fariszuh/SKUBI-Pneumatic/Dokumetasi/IMG-20230215-WA0006.jpg

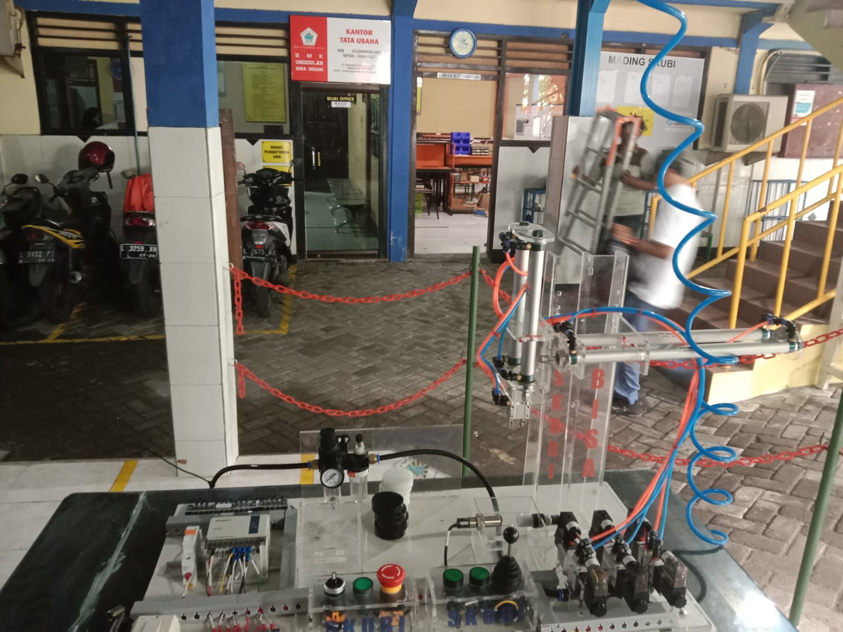
Dokumetasi/IMG-20230215-WA0006.jpg
