fariszuh/SKUBI-Pneumatic/Dokumetasi/IMG-20230215-WA0007.jpg

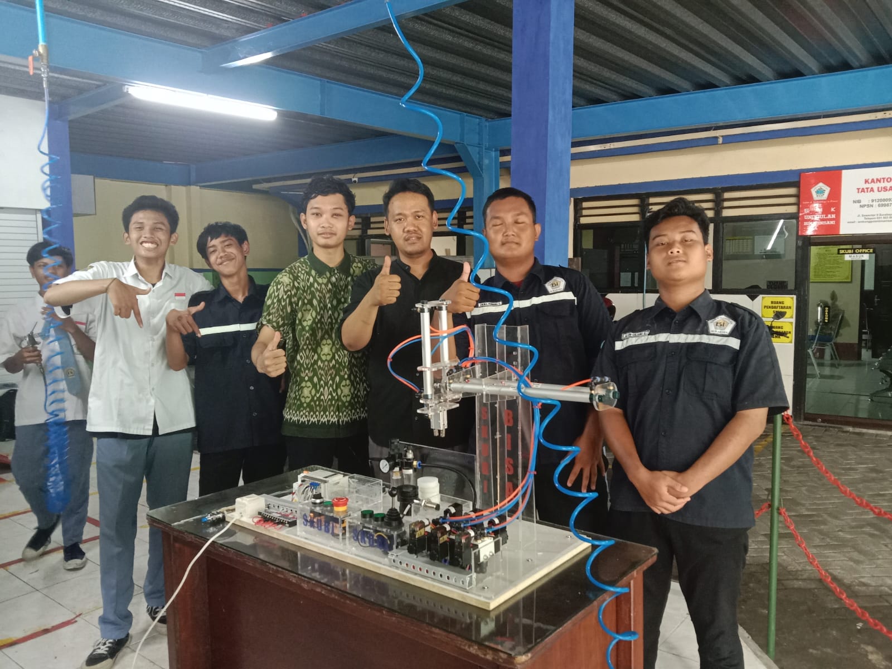
Dokumetasi/IMG-20230215-WA0007.jpg
