fariszuh/SKUBI-Pneumatic/README.md

# SKUBI-Pneumatic
SKUBI Surabaya Pneumatic Pick and Place Module. This project was implemented in SMK Unggulan Bina Insani Surabaya on 2023.
