fariszuh/SKUBI-Pneumatic/File Kirim ke Pak Setya SKUBI/Drawing & Program Book.pdf

# Rev. 0 Published on 17 February 2023

# DRAWING AND PROGRAM

# ELECTRO-PNEUMATIC MODULE

# SMK UNGGULAN BINA INSANI

# SURABAYA

2023

# Rev. 0 Published on 17 February 2023

# Table of Contents:

1. Drawing Sheet 1: Power Distribution from Inlet Steker to PLC 2. Drawing Sheet 2: Digital Input for MELSEC PLC 3. Drawing Sheet 3: Digital Output and 12V Distribution 4. Drawing Sheet 4: Pneumatic Component and Its Flow 5. Drawing Sheet 5: Input Terminal for COM/0V Distribution 6. Ladder Program in GX Works 2

# For further information:

# Muhammad Faris Zuhairi

0821 4345 9880

# zuhairimuhammadfaris@gmail.com

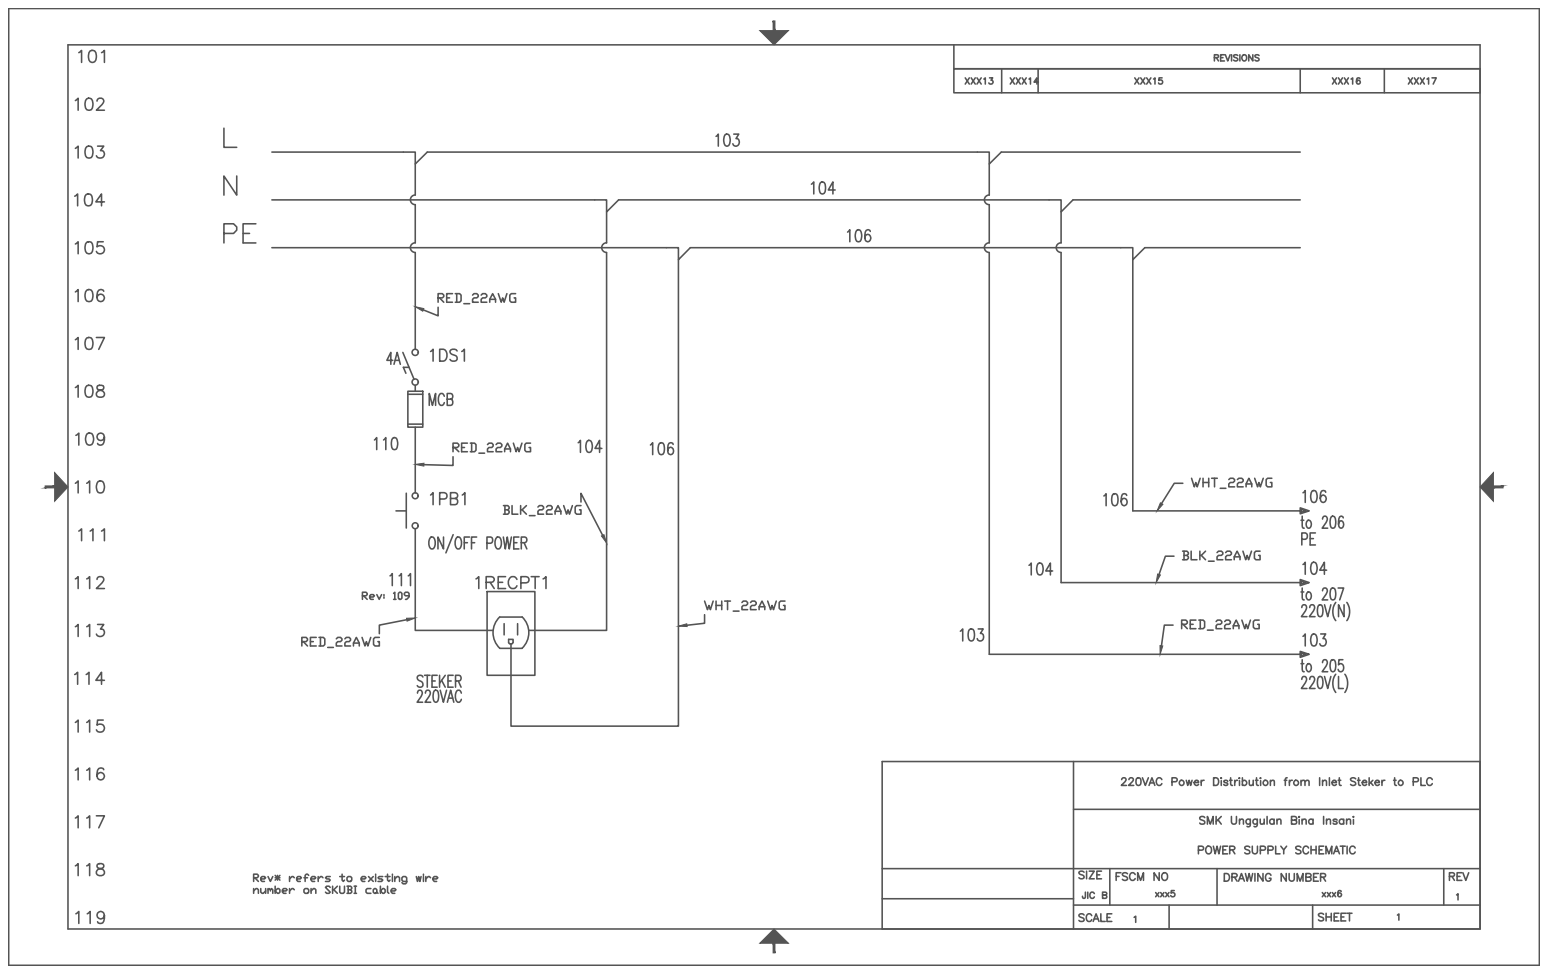
[picture p3: page 3]

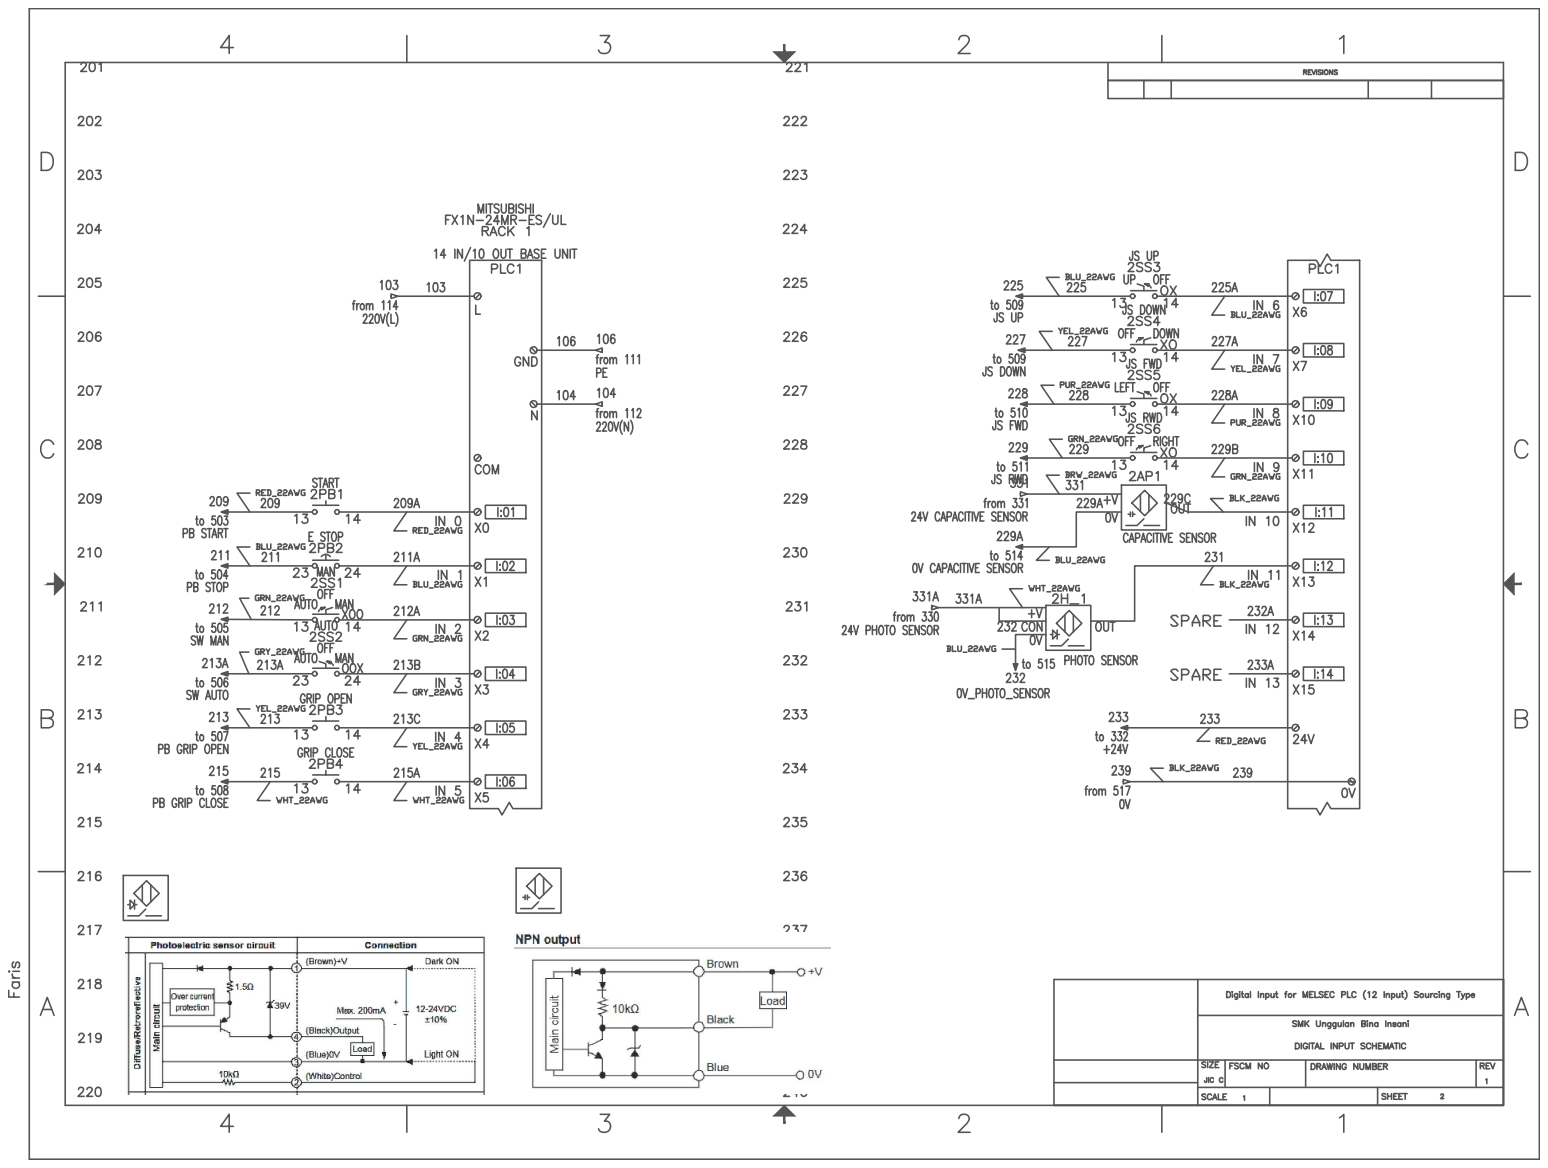
[picture p4: page 4]

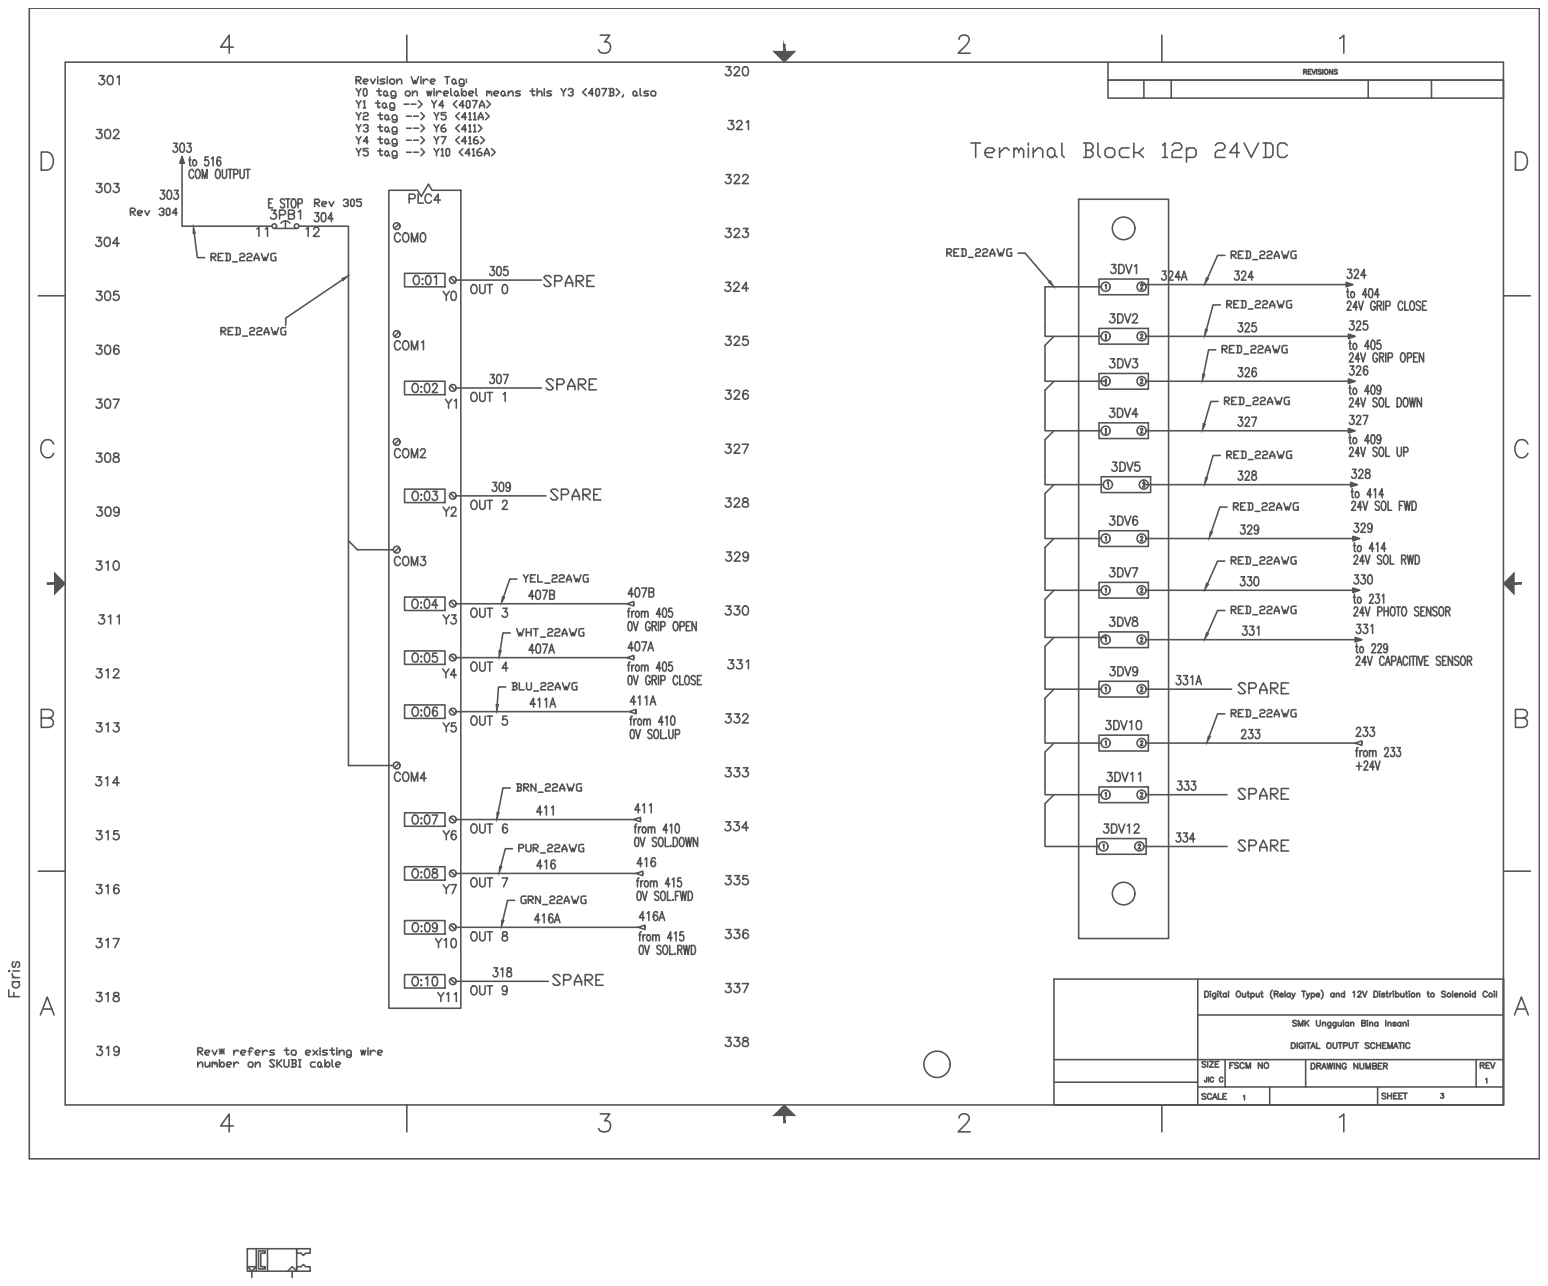
[picture p5: page 5]

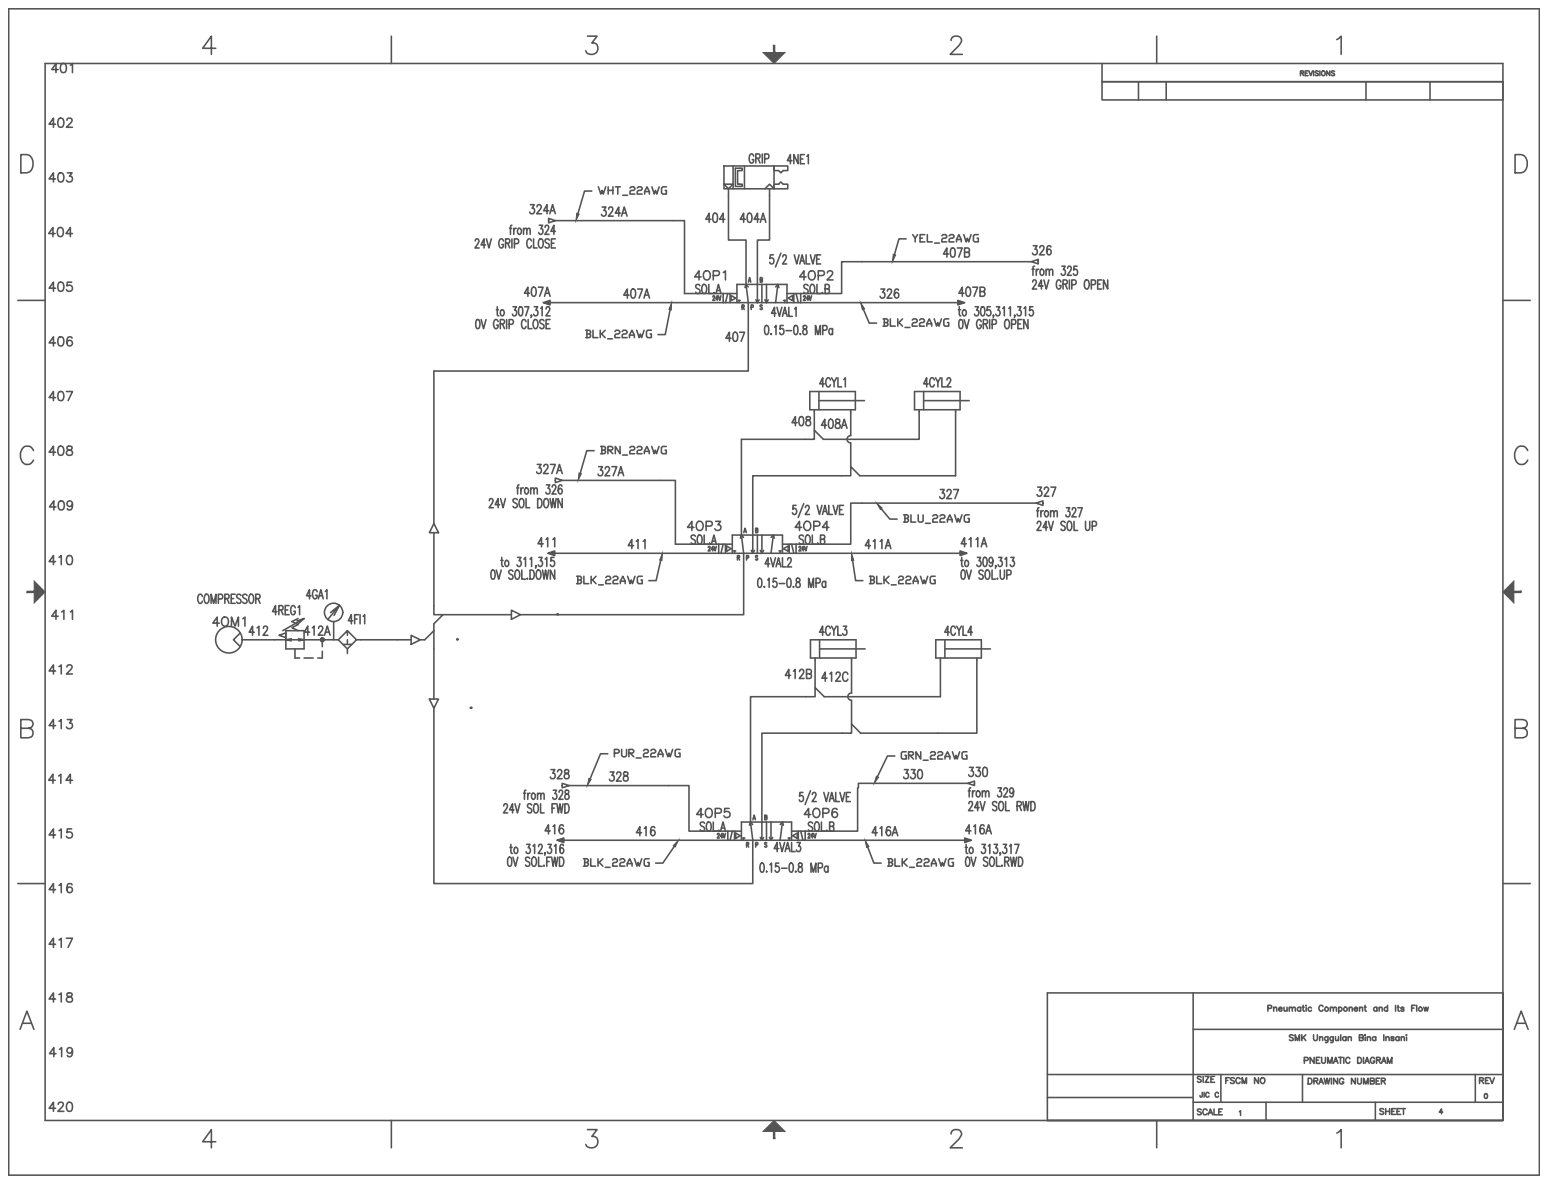
[picture p6: page 6]

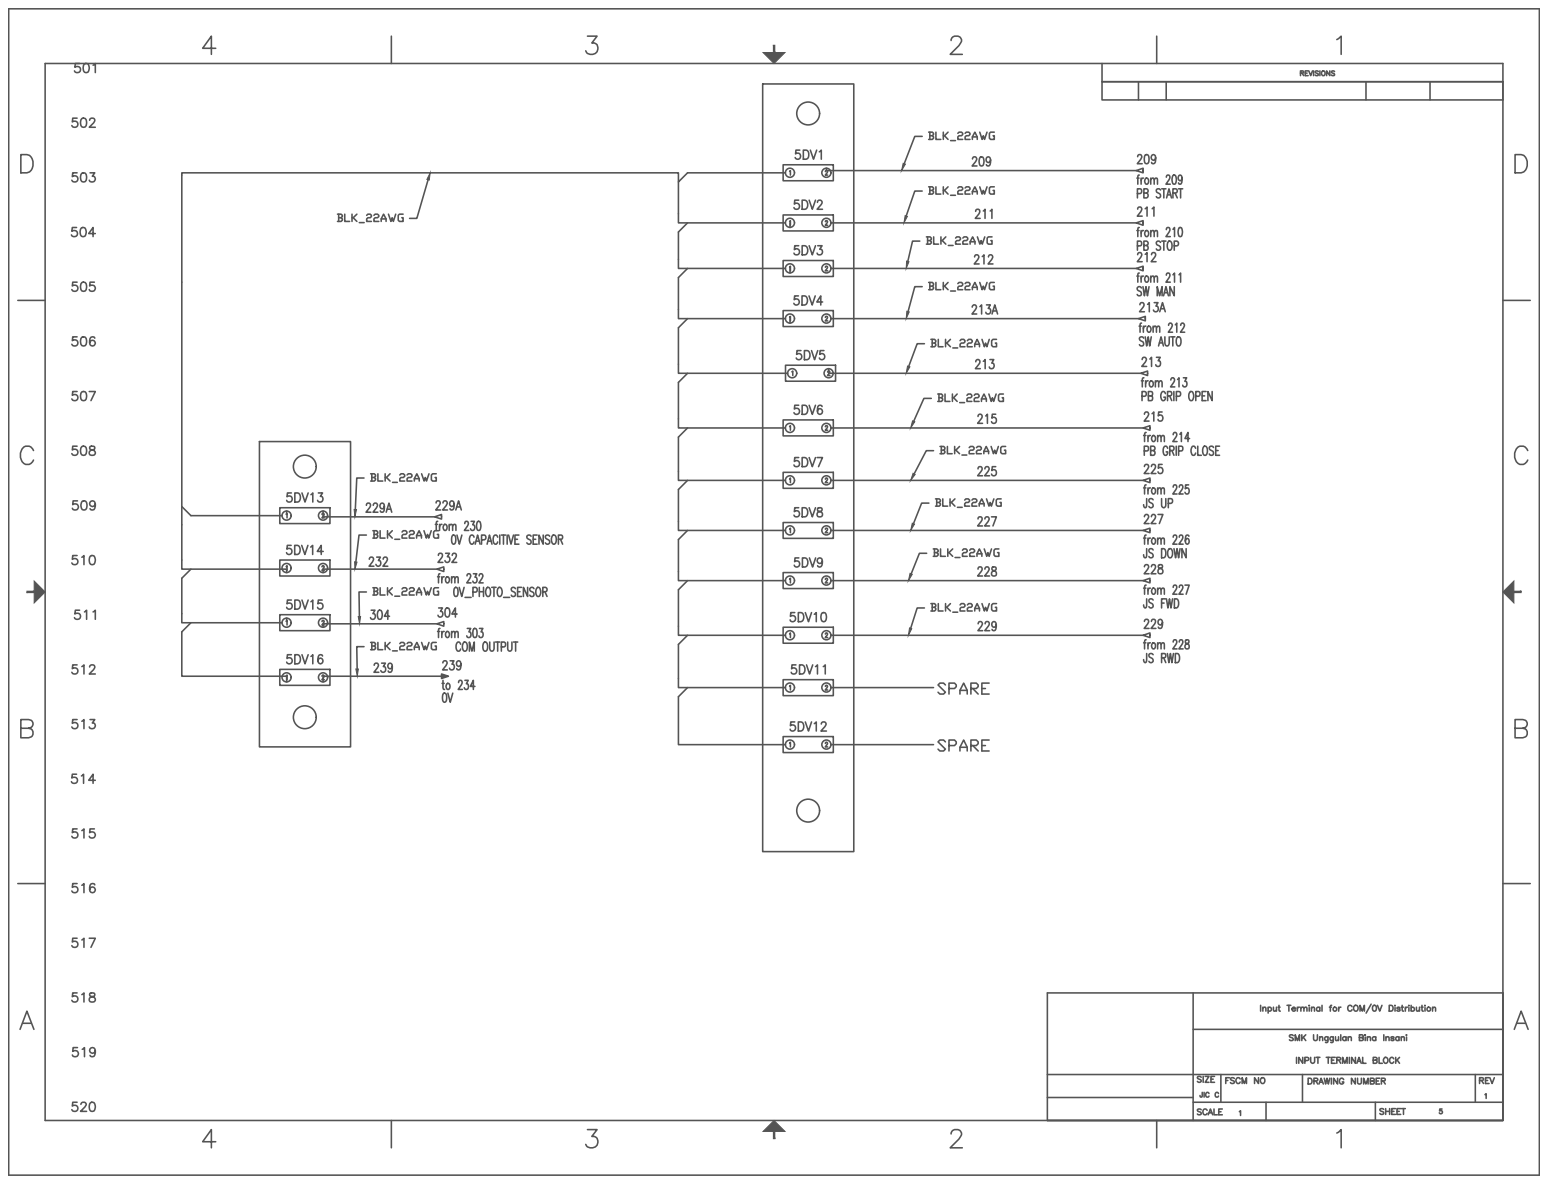
[picture p7: page 7]

# MELSEC FX1N-24MR Program for Electro-Pneumatic Module SKUBI

# Designed with Ladder

# Prepared By Faris

# Published on 17 February 2023

PLC Parameter | 2/17/2023

# Data Name : Memory Capacity Memory Capacity

# [Memory Capacity]

8000

# [Program Capacity] 8000 Steps

# [Comments Capacity] 0 Block 0 Points

# [File Register Capacity 0 Block 0 Points

1

PLC Parameter | 2/17/2023

# Data Name : PLC System PLC System

# [Battery Less Mode]

# [MODEM Initialized] None

# [RUN Terminal Input] None

2

Program setting | 2/17/2023

# Data Name : Program setting

Execution type | Program file name [Title]
Execution Program | MAIN

3

Ladder | 2/17/2023

# Data Name : MAIN

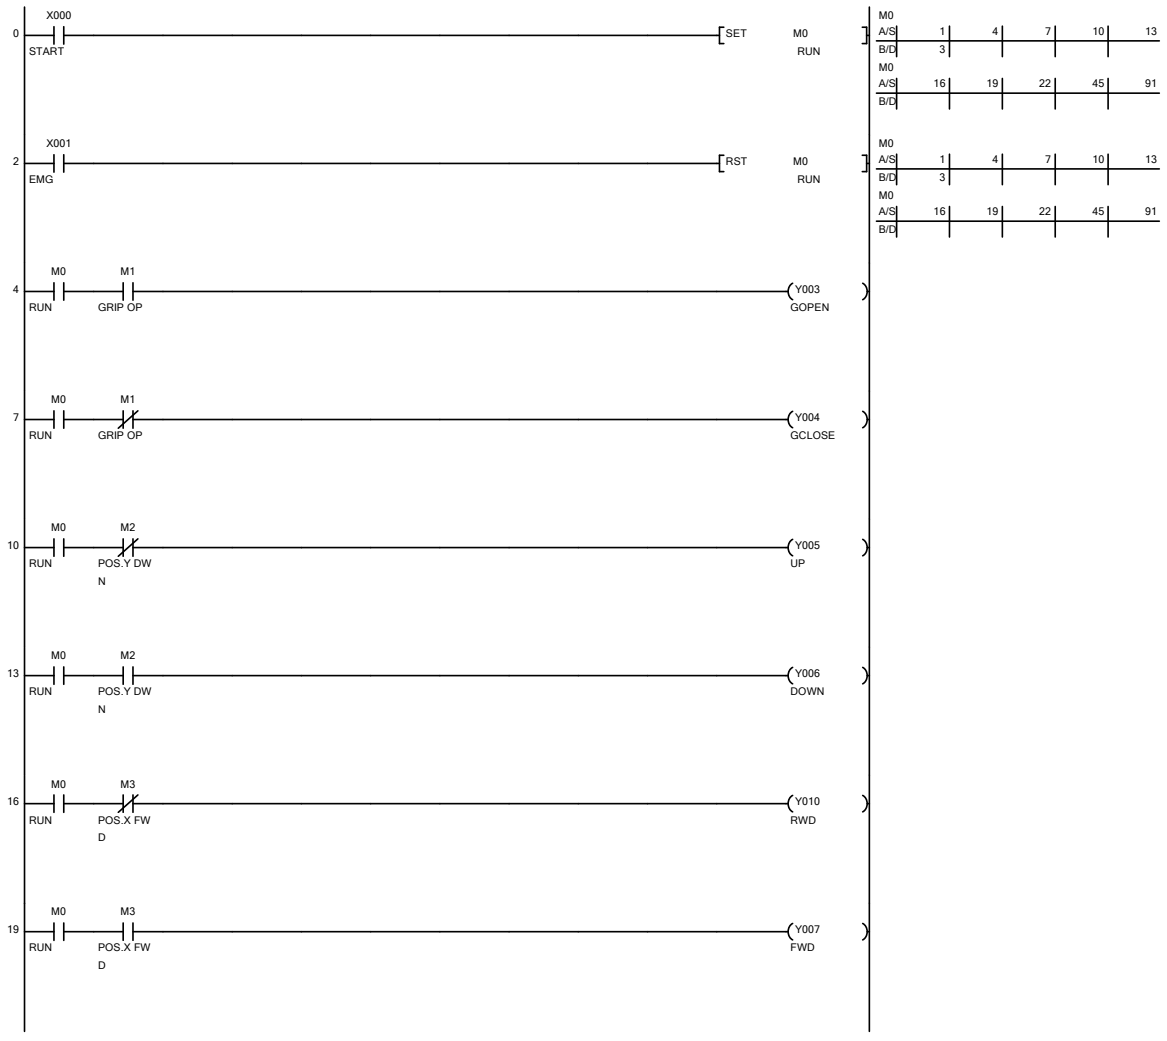
[picture p8: figure]
START; SET; RUN; EMG; RST; GRIP OP; Y003 GOPEN; Y004 GCLOSE; POS.Y DW N; Y006 DOWN; POS.X FW D; Y010 RWD; Y007 FWD

4

22

M0

RUN

X002

MAN

X004

GOPEN

SET | M1
GRIP OP

M1
A/S | 5 | 26 | 60 | 62
B/D | 8 | 29 | 86

X005

GCLOSE

RST | M1
GRIP OP

M1
A/S | 5 | 26 | 60 | 62
B/D | 8 | 29 | 86

X007

JS_DOWN

SET | M2
POS.Y DW
N

M2
A/S | 14 | 32 | 73 | 75
B/D | 11 | 35 | 105

X006

JS_UP

RST | M2
POS.Y DW
N

M2
A/S | 14 | 32 | 73 | 75
B/D | 11 | 35 | 105

X010

JS_FWD

SET | M3
POS.X FW
D

M3
A/S | 20 | 38 | 57 | 70 | 83
B/D | 17 | 41 | 54 | 68 | 81
M3
A/S | 89 | 102 | 114 | 116
B/D | 100 | 123

X011

JS_RWD

RST | M3
POS.X FW
D

M3
A/S | 20 | 38 | 57 | 70 | 83
B/D | 17 | 41 | 54 | 68 | 81
M3
A/S | 89 | 102 | 114 | 116
B/D | 100 | 123

42

X012

SEN_CAP

X013

SEN_PH

SET | M4
ADA_BEND
A

M4
A/S | 44 | 48 | 82 | 113
B/D | 90 | 122
Ladder | 2/17/2023

# Data Name : MAIN

5

Ladder | 2/17/2023

# Data Name : MAIN

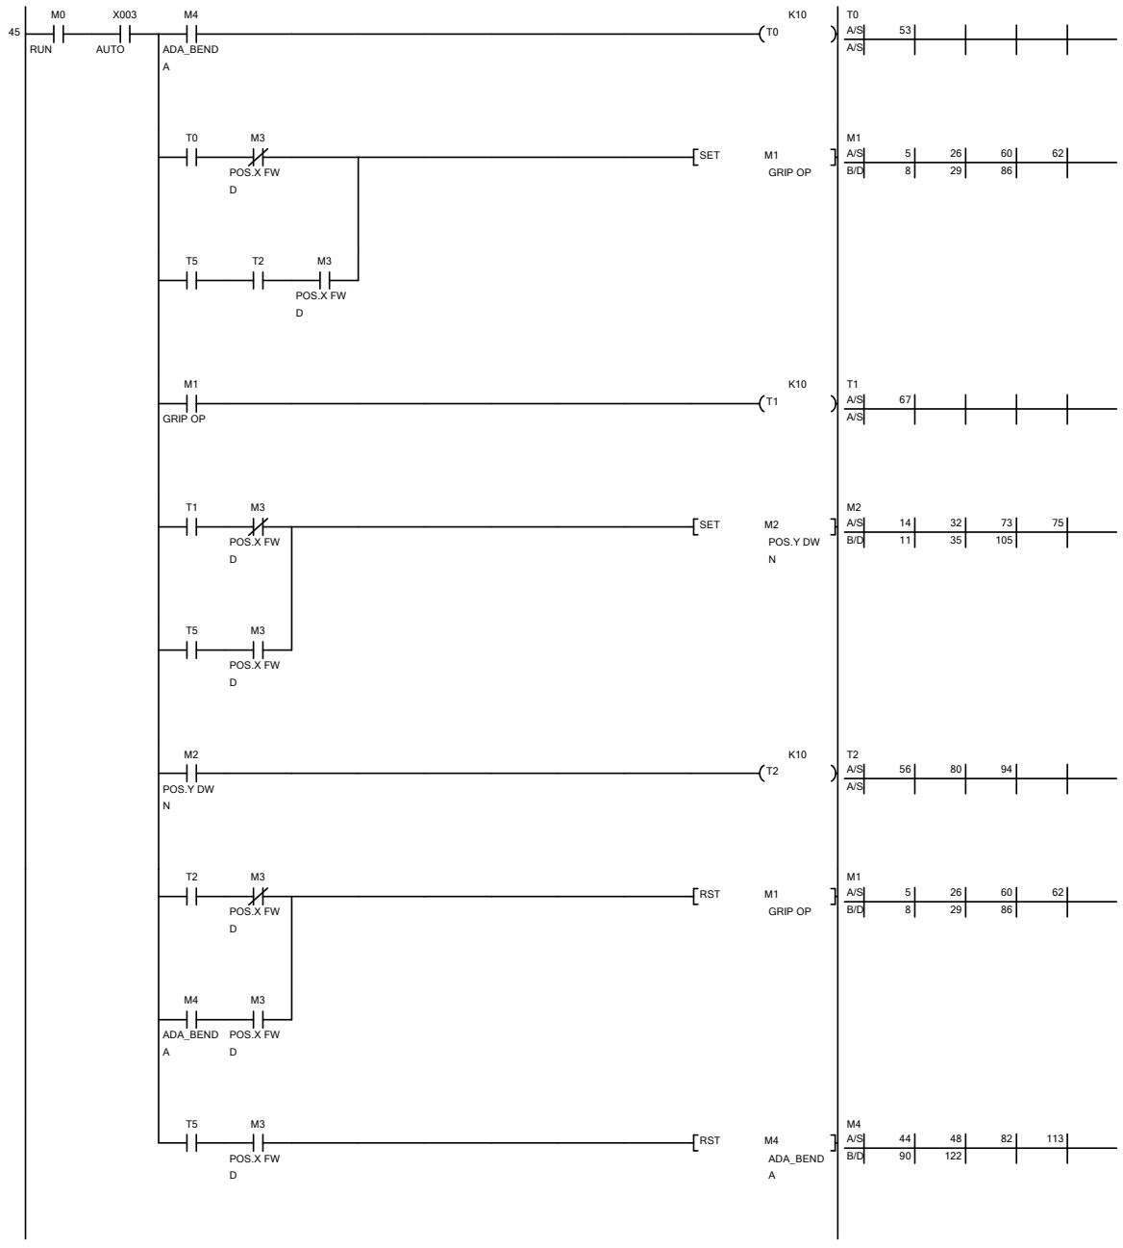
[picture p9: figure]
RUN; AUTO; ADA_BEND A; POS.X FW D; SET; GRIP OP; POS.Y DW N; RST

6

Ladder | 2/17/2023

# Data Name : MAIN

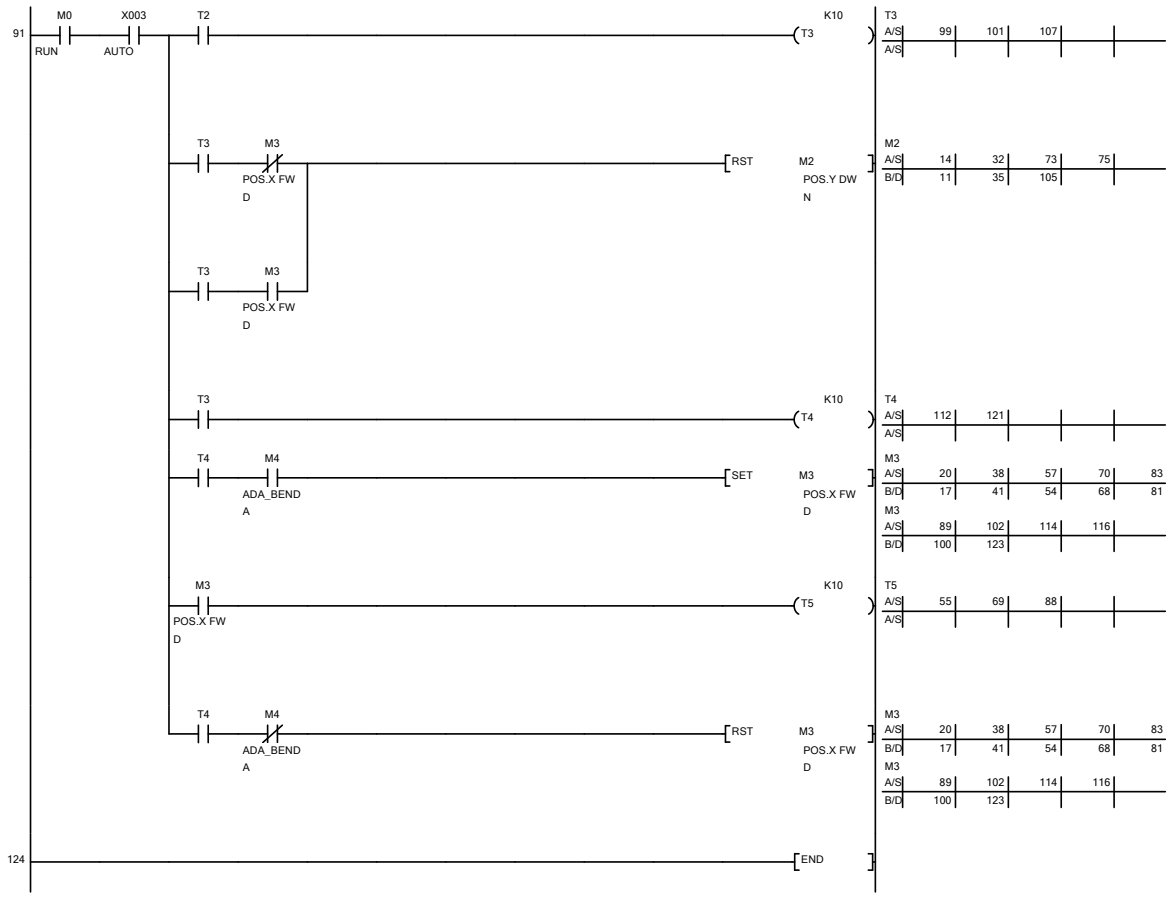
[picture p10: figure]
RUN; AUTO; POS.X FW D; RST; POS.Y DW N; ADA_BEND A; SET; 124 END

7

Device Comment | 2/17/2023

# Data Name : COMMENT

Device Name | Comment
M0 | RUN
M1 | GRIP OP
M2 | POS.Y DWN
M3 | POS.X FWD
M4 | ADA_BENDA
X000 | START
X001 | EMG
X002 | MAN
X003 | AUTO
X004 | GOPEN
X005 | GCLOSE
X006 | JS_UP
X007 | JS_DOWN
X010 | JS_FWD
X011 | JS_RWD
X012 | SEN_CAP
X013 | SEN_PH
Y003 | GOPEN
Y004 | GCLOSE
Y005 | UP
Y006 | DOWN
Y007 | FWD
Y010 | RWD

8

TC Setting | 2/17/2023

# Data Name : MAIN

Position | Device | Setting Value
( 49) T0 | | K10
( 63) T1 | | K10
( 76) T2 | | K10
( 95) T3 | | K10
( 108) T4 | | K10
( 117) T5 | | K10

9

Device List | 2/17/2023

# Data Name : Device List

# Find In:(Entire project) Find What:Used Device (Contact & Coil) Print Range:Whole Range

# *:in use (times): the number of coil uses

Device | Contact | Coil | Parameter | Comment
M0 | * | *( 2) | | RUN
M1 | * | *( 4) | | GRIP OP
M2 | * | *( 4) | | POS.Y DWN
M3 | * | *( 4) | | POS.X FWD
M4 | * | *( 2) | | ADA_BENDA
T0 | * | *( 1)
T1 | * | *( 1)
T2 | * | *( 1)
T3 | * | *( 1)
T4 | * | *( 1)
T5 | * | *( 1)

10

Project Contents List | 2/17/2023

# Data Name : Project Contents List Workspace Name : Project Name : SKUBI_program_work_simplified Title :

Data Name | Last Change | Title
Parameter | 2/1/2023 8:41:58 PM
PLC Parameter | 2/1/2023 8:41:58 PM
Global Device Comment | 2/15/2023 12:51:23 AM

### Program Setting Execution Program

MAIN | 2/1/2023 8:42:03 PM
MAIN | 2/15/2023 12:54:52 AM

### POU

Program | 2/1/2023 8:42:03 PM
MAIN | 2/15/2023 12:54:52 AM

### Local Device Comment

Device Memory | 2/1/2023 8:42:05 PM
MAIN | 2/1/2023 8:42:05 PM

11
