fariszuh/SKUBI-Pneumatic/PLC MELSEC/Ladder Pneumatik Faris.pdf

# Title

# Comment

# Prepared By

# Date

PLC Parameter | 2/2/2023

# Data Name : Memory Capacity Memory Capacity

# [Memory Capacity]

8000

# [Program Capacity] 8000 Steps

# [Comments Capacity] 0 Block 0 Points

# [File Register Capacity 0 Block 0 Points

1

PLC Parameter | 2/2/2023

# Data Name : PLC System PLC System

# [Battery Less Mode]

# [MODEM Initialized] None

# [RUN Terminal Input] None

2

Program setting | 2/2/2023

# Data Name : Program setting

Execution type | Program file name [Title]
Execution Program | MAIN

3

Ladder | 2/2/2023

# Data Name : MAIN

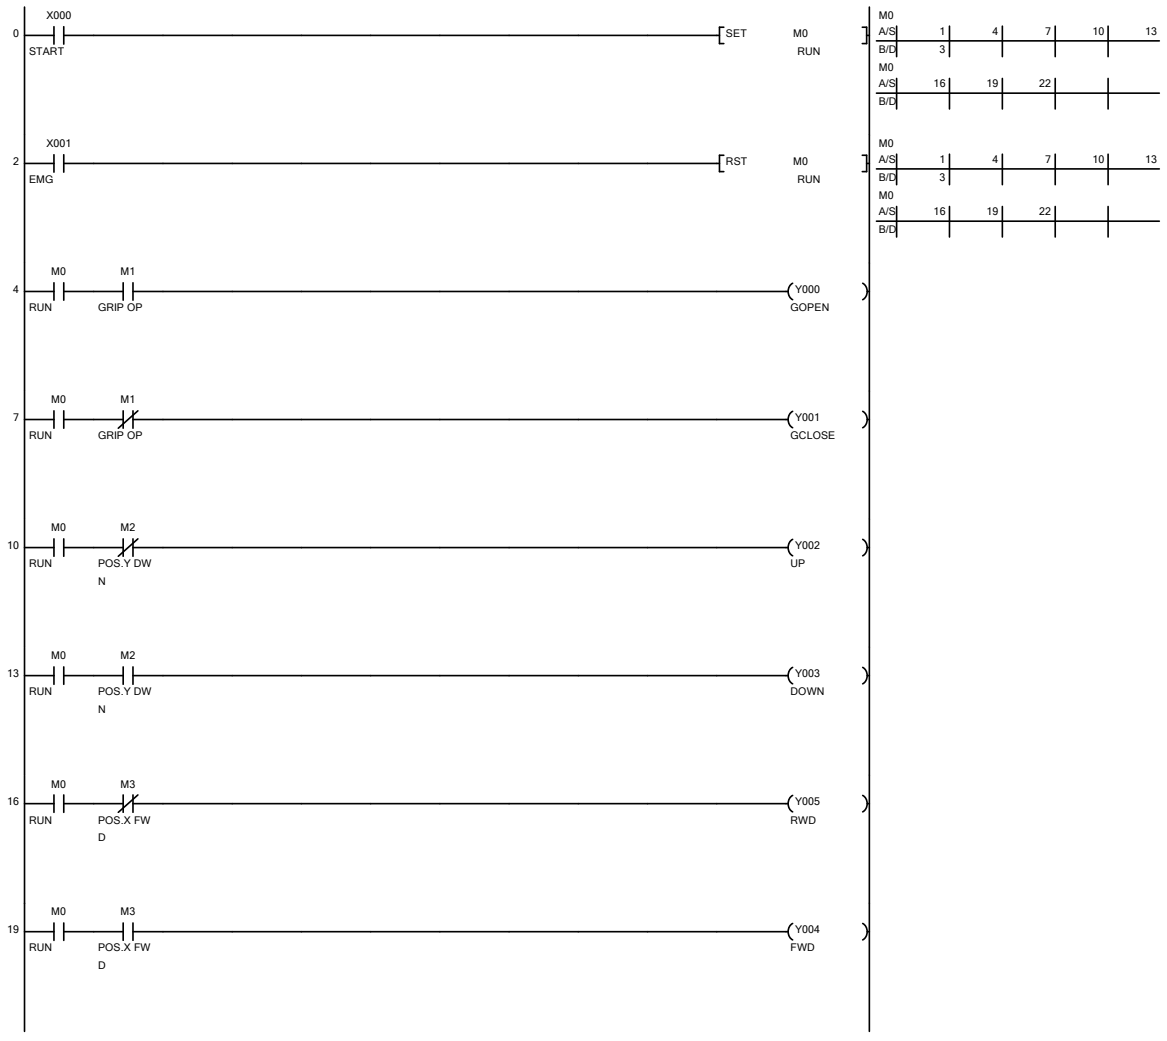
[picture p11: figure]
START; SET; RUN; EMG; RST; GRIP OP; Y000 GOPEN; Y001 GCLOSE; POS.Y DW N; Y003 DOWN; POS.X FW D; Y005 RWD; Y004 FWD

4

Ladder | 2/2/2023

# Data Name : MAIN

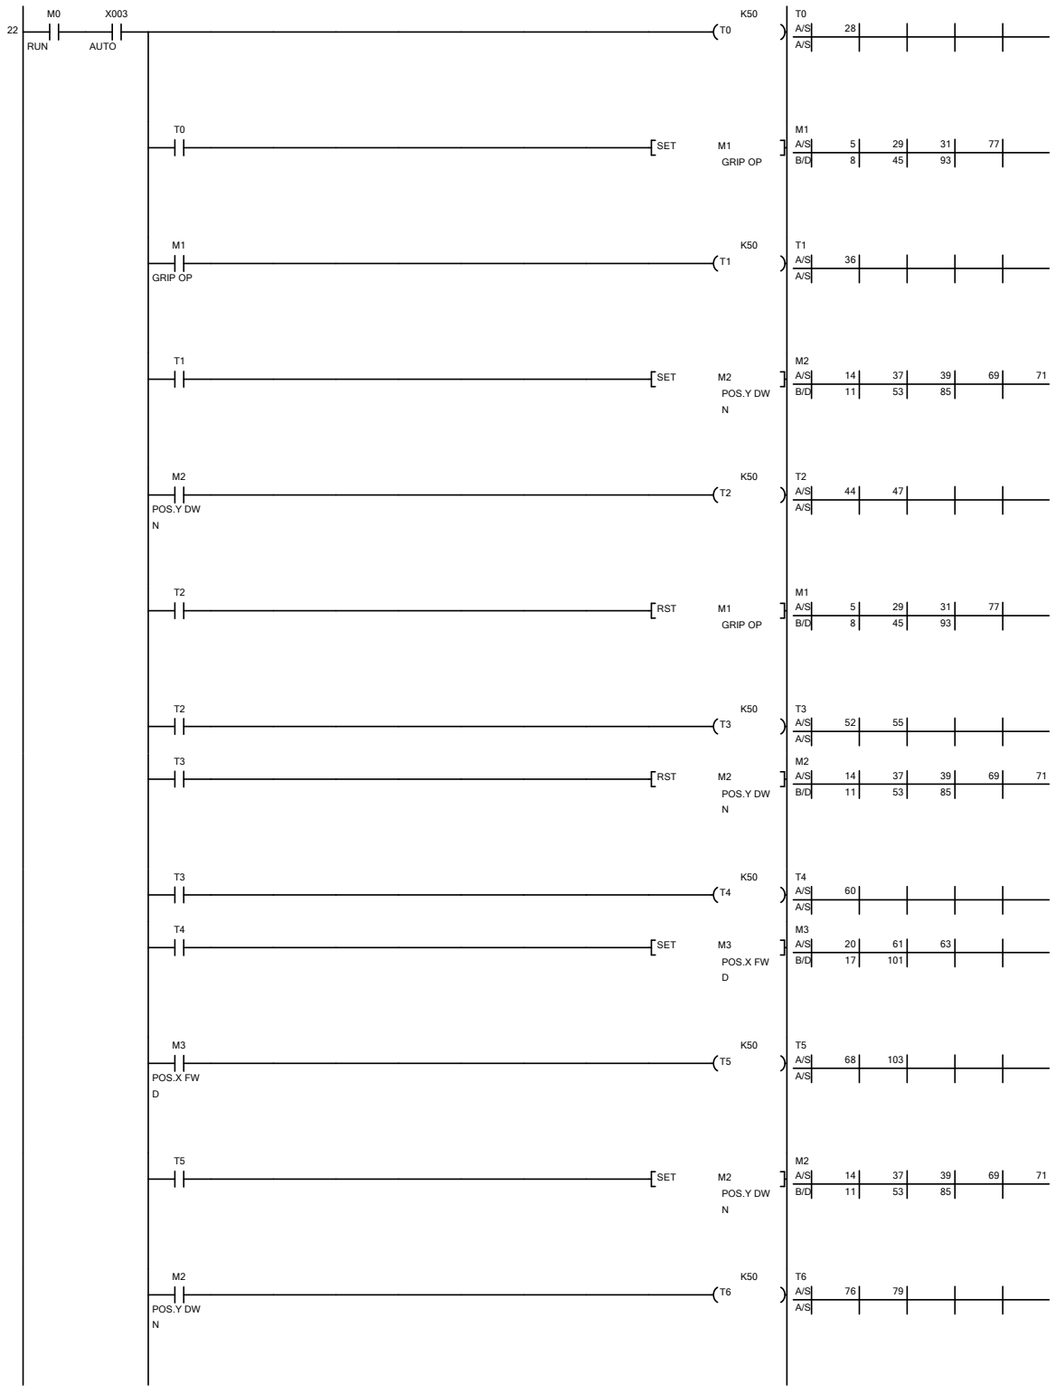
[picture p12: figure]
RUN; AUTO; SET; GRIP OP; POS.Y DW N; RST; POS.X FW D

5

Ladder | 2/2/2023

# Data Name : MAIN

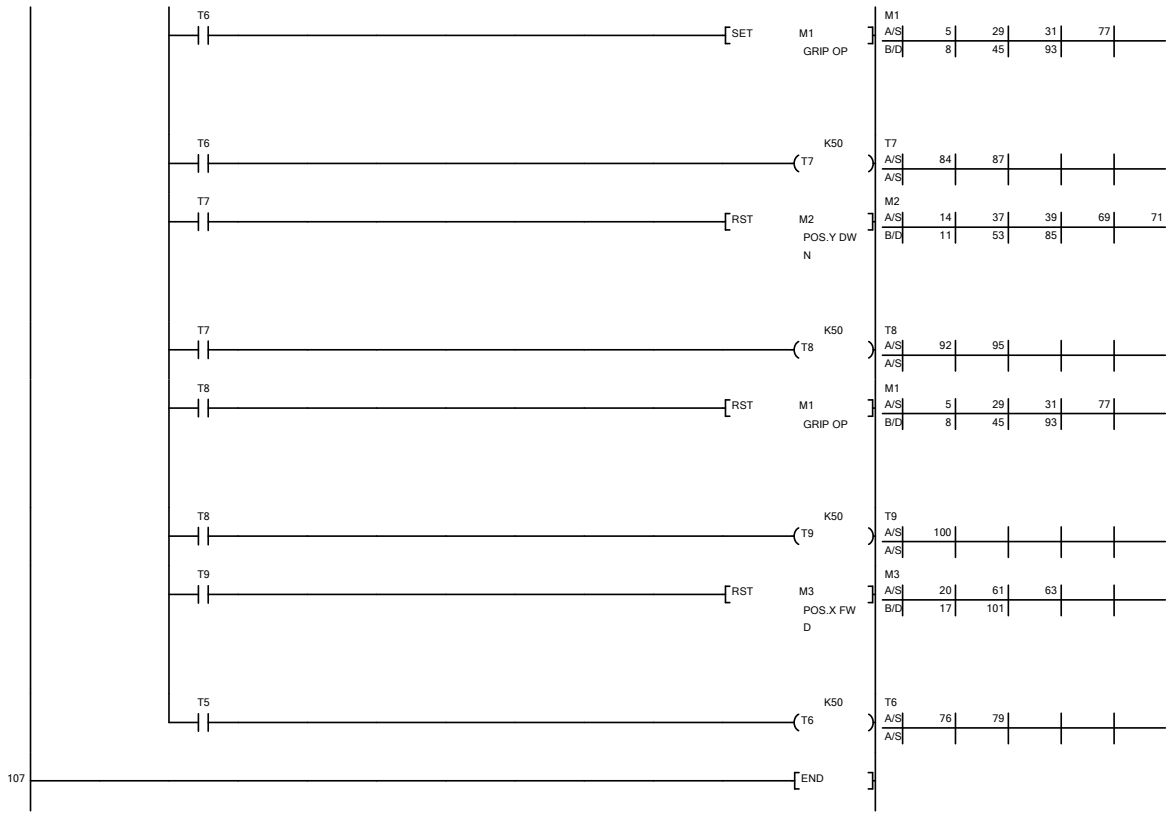
[picture p13: figure]
SET; GRIP OP; RST; POS.Y DW N; POS.X FW D; 107 END

6

Device Comment | 2/2/2023

# Data Name : COMMENT

Device Name | Comment
M0 | RUN
M1 | GRIP OP
M2 | POS.Y DWN
M3 | POS.X FWD
X000 | START
X001 | EMG
X002 | MAN
X003 | AUTO
X004 | GOPEN
X005 | GCLOSE
X006 | JS_UP
X007 | JS_DOWN
X010 | JS_FWD
X011 | JS_RWD
Y000 | GOPEN
Y001 | GCLOSE
Y002 | UP
Y003 | DOWN
Y004 | FWD
Y005 | RWD

7

TC Setting | 2/2/2023

# Data Name : MAIN

Position | Device | Setting Value
( 24) T0 | | K50
( 32) T1 | | K50
( 40) T2 | | K50
( 48) T3 | | K50
( 56) T4 | | K50
( 64) T5 | | K50
( 72) T6 | | K50
( 80) T7 | | K50
( 88) T8 | | K50
( 96) T9 | | K50
( 104) T6 | | K50

8

Device List | 2/2/2023

# Data Name : Device List

# Find In:(Entire project) Find What:Used Device (Contact & Coil) Print Range:Whole Range

# *:in use (times): the number of coil uses

Device | Contact | Coil | Parameter | Comment
M0 | * | *( 2) | | RUN
M1 | * | *( 4) | | GRIP OP
M2 | * | *( 4) | | POS.Y DWN
M3 | * | *( 2) | | POS.X FWD
T0 | * | *( 1)
T1 | * | *( 1)
T2 | * | *( 1)
T3 | * | *( 1)
T4 | * | *( 1)
T5 | * | *( 1)
T6 | * | *( 2)
T7 | * | *( 1)
T8 | * | *( 1)
T9 | * | *( 1)

9

Project Contents List | 2/2/2023

# Data Name : Project Contents List Workspace Name : Project Name : SKUBI_program_worked Title :

Data Name | Last Change | Title
Parameter | 2/1/2023 8:41:58 PM
PLC Parameter | 2/1/2023 8:41:58 PM
Global Device Comment | 2/2/2023 12:32:41 AM

### Program Setting Execution Program

MAIN | 2/1/2023 8:42:03 PM
MAIN | 2/2/2023 1:14:20 AM

### POU

Program | 2/1/2023 8:42:03 PM
MAIN | 2/2/2023 1:14:20 AM

### Local Device Comment

Device Memory | 2/1/2023 8:42:05 PM
MAIN | 2/1/2023 8:42:05 PM

10
