fariszuh/SKUBI-Pneumatic/Ladder Design.pdf

# noname00.src

# Program

2023.1.24

## c:\gmwin 4\\source\skubi_v1\noname00.src

## º¯¼ö

1

Variable name | Variable kind | Data type | (Memory allocation) (Initial value)
BT_AUTO | VAR | BOOL AT %IX0.0.3
BT_EMG | VAR | BOOL AT %IX0.0.1
BT_GRIP_CLOSE VAR | | BOOL AT %IX0.0.5
BT_GRIP_OPEN | VAR | BOOL AT %IX0.0.4
BT_MAN | VAR | BOOL AT %IX0.0.2
BT_START | VAR | BOOL AT %IX0.0.0
CO_DOWN | VAR | BOOL AT %QX0.2.3
CO_FWD | VAR | BOOL AT %QX0.2.4
CO_GRIP_CLOSE VAR | | BOOL AT %QX0.2.1
CO_GRIP_OPEN | VAR | BOOL AT %QX0.2.0
CO_RWD | VAR | BOOL AT %QX0.2.5
CO_UP | VAR | BOOL AT %QX0.2.2
INST0 | VAR | FB Instance
INST1 | VAR | FB Instance
INST10 | VAR | FB Instance
INST11 | VAR | FB Instance
INST12 | VAR | FB Instance
INST13 | VAR | FB Instance
INST14 | VAR | FB Instance
INST15 | VAR | FB Instance
INST2 | VAR | FB Instance
INST3 | VAR | FB Instance
INST4 | VAR | FB Instance
INST5 | VAR | FB Instance
INST6 | VAR | FB Instance
INST7 | VAR | FB Instance
INST8 | VAR | FB Instance
INST9 | VAR | FB Instance
JS_DOWN | VAR | BOOL AT %IX0.0.7
JS_FWD | VAR | BOOL AT %IX0.0.8
JS_RWD | VAR | BOOL AT %IX0.0.9
JS_UP | VAR | BOOL AT %IX0.0.6
MEM_ADABENDA VAR | | BOOL
MEM_DOWN_AMBILVAR | | BOOL
MEM_DOWN_MANVAR | | BOOL
MEM_DOWN_TARUHVAR | | BOOL
MEM_FWD_AMBILVAR | | BOOL
MEM_FWD_MAN VAR | BOOL

## c:\gmwin 4\\source\skubi_v1\noname00.src

## º¯¼ö

2

Variable name | Variable kind | Data type | (Memory allocation) (Initial value)
MEM_GCLOSE_AMBIL VAR | | BOOL
MEM_GCLOSE_MANVAR | | BOOL
MEM_GCLOSE_TARUH VAR | | BOOL
MEM_GOPEN_AMBILVAR | | BOOL
MEM_GOPEN_MANVAR | | BOOL
MEM_GOPEN_TARUH VAR | | BOOL
MEM_MODEMAN | VAR | BOOL
MEM_MODERESETVAR | | BOOL
MEM_RWD_MAN | VAR | BOOL
MEM_RWD_TARUHVAR | | BOOL
MEM_STAT_RUN | VAR | BOOL
MEM_TARUHBENDAVAR | | BOOL
MEM_UP_AMBIL | VAR | BOOL
MEM_UP_MAN | VAR | BOOL
MEM_UP_TARUH VAR | | BOOL
SELESAI | VAR | BOOL
SEN_CAP | VAR | BOOL AT %IX0.0.11
SEN_PH | VAR | BOOL AT %IX0.0.10

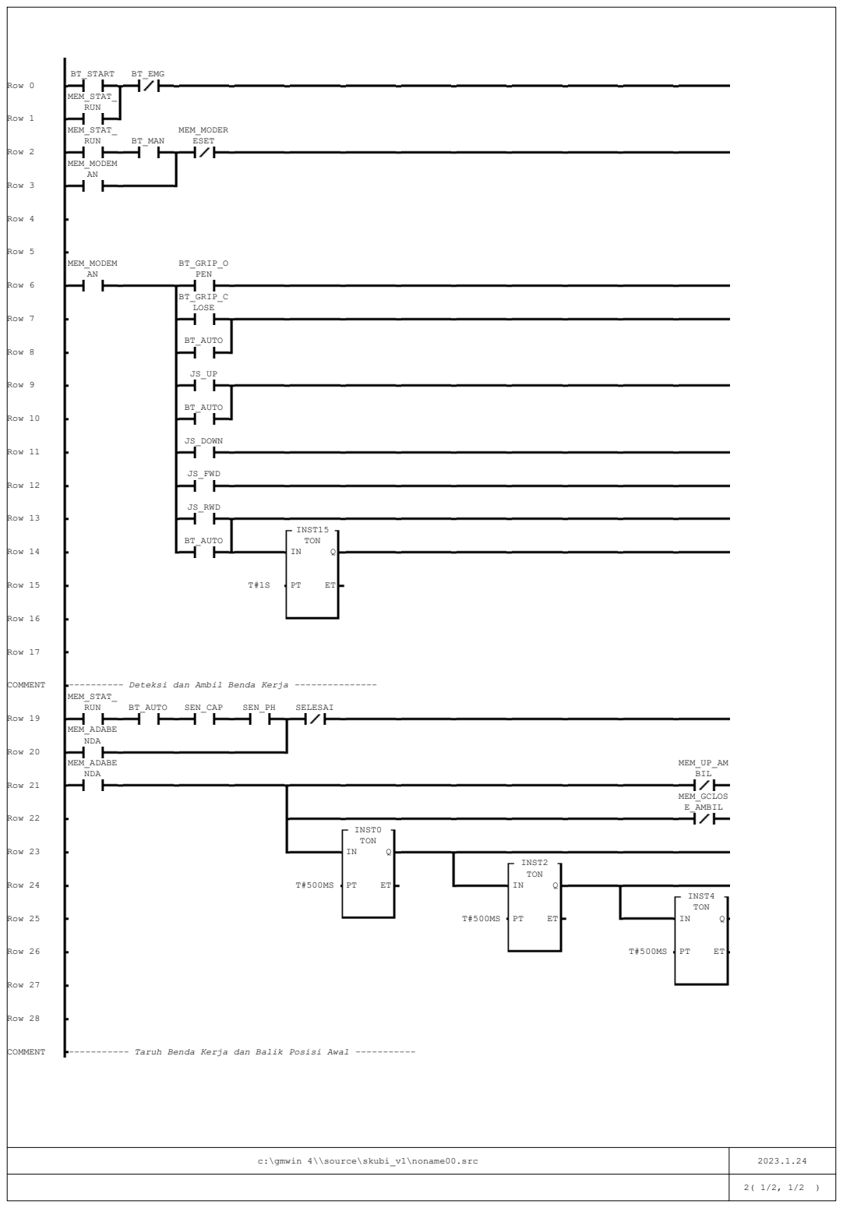
[picture p20: page 4]

c:\gmwin 4\\source\skubi_v1\noname00.src | 2023.1.24
| 2( 1/2, 1/2 )

Row 0

BT_START BT_EMG

Row 1

MEM_STAT_
RUN

Row 2

MEM_STAT_
RUN BT_MAN

MEM_MODER
ESET

Row 3

MEM_MODEM
AN

Row 4

Row 5

Row 6

MEM_MODEM
AN

BT_GRIP_O
PEN

Row 7

BT_GRIP_C
LOSE

Row 8

BT_AUTO

Row 9

JS_UP

Row 10

BT_AUTO

Row 11

JS_DOWN

Row 12

JS_FWD

Row 13

JS_RWD

Row 14

BT_AUTO | TON
IN | Q

INST15

Row 15 | T#1S | PT | ET

Row 16

Row 17

COMMENT ---------- Deteksi dan Ambil Benda Kerja ---------------

Row 19

MEM_STAT_
RUN | BT_AUTO | SEN_CAP | SEN_PH | SELESAI

Row 20

MEM_ADABE
NDA

Row 21

MEM_ADABE
NDA

MEM_UP_AM
BIL

Row 22

MEM_GCLOS
E_AMBIL

Row 23

TON
IN Q

INST0

Row 24 | T#500MS PT | ET

TON
IN Q

INST2

Row 25 | T#500MS PT | ET

TON
IN Q

INST4

Row 26 | T#500MS PT | ET

Row 27

Row 28

COMMENT ----------- Taruh Benda Kerja dan Balik Posisi Awal -----------

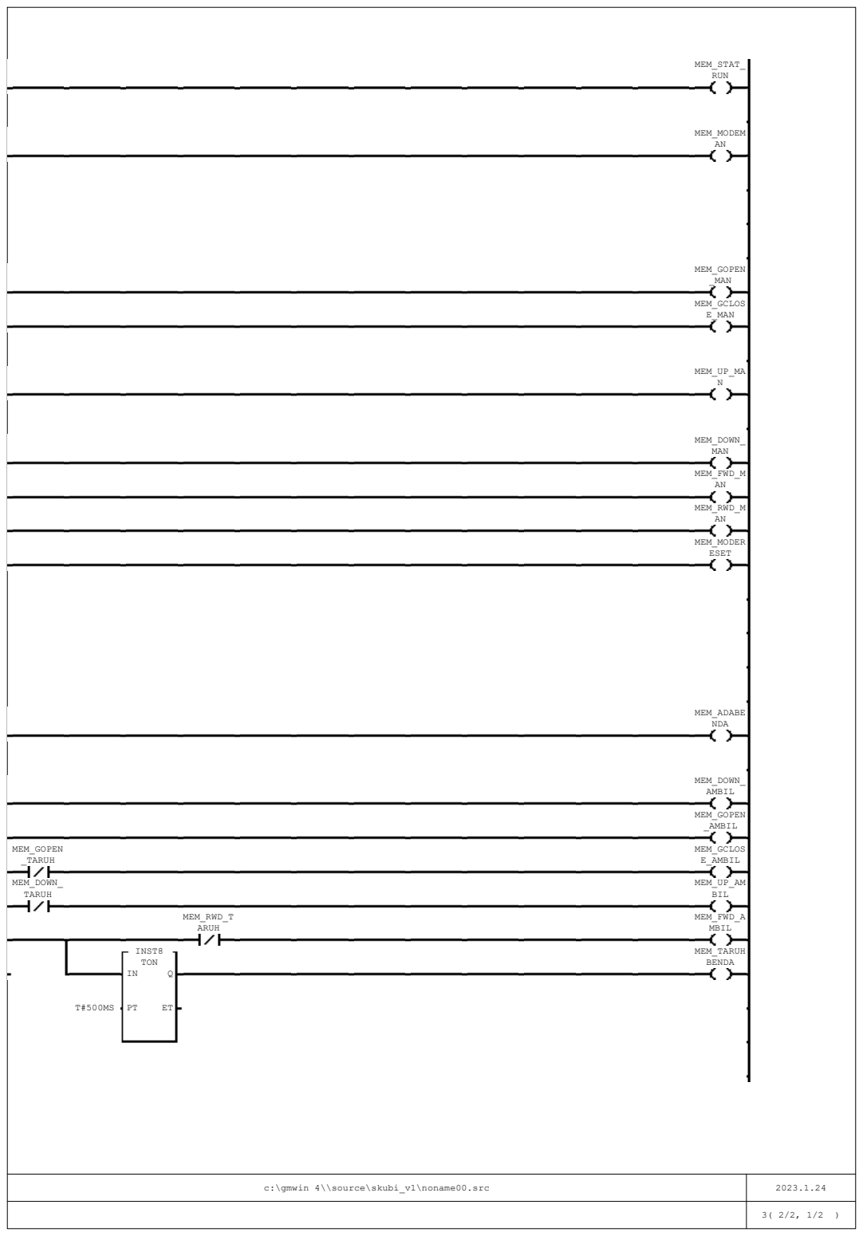
[picture p21: page 5]

3( 2/2, 1/2 )

MEM_STAT_
RUN

MEM_MODEM
AN

MEM_GOPEN
_MAN

MEM_GCLOS
E_MAN

MEM_UP_MA
N

MEM_DOWN_
MAN

MEM_FWD_M
AN

MEM_RWD_M
AN

MEM_MODER
ESET

MEM_ADABE
NDA

MEM_DOWN_
AMBIL

MEM_GOPEN
_AMBIL

MEM_GOPEN
_TARUH

MEM_GCLOS
E_AMBIL

MEM_DOWN_
TARUH

MEM_UP_AM
BIL

MEM_RWD_T
ARUH

MEM_FWD_A
MBIL

TON
IN | Q
INST8 | MEM_TARUH
| BENDA
T#500MS PT | ET

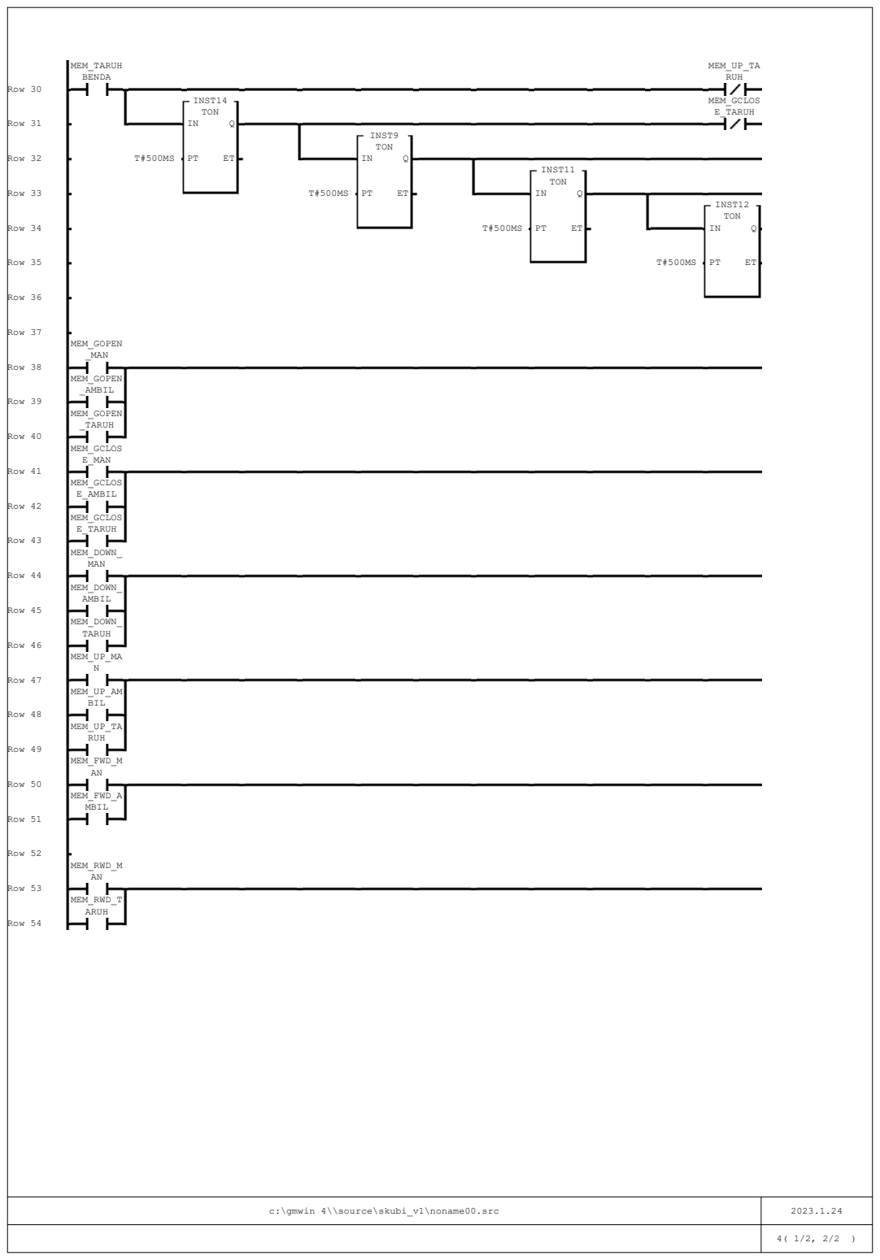
[picture p22: page 6]

4( 1/2, 2/2 )

Row 30

MEM_TARUH
BENDA

MEM_UP_TA
RUH

Row 31

TON
IN | Q
INST14 | MEM_GCLOS
| E_TARUH
Row 32 | T#500MS PT | ET

TON
IN Q

INST9

Row 33 | T#500MS PT | ET

TON
IN Q

INST11

Row 34 | T#500MS PT | ET

TON
IN Q

INST12

Row 35 | T#500MS PT | ET

Row 36

Row 37

Row 38

MEM_GOPEN
_MAN

Row 39

MEM_GOPEN
_AMBIL

Row 40

MEM_GOPEN
_TARUH

Row 41

MEM_GCLOS
E_MAN

Row 42

MEM_GCLOS
E_AMBIL

Row 43

MEM_GCLOS
E_TARUH

Row 44

MEM_DOWN_
MAN

Row 45

MEM_DOWN_
AMBIL

Row 46

MEM_DOWN_
TARUH

Row 47

MEM_UP_MA
N

Row 48

MEM_UP_AM
BIL

Row 49

MEM_UP_TA
RUH

Row 50

MEM_FWD_M
AN

Row 51

MEM_FWD_A
MBIL

Row 52

Row 53

MEM_RWD_M
AN

Row 54

MEM_RWD_T
ARUH

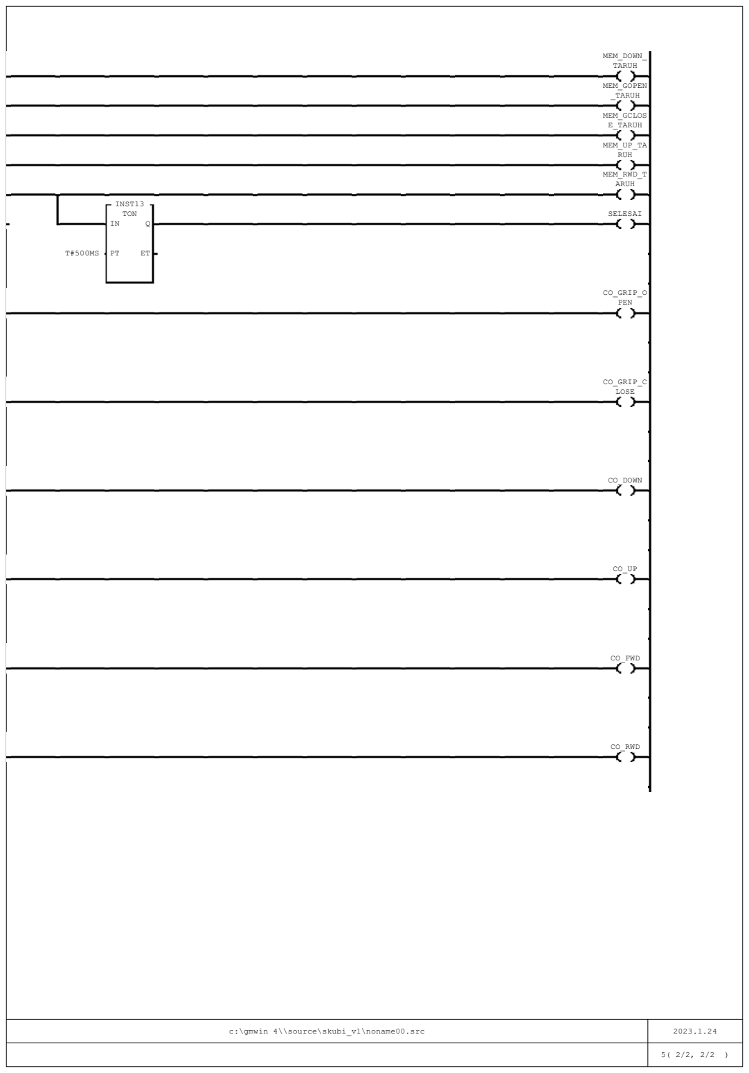
[picture p23: page 7]

5( 2/2, 2/2 )

MEM_DOWN_
TARUH

MEM_GOPEN
_TARUH

MEM_GCLOS
E_TARUH

MEM_UP_TA
RUH

MEM_RWD_T
ARUH

TON
IN Q

INST13
SELESAI

T#500MS PT ET

CO_GRIP_O
PEN

CO_GRIP_C
LOSE

CO_DOWN

CO_UP

CO_FWD

CO_RWD
