fariszuh/SKUBI-Pneumatic/Ladder PLC LG.pdf

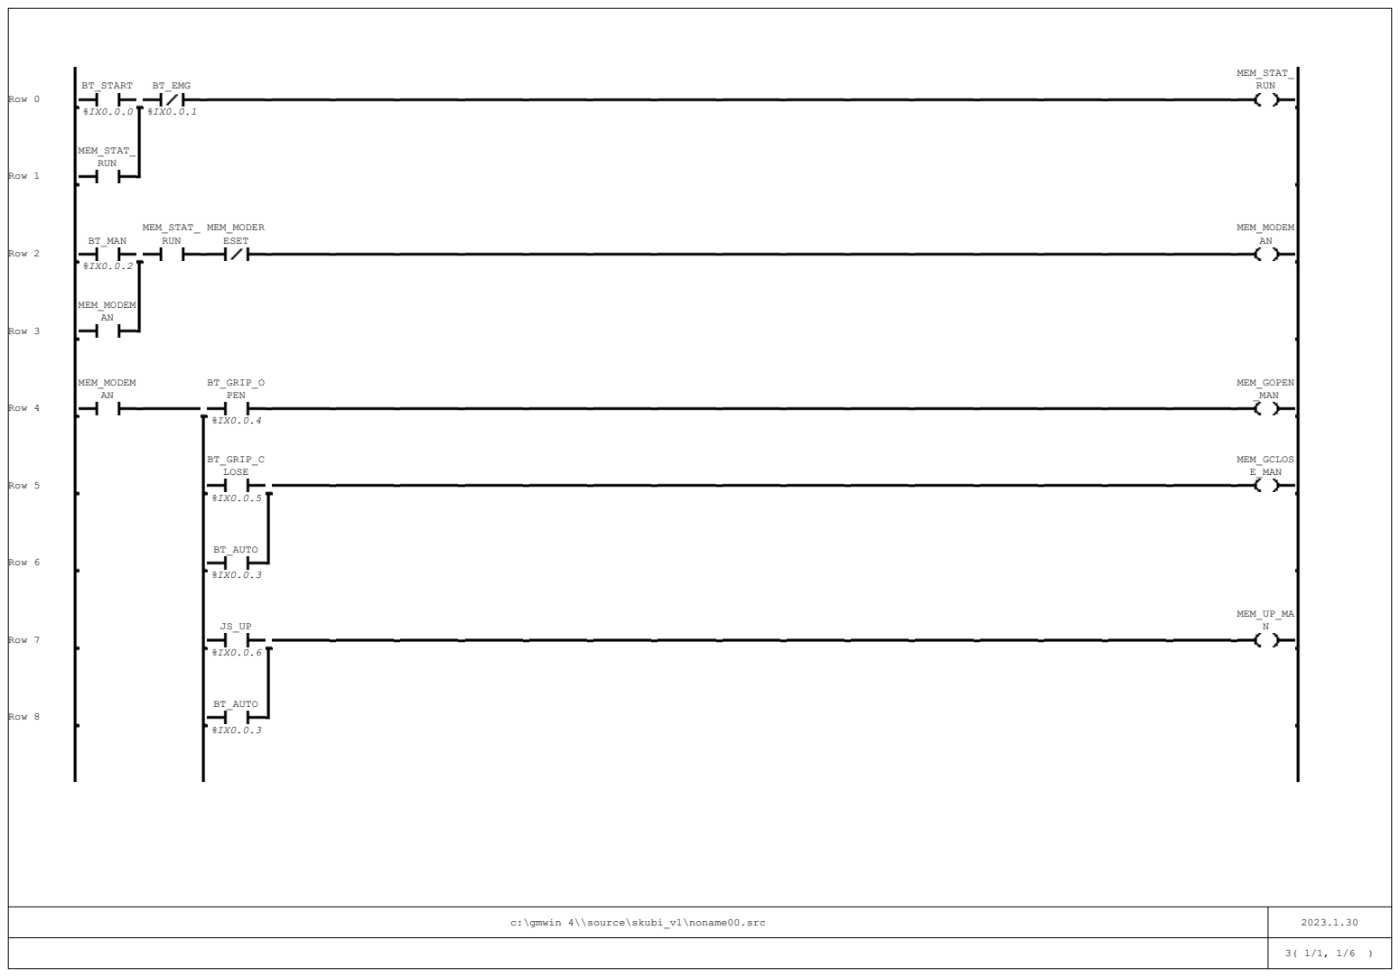
[picture p24: page 1]

c:\gmwin 4\\source\skubi_v1\noname00.src | 2023.1.30
| 3( 1/1, 1/6 )

Row 0

BT_START

%IX0.0.0

BT_EMG

%IX0.0.1

MEM_STAT_
RUN

Row 1

MEM_STAT_
RUN

Row 2

BT_MAN

%IX0.0.2

MEM_STAT_
RUN

MEM_MODER
ESET

MEM_MODEM
AN

Row 3

MEM_MODEM
AN

Row 4

MEM_MODEM
AN

BT_GRIP_O
PEN

%IX0.0.4

MEM_GOPEN
_MAN

Row 5

BT_GRIP_C
LOSE

%IX0.0.5

MEM_GCLOS
E_MAN

Row 6

BT_AUTO

%IX0.0.3

Row 7

JS_UP

%IX0.0.6

MEM_UP_MA
N

Row 8

BT_AUTO

%IX0.0.3

4( 1/1, 2/6 )

Row 9

JS_DOWN

%IX0.0.7

MEM_DOWN_
MAN

Row 10

JS_FWD

%IX0.0.8

MEM_FWD_M
AN

Row 11

JS_RWD

%IX0.0.9

MEM_RWD_M
AN

Row 12

BT_AUTO

%IX0.0.3

TON
IN | Q
INST15 | MEM_MODER
| ESET
Row 13 | T#1S | PT | ET

Row 14

Row 15

COMMENT ---------- Deteksi dan Ambil Benda Kerja ---------------

Row 17

5( 1/1, 3/6 )

Row 18

MEM_ADABE
NDA

Row 19

MEM_ADABE
NDA

MEM_UP_AM
BIL

MEM_DOWN_
AMBIL

Row 20

MEM_GCLOS
E_AMBIL

MEM_GOPEN
_AMBIL

Row 21

TON
IN | Q
INST0 | MEM_GOPEN
| _TARUH

MEM_GCLOS
E_AMBIL
Row 22 | T#500MS PT | ET

TON
IN | Q
INST2 | MEM_DOWN_
TARUH

MEM_UP_AM
BIL
Row 23 | T#500MS PT | ET

TON
IN | Q
INST4 | MEM_RWD_T
ARUH

MEM_FWD_A
MBIL
Row 24 | T#500MS PT | ET

TON
IN | Q
INST8 | MEM_TARUH
BENDA
Row 25 | T#500MS PT | ET

Row 26

6( 1/1, 4/6 )

COMMENT ----------- Taruh Benda Kerja dan Balik Posisi Awal -----------

Row 28

MEM_TARUH
BENDA

MEM_UP_TA
RUH

MEM_DOWN_
TARUH

Row 29

TON
IN | Q
INST14 | MEM_GCLOS
| E_TARUH

MEM_GOPEN
_TARUH
Row 30 | T#500MS PT | ET

TON
IN | Q
INST9 | MEM_GCLOS
E_TARUH
Row 31 | T#500MS PT | ET

TON
IN | Q
INST11 | MEM_UP_TA
RUH
Row 32 | T#500MS PT | ET

TON
IN | Q
INST12 | MEM_RWD_T
ARUH
Row 33 | T#500MS PT | ET

TON
IN Q

INST13
SELESAI
Row 34 | T#500MS PT | ET

Row 35

7( 1/1, 5/6 )

Row 36

MEM_GOPEN
_MAN

CO_GRIP_O
PEN

%QX0.2.0

Row 37

MEM_GOPEN
_AMBIL

Row 38

MEM_GOPEN
_TARUH

Row 39

MEM_GCLOS
E_MAN

CO_GRIP_C
LOSE

%QX0.2.1

Row 40

MEM_GCLOS
E_AMBIL

Row 41

MEM_GCLOS
E_TARUH

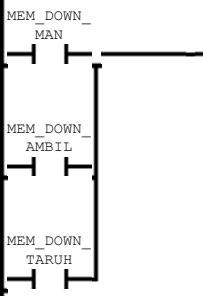
[picture p25: figure]
MEM_DOWN_; MEM_DOWN_ AMBIL; MEM_DOWN_ TARUH

Row 42
%QX0.2.3

Row 43

Row 44

8( 1/1, 6/6 )

Row 45

MEM_UP_MA
N CO_UP

%QX0.2.2

Row 46

MEM_UP_AM
BIL

Row 47

MEM_UP_TA
RUH

Row 48

MEM_FWD_M
AN | CO_FWD
| %QX0.2.4

Row 49

MEM_FWD_A
MBIL

Row 50

Row 51

MEM_RWD_M

%QX0.2.5

Row 52

MEM_RWD_T
ARUH
