fariszuh/SKUBI-Pneumatic/Dokumetasi/IMG-20230215-WA0008.jpg

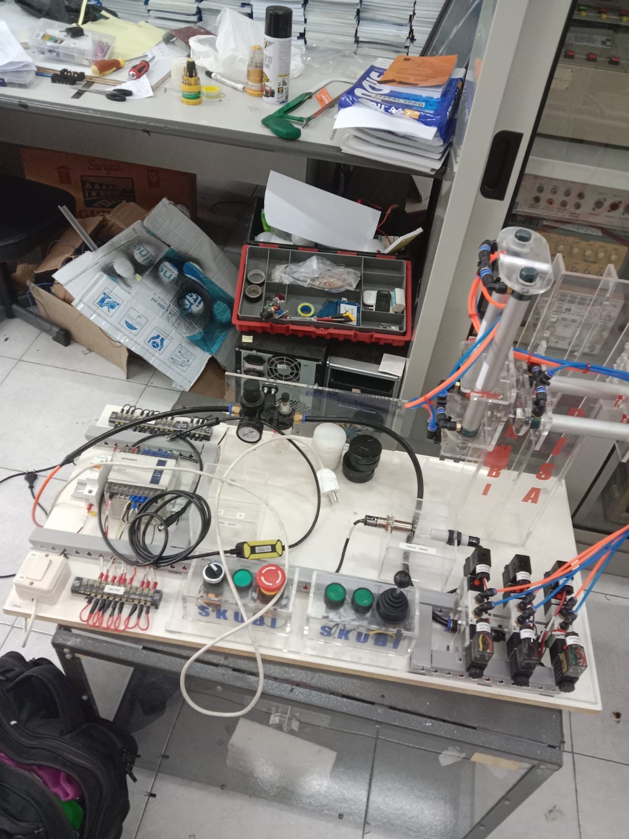
Dokumetasi/IMG-20230215-WA0008.jpg
