fariszuh/SKUBI-Pneumatic/Dokumetasi/IMG-20230215-WA0009.jpg

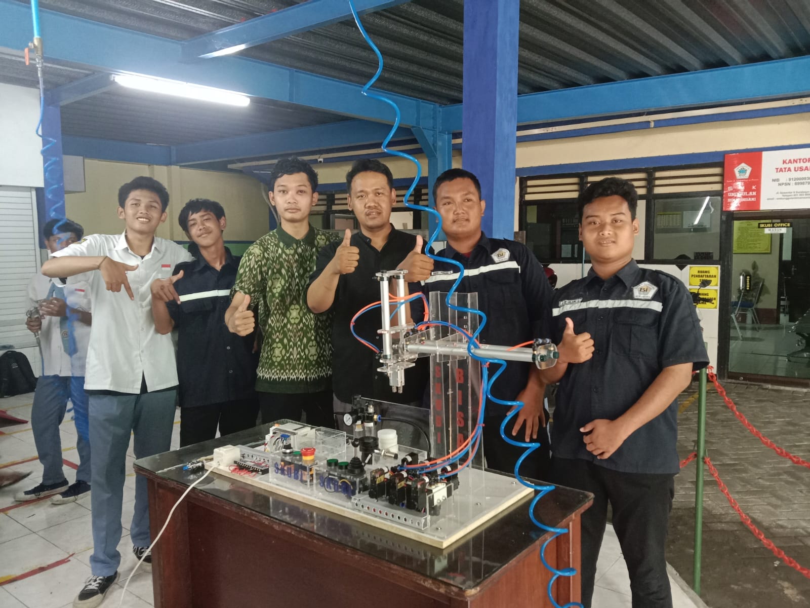
Dokumetasi/IMG-20230215-WA0009.jpg
