fariszuh/SKUBI-Pneumatic/Dokumetasi/WhatsApp Image 2023-02-16 at 06.38.43.jpg

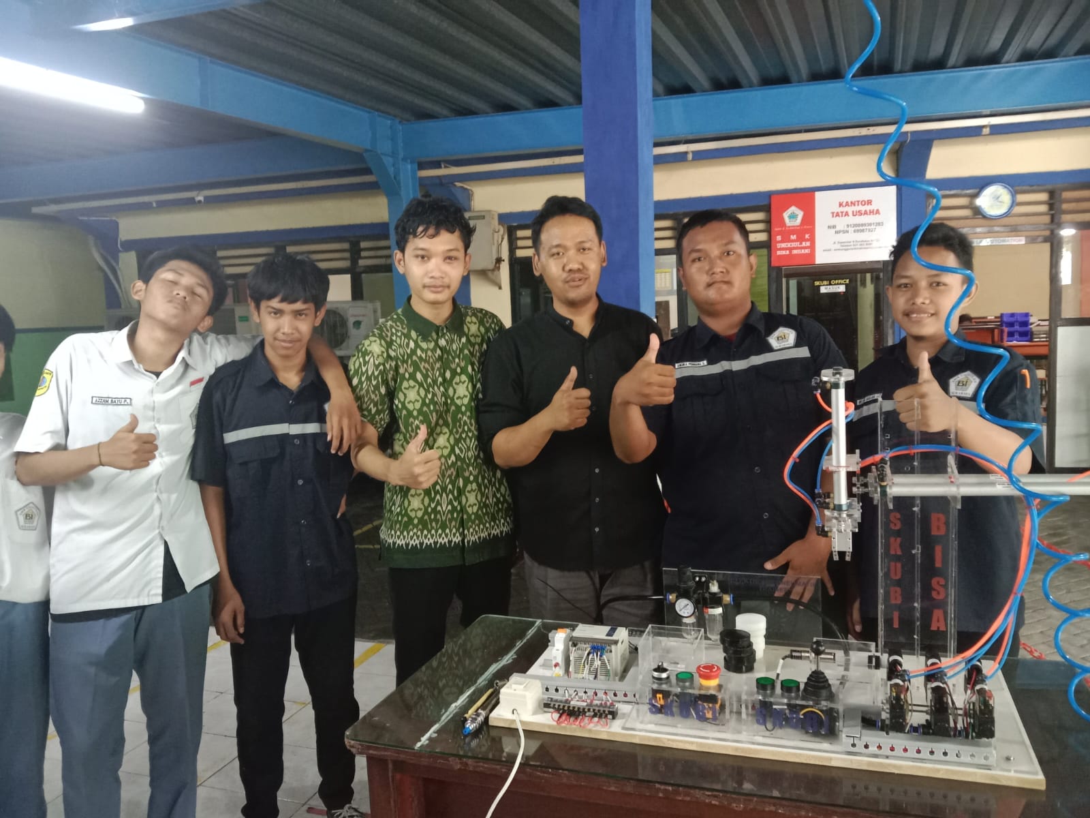
Dokumetasi/WhatsApp Image 2023-02-16 at 06.38.43.jpg
