fariszuh/SKUBI-Pneumatic/3D Cutting/Library Sensor/BR100-DDT_BR100-DDT-P_BR200-DDTN_BR200-DDTN-P_BR400-DDT_(1)/BR100-DDT_BR100-DDT-P_BR200-DDTN_BR200-DDTN-P_BR400-DDT_(1).STEP

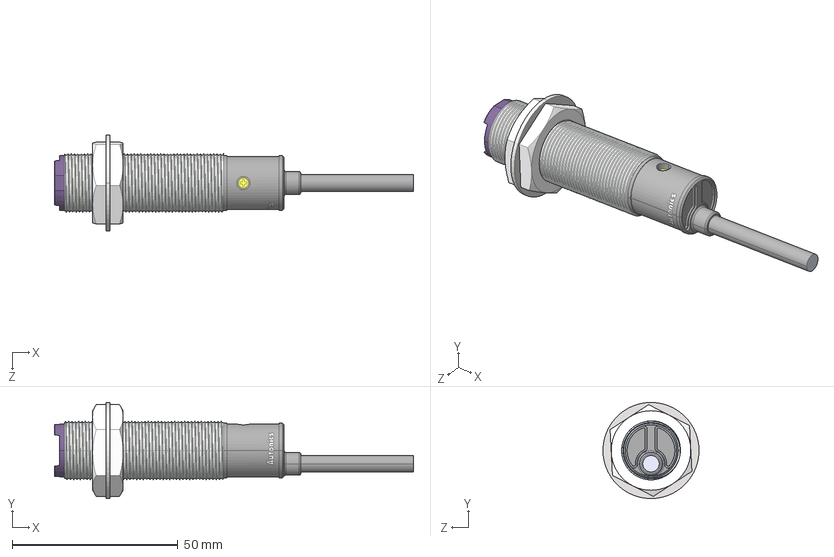
[picture p29: CAD file, 2025-02-26]
3D Cutting/Library Sensor/BR100-DDT_BR100-DDT-P_BR200-DDTN_BR200-DDTN-P_BR400-DDT_(1)/BR100-DDT_BR100-DDT-P_BR200-DDTN_BR200-DDTN-P_BR400-DDT_(1).STEP
108.3 x 29.0 x 29.0 mm
