fariszuh/SKUBI-Pneumatic/3D Cutting/Library Sensor/CR18-8DN_CR18-8DP_CR18-8DN2/CR18-8DN_CR18-8DP_CR18-8DN2.SLDPRT

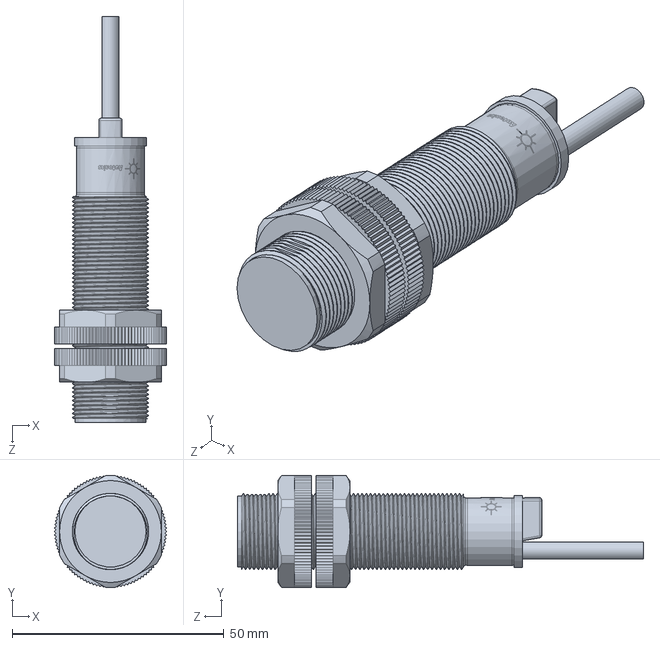
[picture p30: CAD file, 2025-02-26]
3D Cutting/Library Sensor/CR18-8DN_CR18-8DP_CR18-8DN2/CR18-8DN_CR18-8DP_CR18-8DN2.SLDPRT
26.5 x 26.5 x 95.8 mm
