fariszuh/SKUBI-Pneumatic/SKUBI Drawings/Panel/fx1n-24mr_a_dxf_wmf/fx1n-24mr_a.dxf

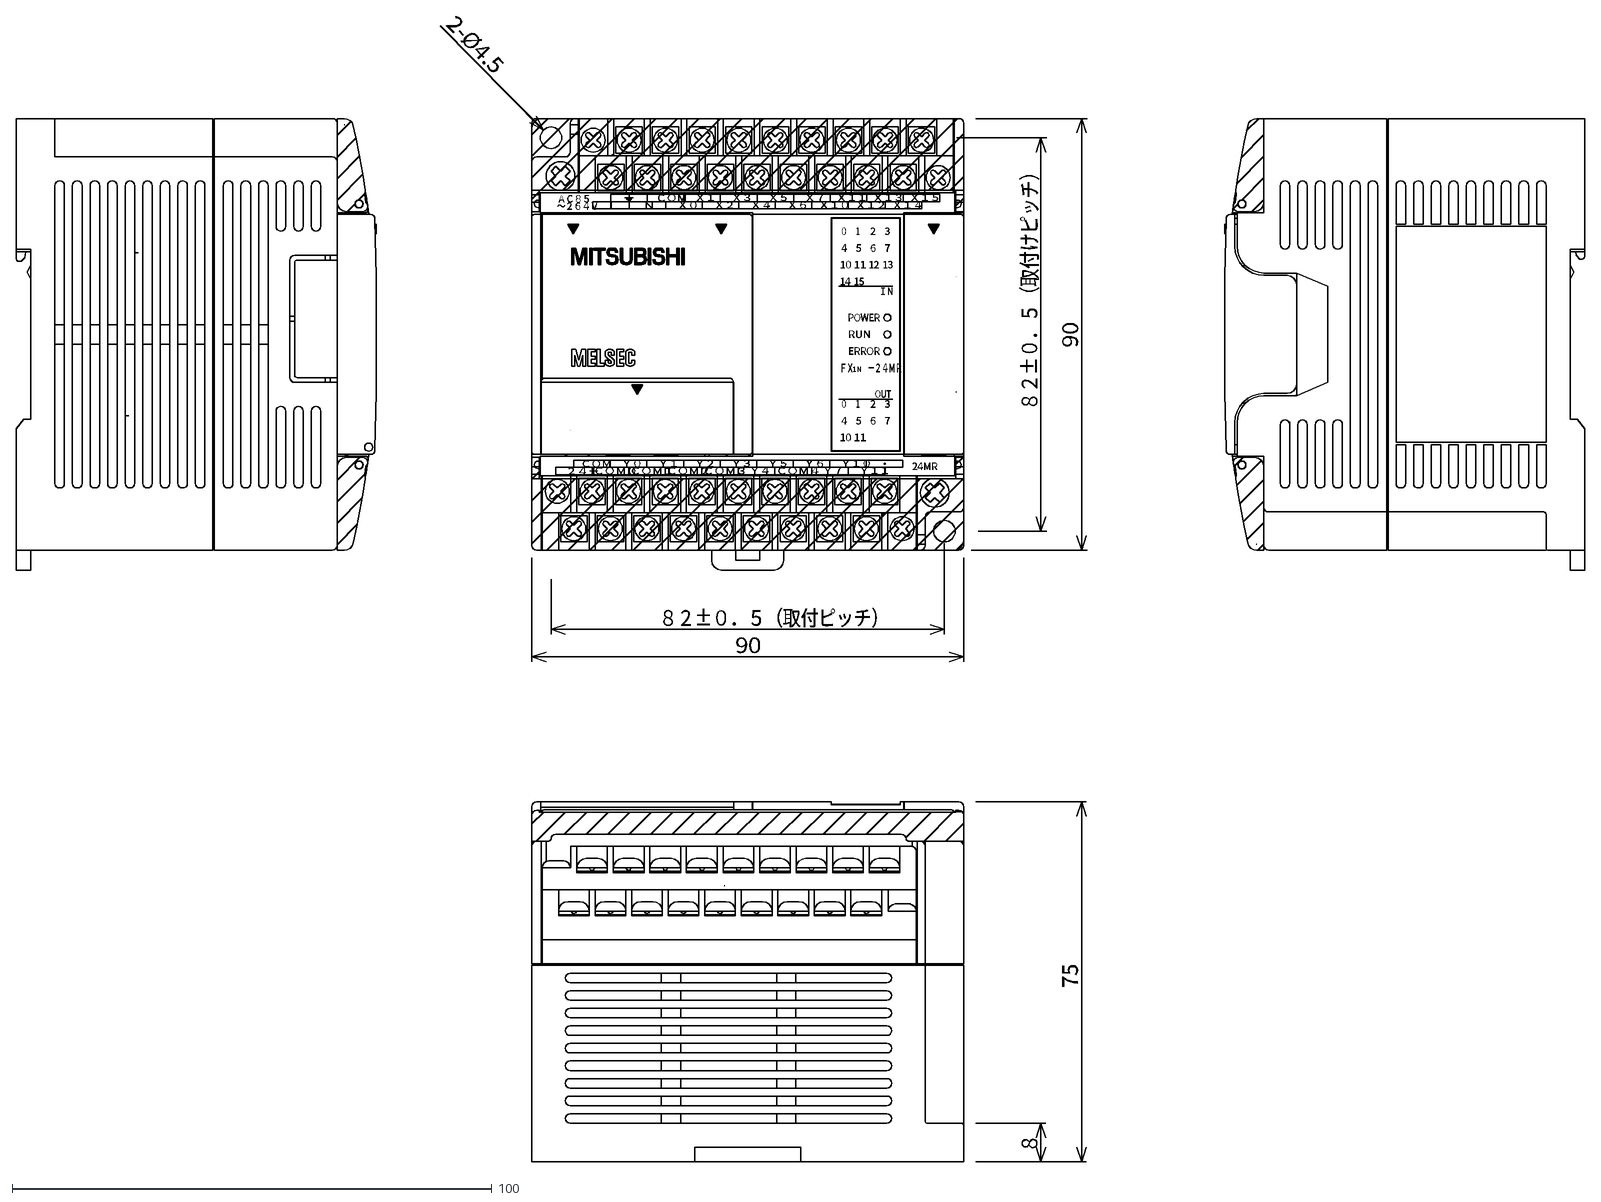
[picture p31: CAD file, 2025-02-26]
SKUBI Drawings/Panel/fx1n-24mr_a_dxf_wmf/fx1n-24mr_a.dxf
15
Ｘ０
Ｘ２
Ｘ１
Ｘ３
Ｘ５
Ｘ４
Ｘ７
Ｘ６
Ｘ１１
Ｘ１０
ＣＯＭ
Ｘ１３
Ｘ１２
Ｘ１５
Ｘ１４
Ｌ
Ｎ
２４＋
Ｙ７
Ｙ６
Ｙ１１
ＣＯＭ２
ＣＯＭ４
Ｙ１０
Ｙ５
Ｙ４
Ｙ０
Ｙ２
Ｙ１
ＣＯＭ０
ＣＯＭ１
ＣＯＭ３
Ｙ３
POWER
ERROR
ＦＸ －２４ＭＲ
ＩＮ
OUT
0
1
2
3
１Ｎ
RUN
4
5
6
7
11
10
13
12
14
～２６４Ｖ
ＡＣ８５
24MR
8
75
８２±０．５（取付ピッチ）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
