fariszuh/SKUBI-Pneumatic/(list of files, cad)

Other CAD files:
3D Cutting/Cutting samping.dwg
Learn Autocad Electrical Udemy/E005.dwg
Learn Autocad Electrical Udemy/File ga jadi/PLC Input Layout IEC.dwg
SKUBI Drawings/E001.dwg
SKUBI Drawings/Panel/Dimensi Panel.dwg
3D Cutting/Belajar 3D.dwg
Learn Autocad Electrical Udemy/E002_v2.dwg
Learn Autocad Electrical Udemy/File ga jadi/PLC Input Layout.dwg
Wiring/SKUBI Pneumatik Wiring.dwg
3D Cutting/Kirim cetak.dwg
Learn Autocad Electrical Udemy/E004.dwg
Wiring/Belajar Drawing Motor 3P.dwg
3D Cutting/Cutting Akrilik.dwg
Learn Autocad Electrical Udemy/E002.dwg
Learn Autocad Electrical Udemy/File ga jadi/PLC Input Layout v3.dwg
Learn Autocad Electrical Udemy/Power Supply Layout.dwg
Learn Autocad Electrical Udemy/E003.dwg
3D Cutting/Assembly 3D Cutting.iam
3D Cutting/Depan.ipt
3D Cutting/Kotak Taruh Selesai/End_Assembly 3D Cutting.iam
3D Cutting/Kotak Taruh Selesai/End_Depan.ipt
3D Cutting/Kotak Taruh Selesai/End_Samping.ipt
3D Cutting/Kotak Taruh Selesai/End_bolongan.ipt
3D Cutting/Kotak Taruh Selesai/OldVersions/End_Assembly 3D Cutting.0002.iam
3D Cutting/Kotak Taruh Selesai/OldVersions/End_Depan.0006.ipt
3D Cutting/Kotak Taruh Selesai/OldVersions/End_Samping.0006.ipt
3D Cutting/Kotak Taruh Selesai/OldVersions/End_bolongan.0002.ipt
3D Cutting/Library Sensor/BR100-DDT_BR100-DDT-P_BR200-DDTN_BR200-DDTN-P_BR400-DDT_(1)/BR100-DDT_BR100-DDT-P_BR200-DDTN_BR200-DDTN-P_BR400-DDT_(1).IGS
3D Cutting/Library Sensor/BR100-DDT_BR100-DDT-P_BR200-DDTN_BR200-DDTN-P_BR400-DDT_(1)/BR100-DDT_BR100-DDT-P_BR200-DDTN_BR200-DDTN-P_BR400-DDT_(1).SLDPRT
3D Cutting/Library Sensor/BR100-DDT_BR100-DDT-P_BR200-DDTN_BR200-DDTN-P_BR400-DDT_(1)/BR100-DDT_BR100-DDT-P_BR200-DDTN_BR200-DDTN-P_BR400-DDT_(1).ipt
3D Cutting/Library Sensor/CR18-8DN_CR18-8DP_CR18-8DN2/CR18-8DN_CR18-8DP_CR18-8DN2.ipt
3D Cutting/OldVersions/Assembly 3D Cutting.0001.iam
3D Cutting/OldVersions/Depan.0005.ipt
3D Cutting/OldVersions/Kirim cetak.0002.dwg
3D Cutting/OldVersions/Samping.0005.ipt
3D Cutting/OldVersions/bolongan.0001.ipt
3D Cutting/Samping.ipt
3D Cutting/bolongan.ipt
Learn Autocad Electrical Udemy/File ga jadi/PLC Input Layout v2.dwg
Wiring/SKUBI Pneumatik Wiring - Copy.dwg
