fariszuh/SKUBI-Pneumatic/Drawing SKUBI update 1.pdf

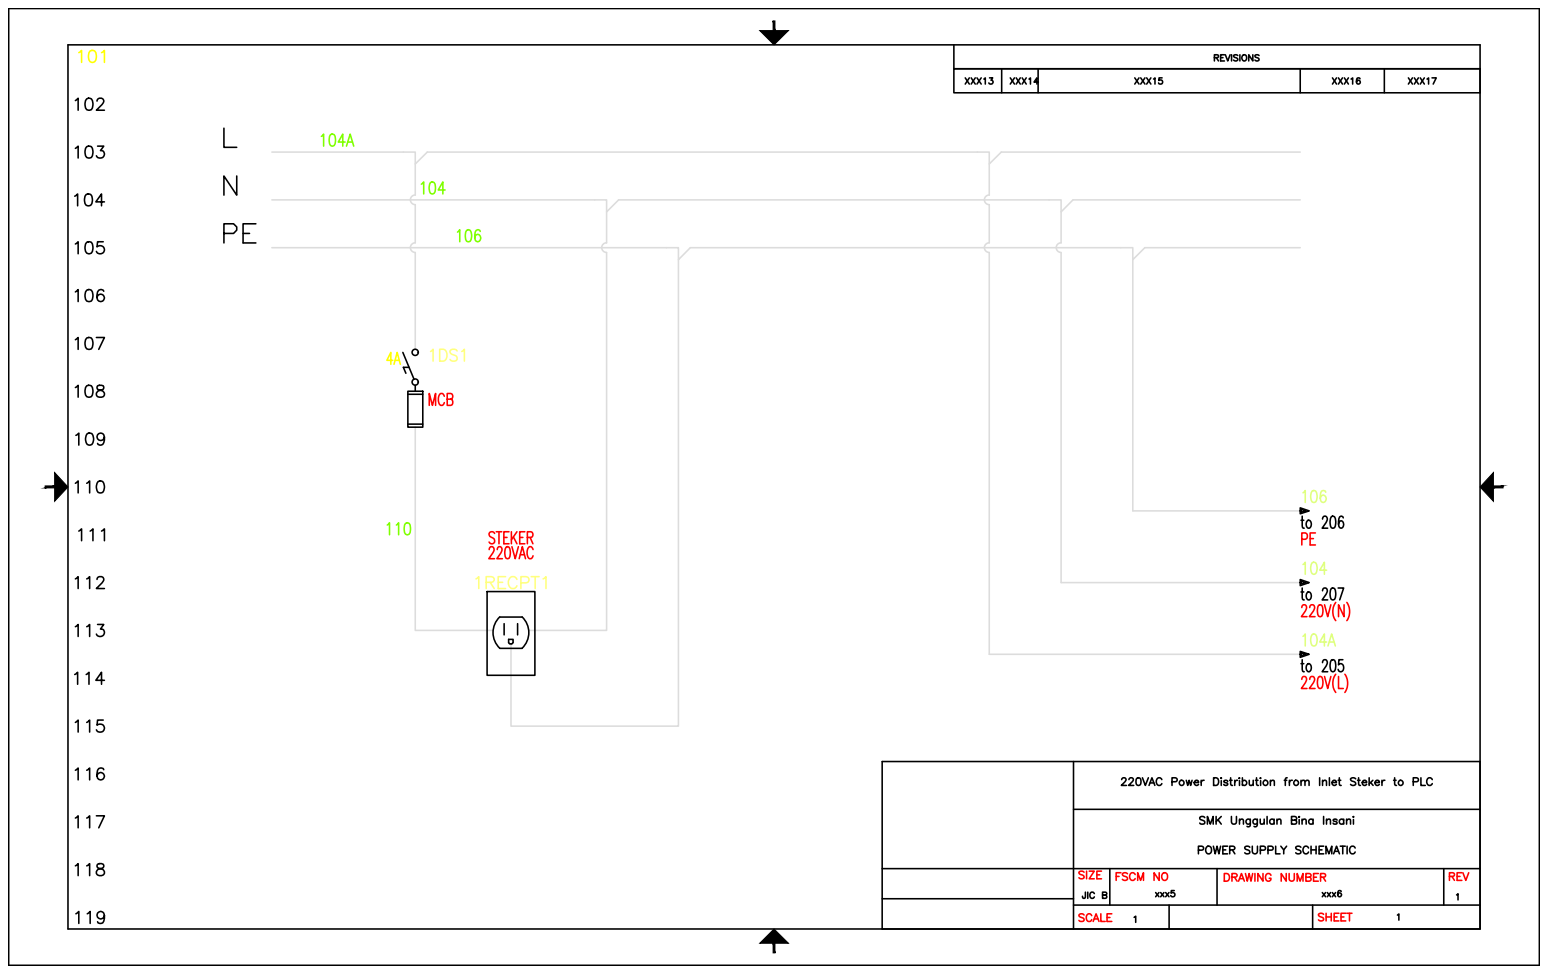
[picture p44: page 1]
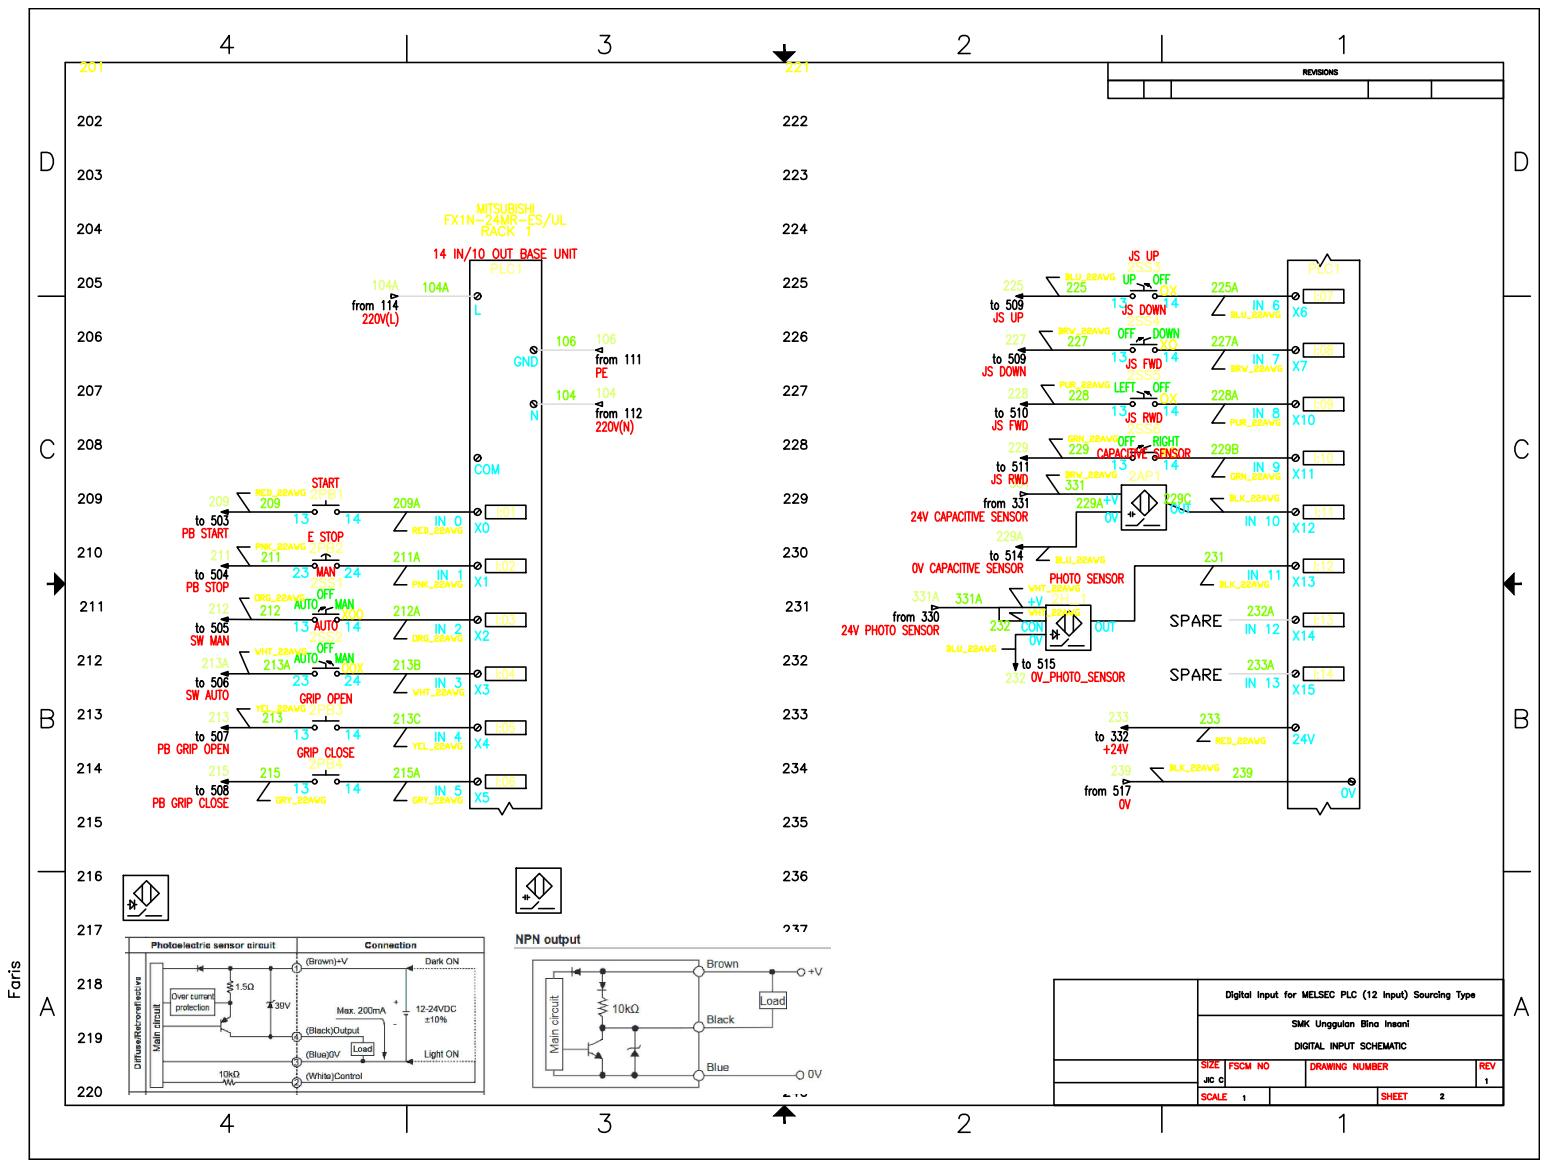
[picture p45: page 2]
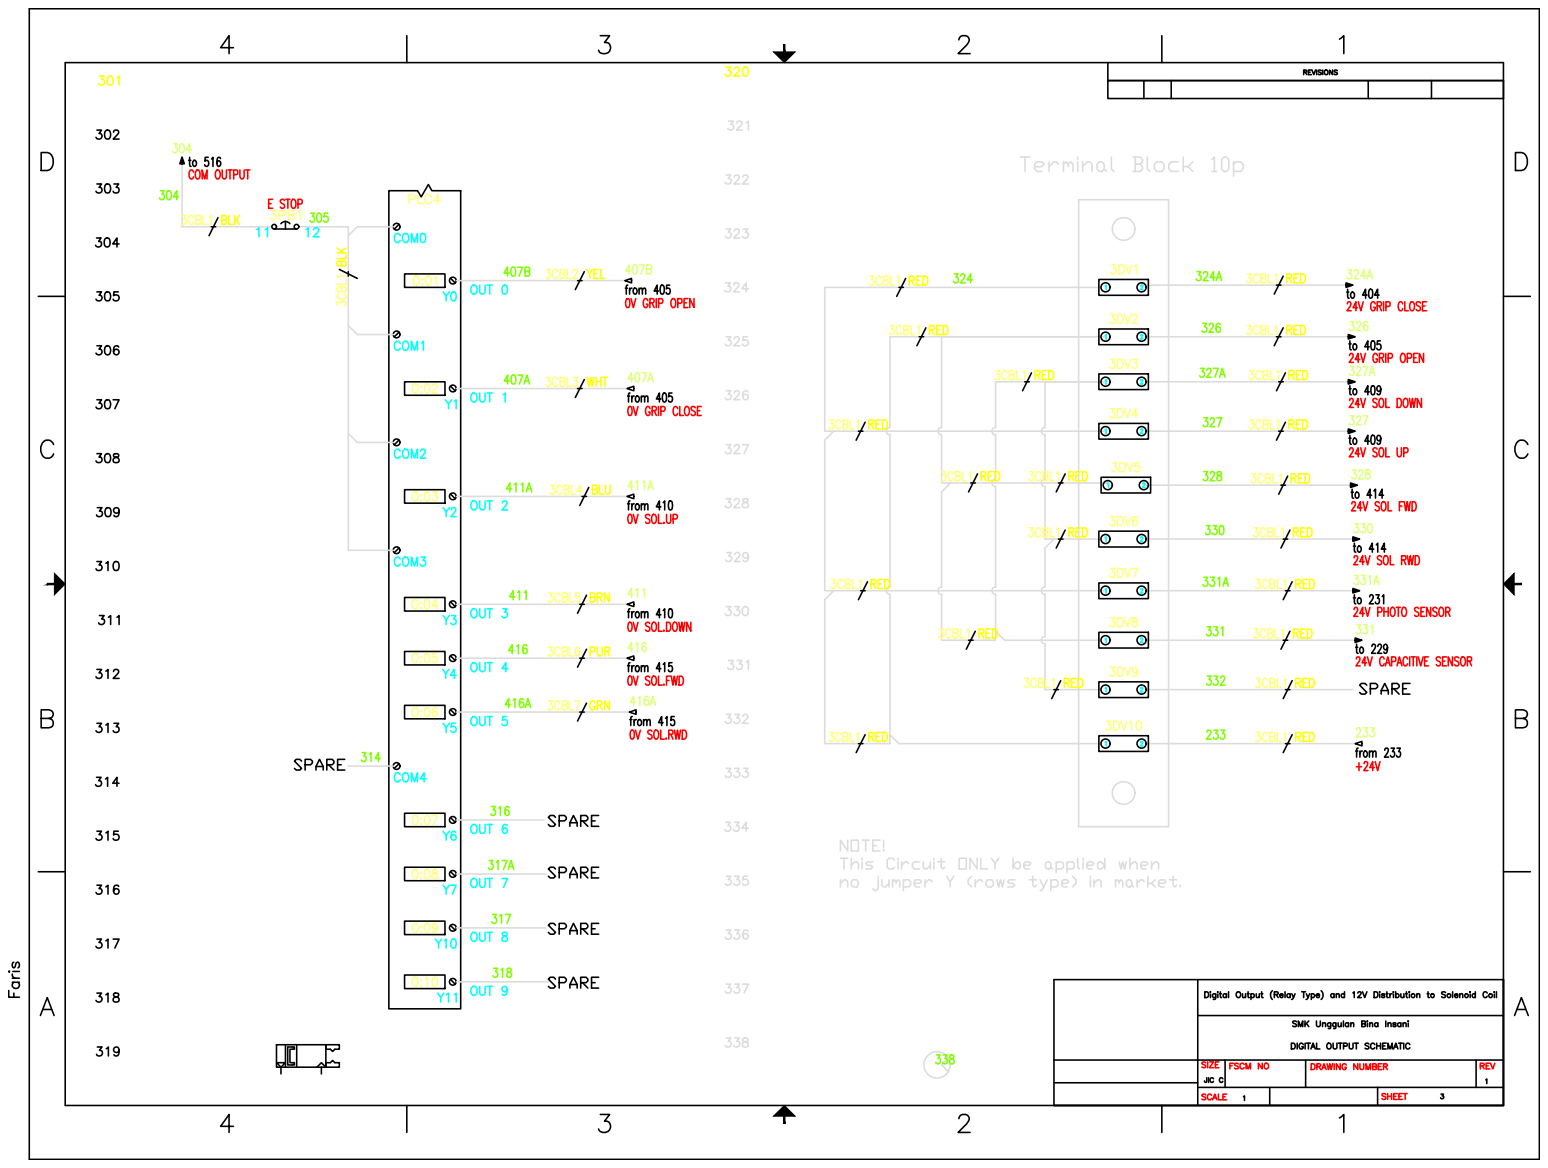
[picture p46: page 3]
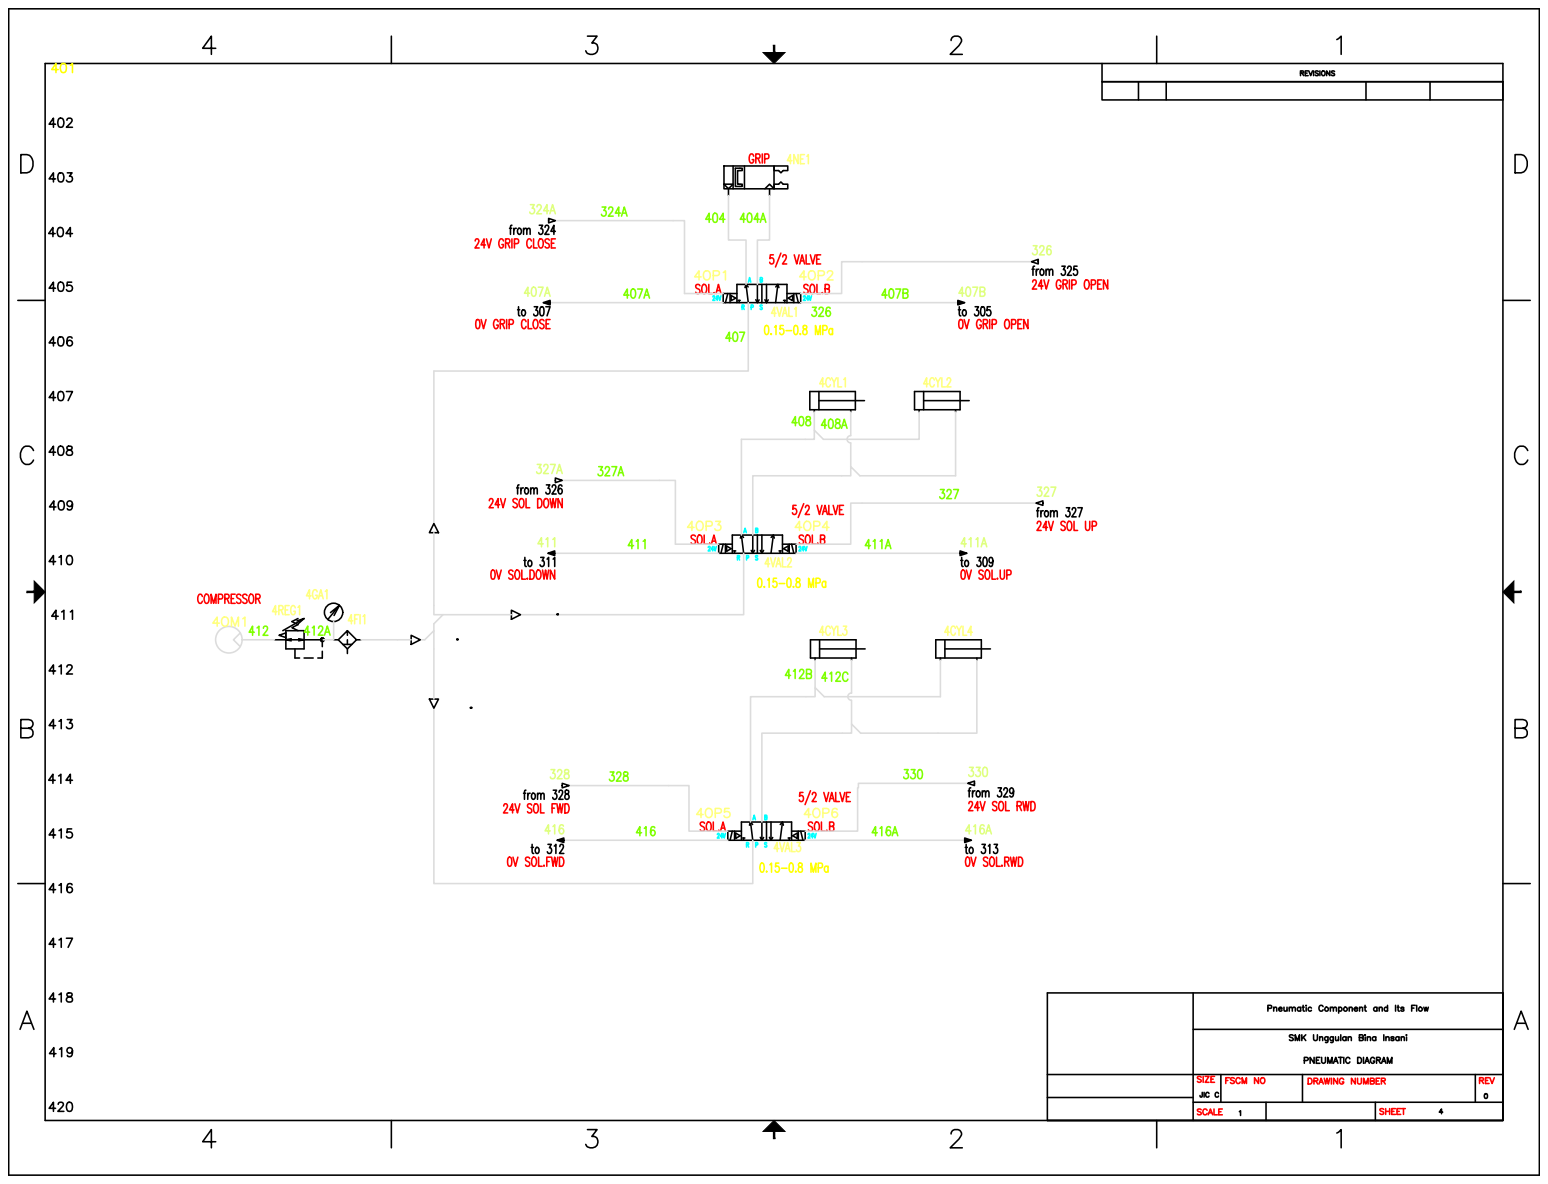
[picture p47: page 4]
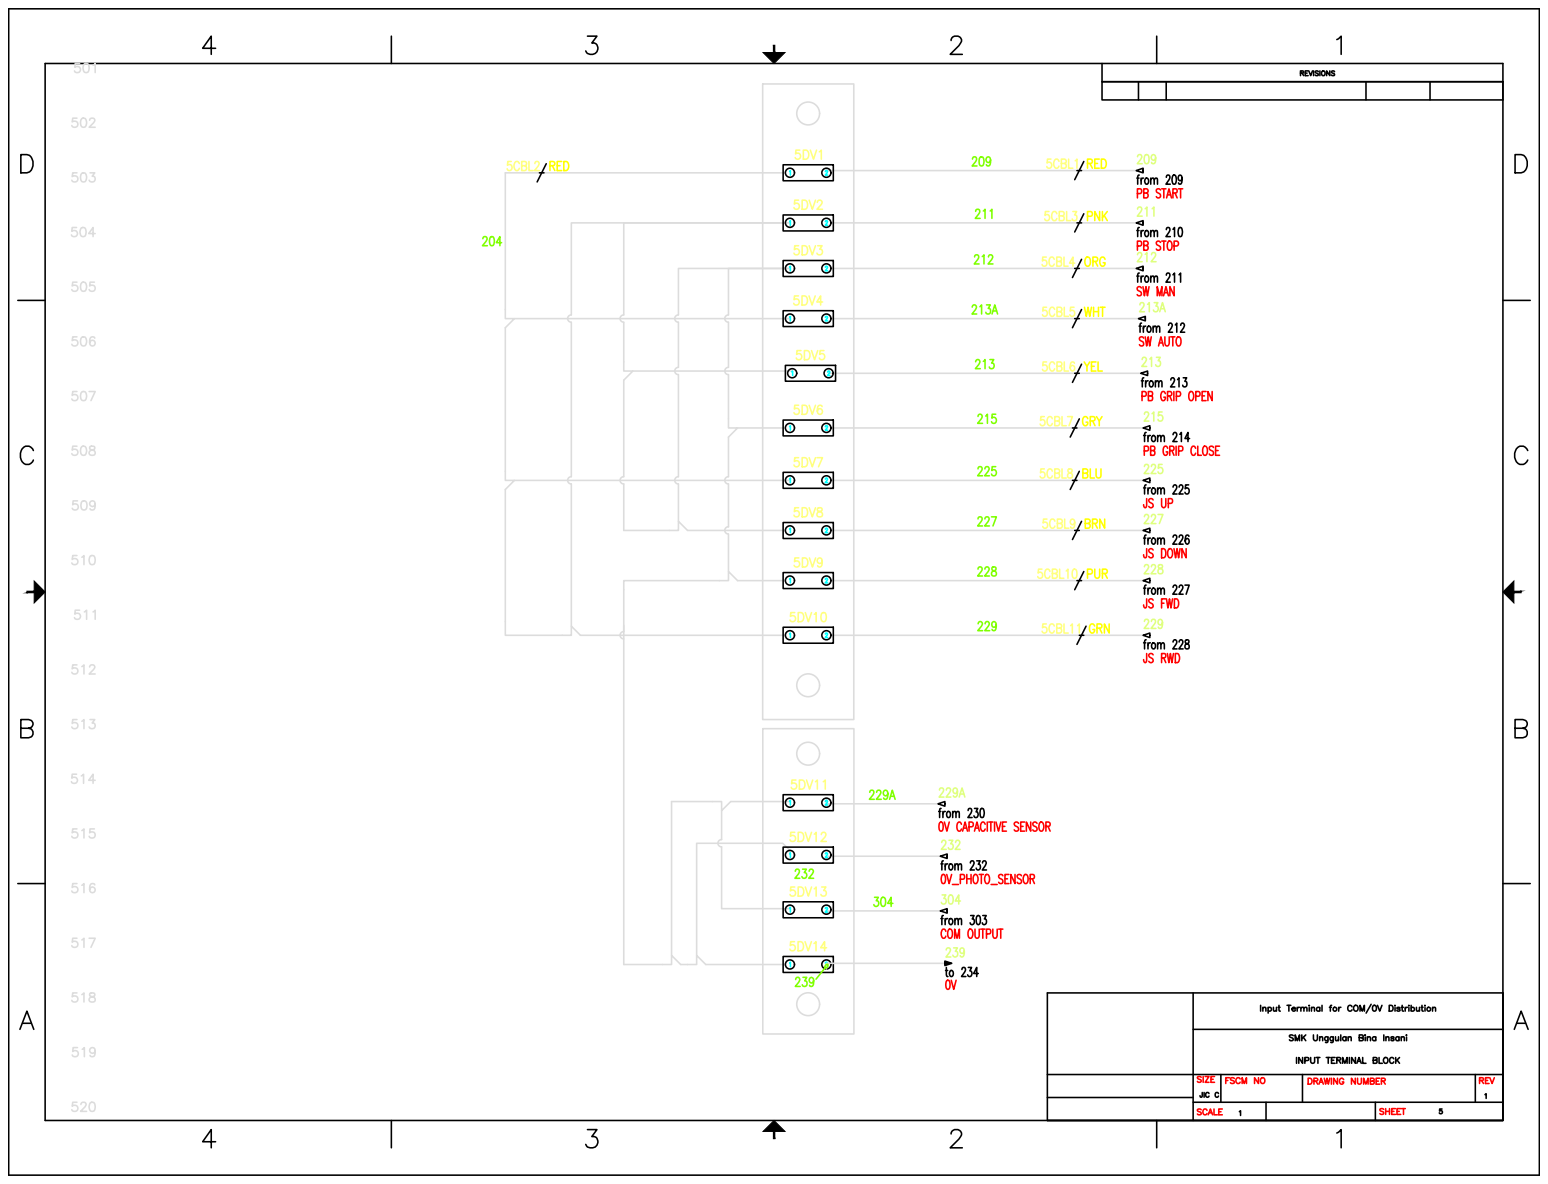
[picture p48: page 5]
