fariszuh/SKUBI-Pneumatic/Drawing SKUBI.pdf

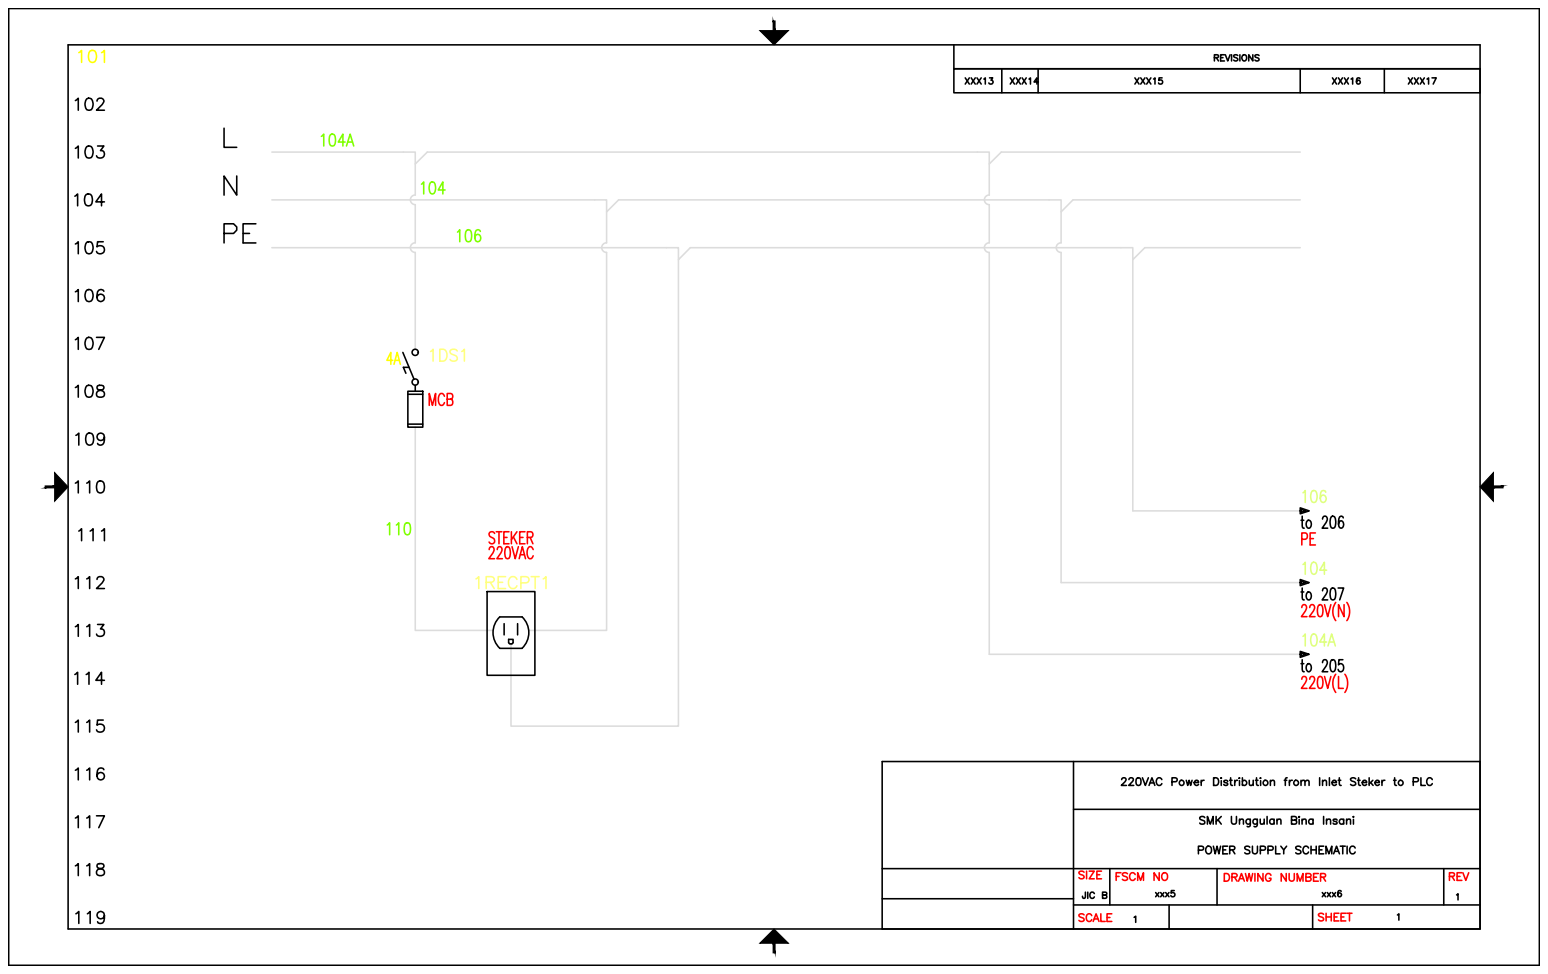
[picture p49: page 1]
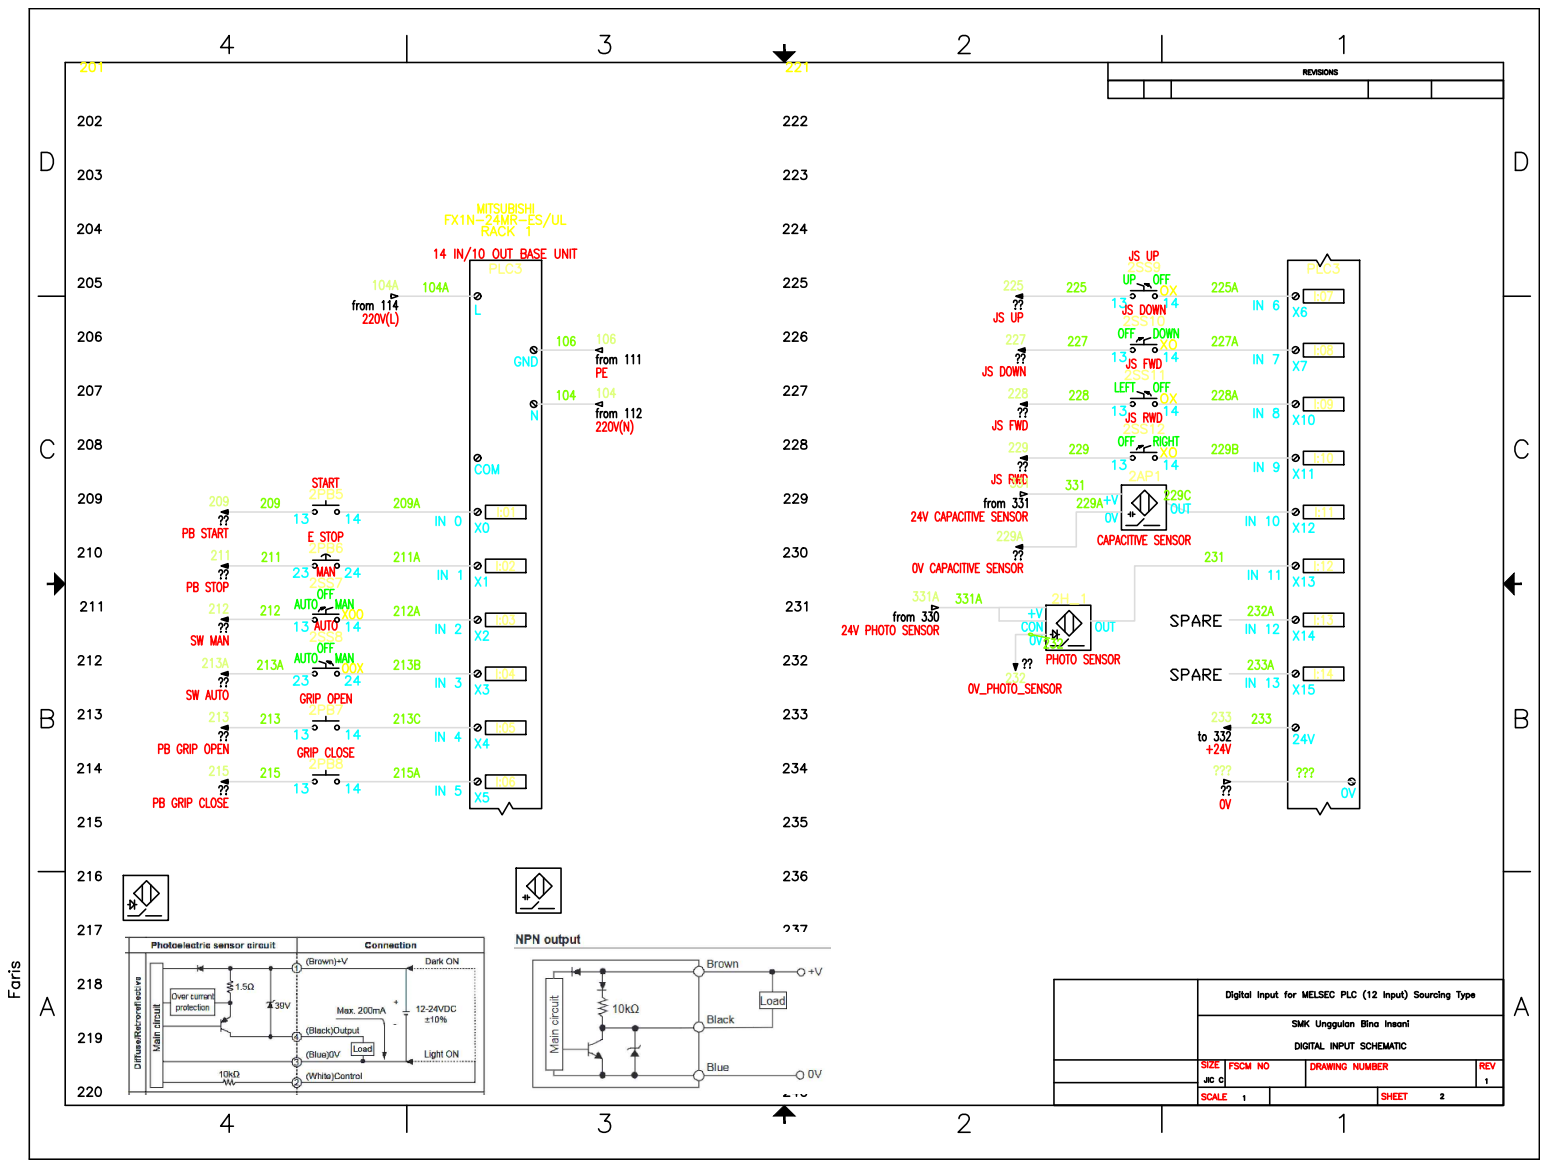
[picture p50: page 2]
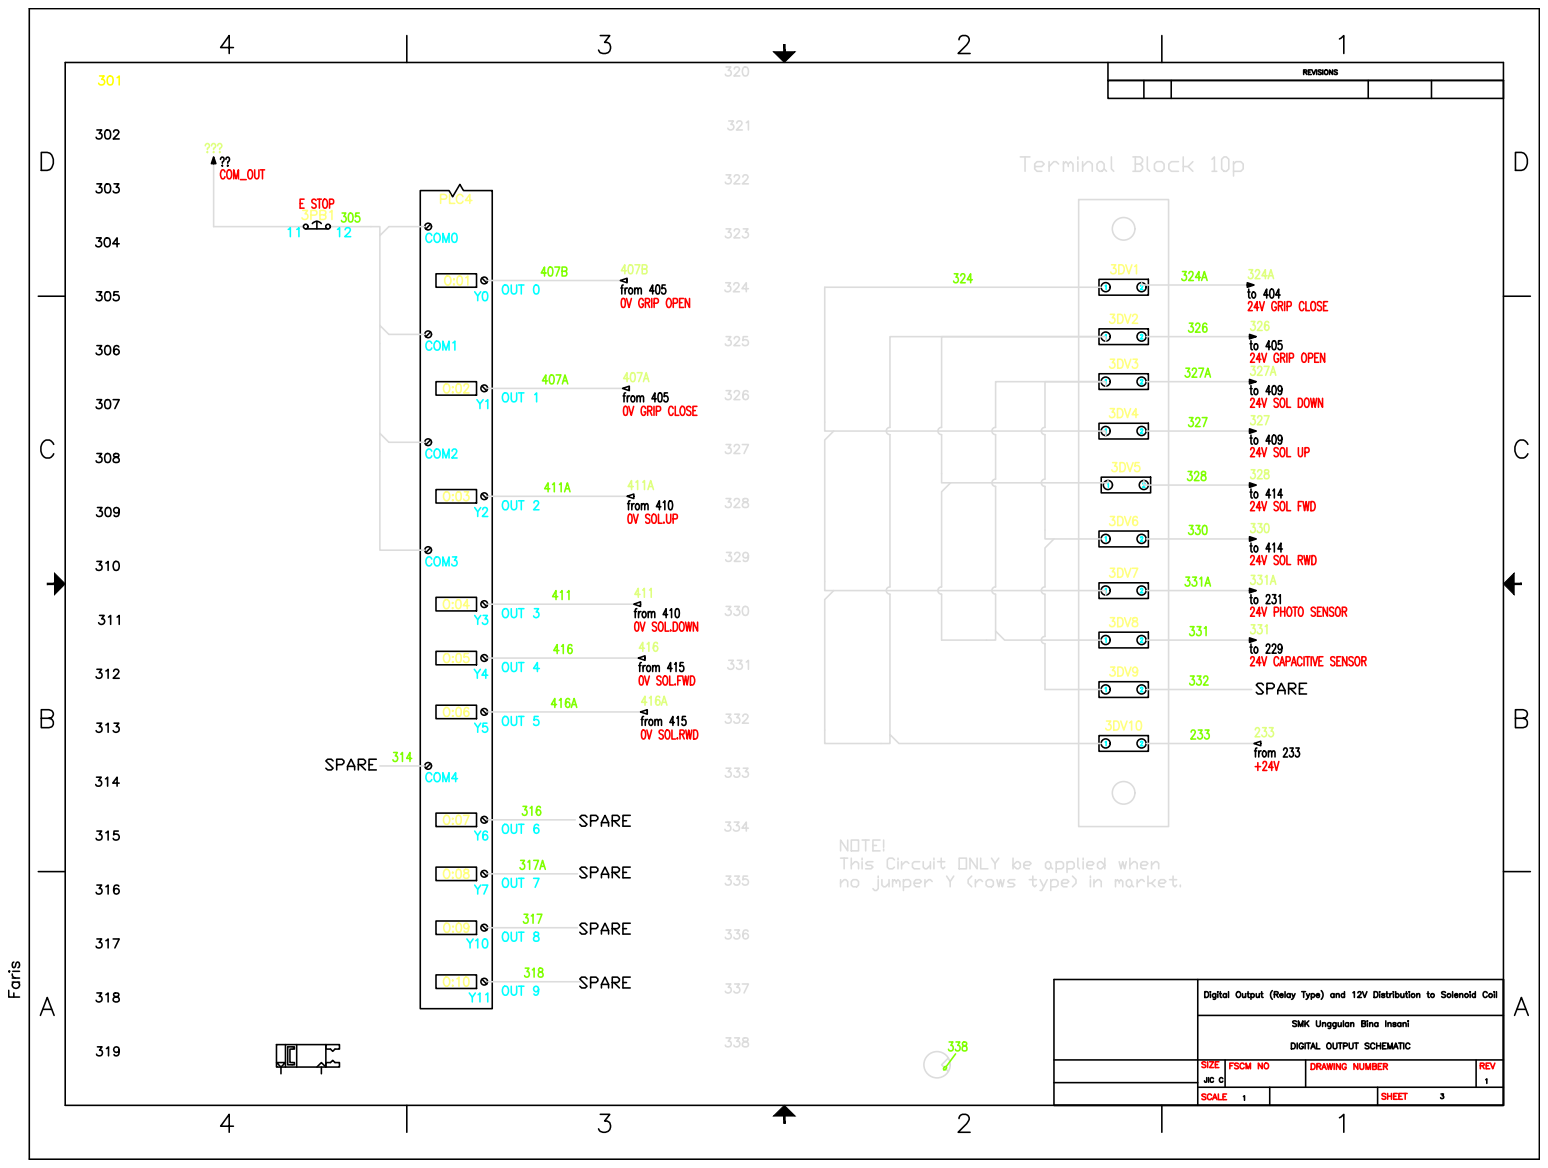
[picture p51: page 3]
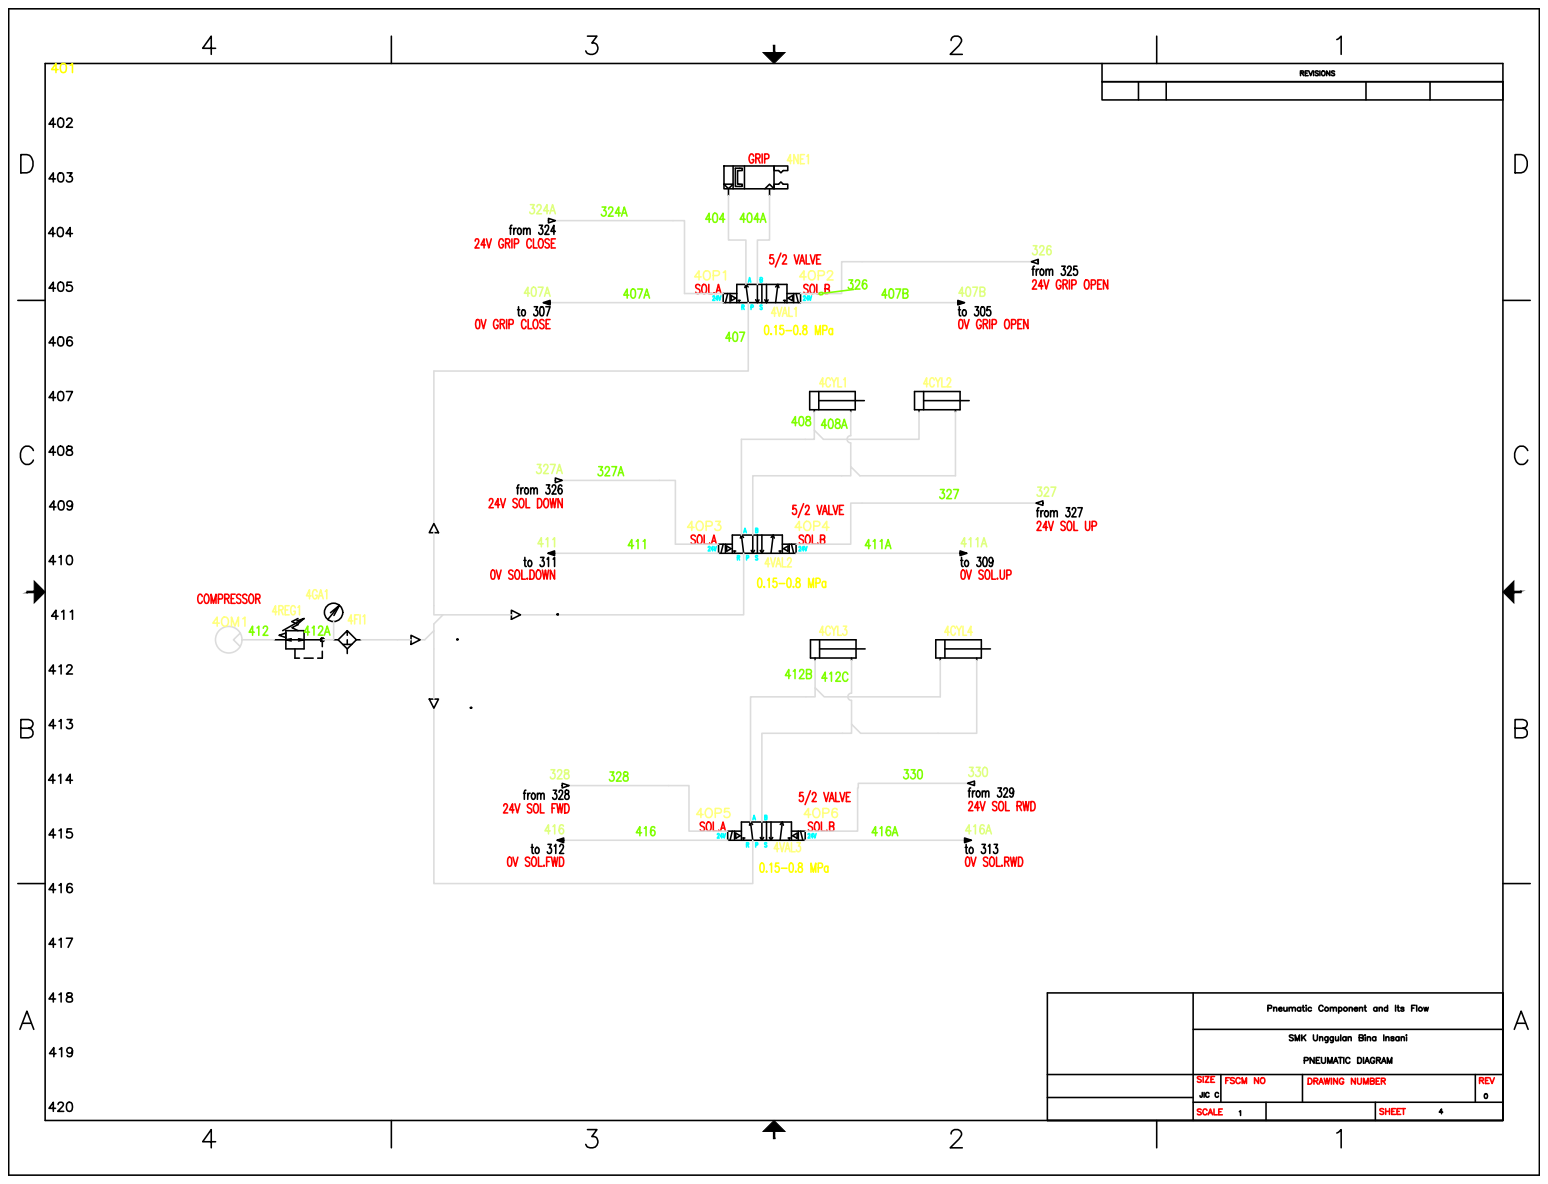
[picture p52: page 4]
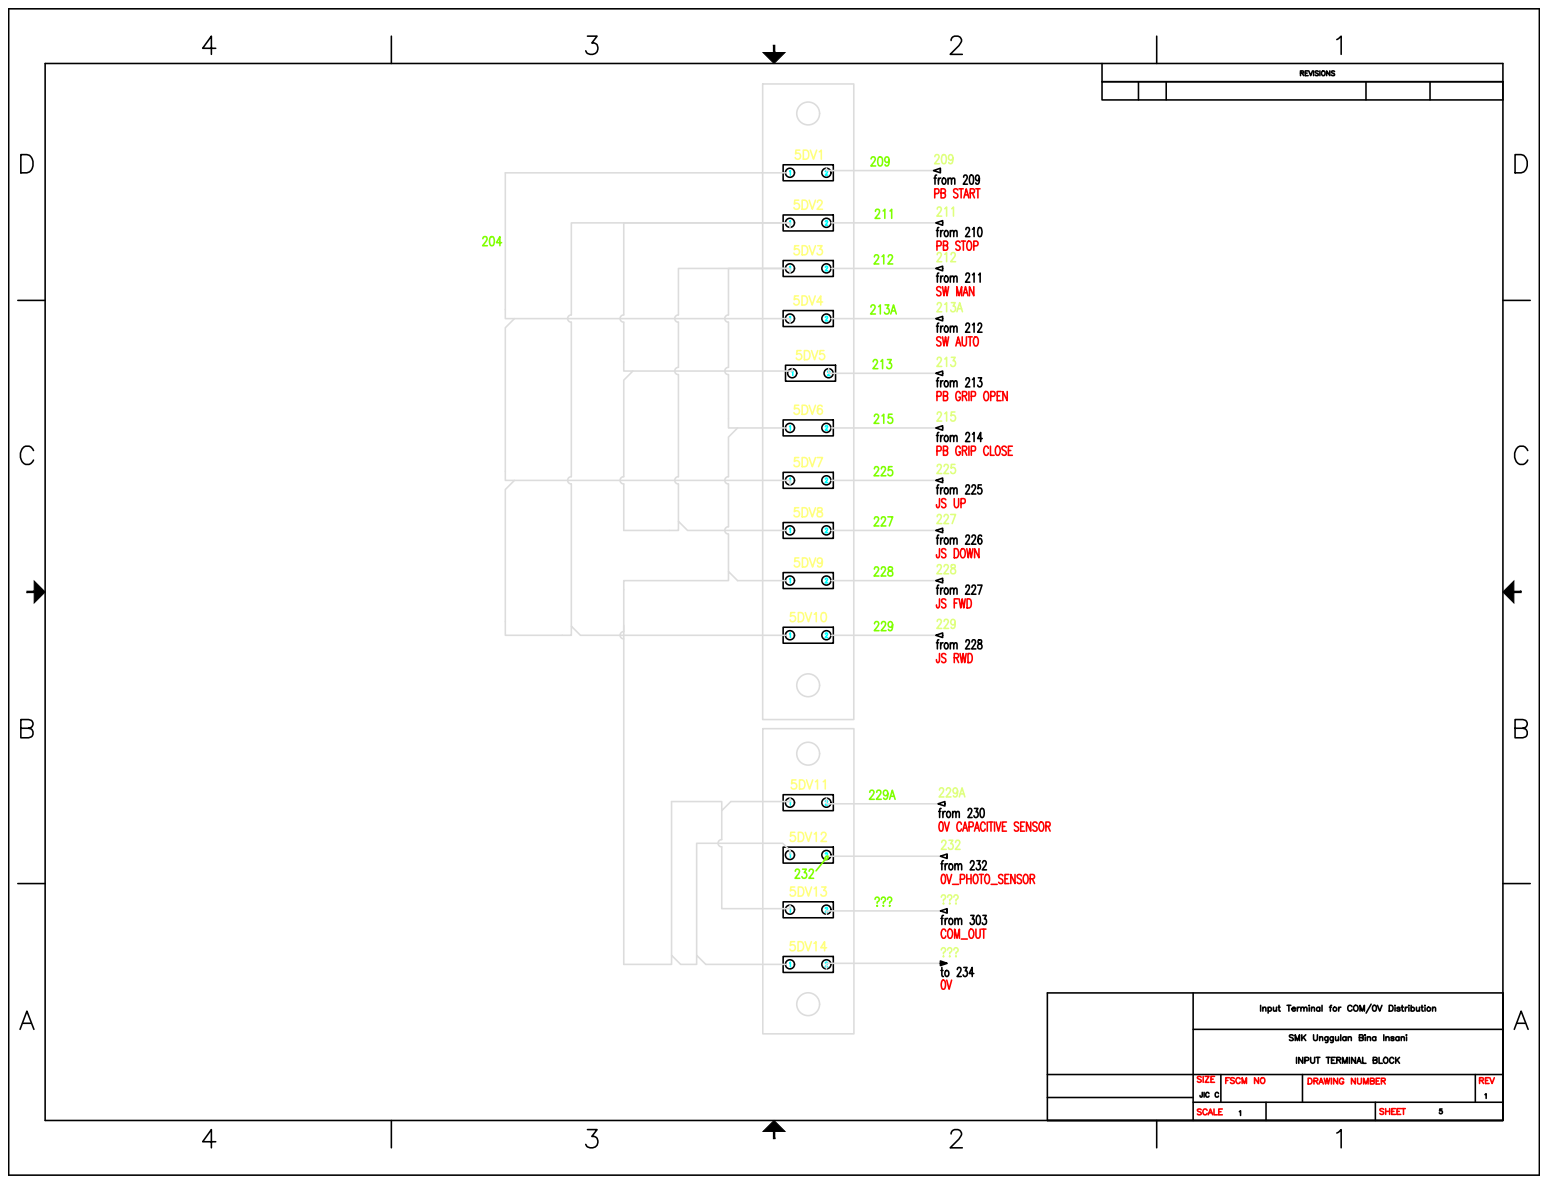
[picture p53: page 5]
