fariszuh/SKUBI-Pneumatic/3D Cutting/Kirim cetak akrilik Faris.pdf

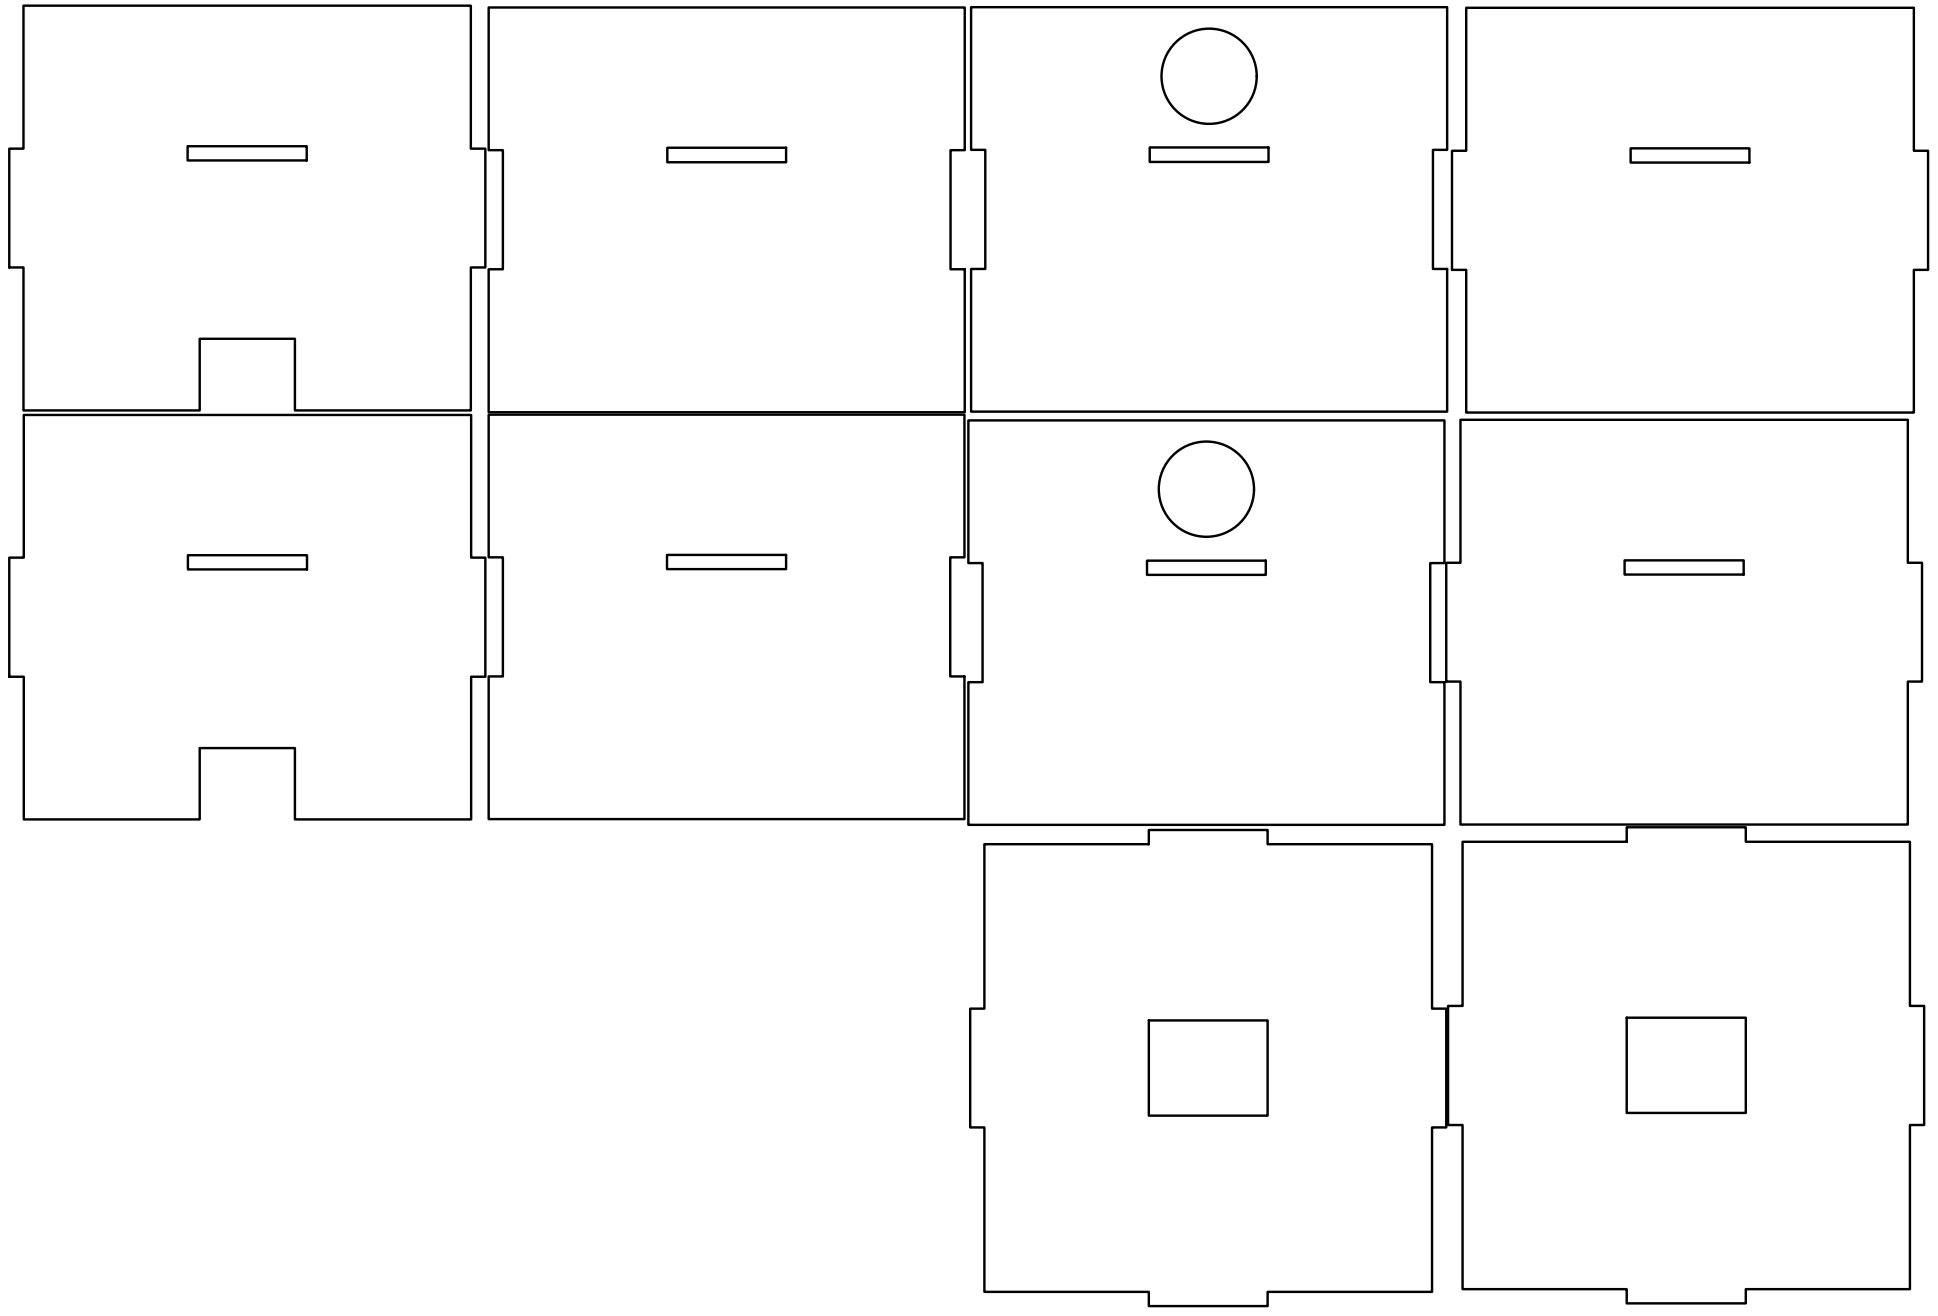
[picture p54: page 1]
