fariszuh/SKUBI-Pneumatic/Referensi Mas Adrian - 20220830DELITUA.pdf

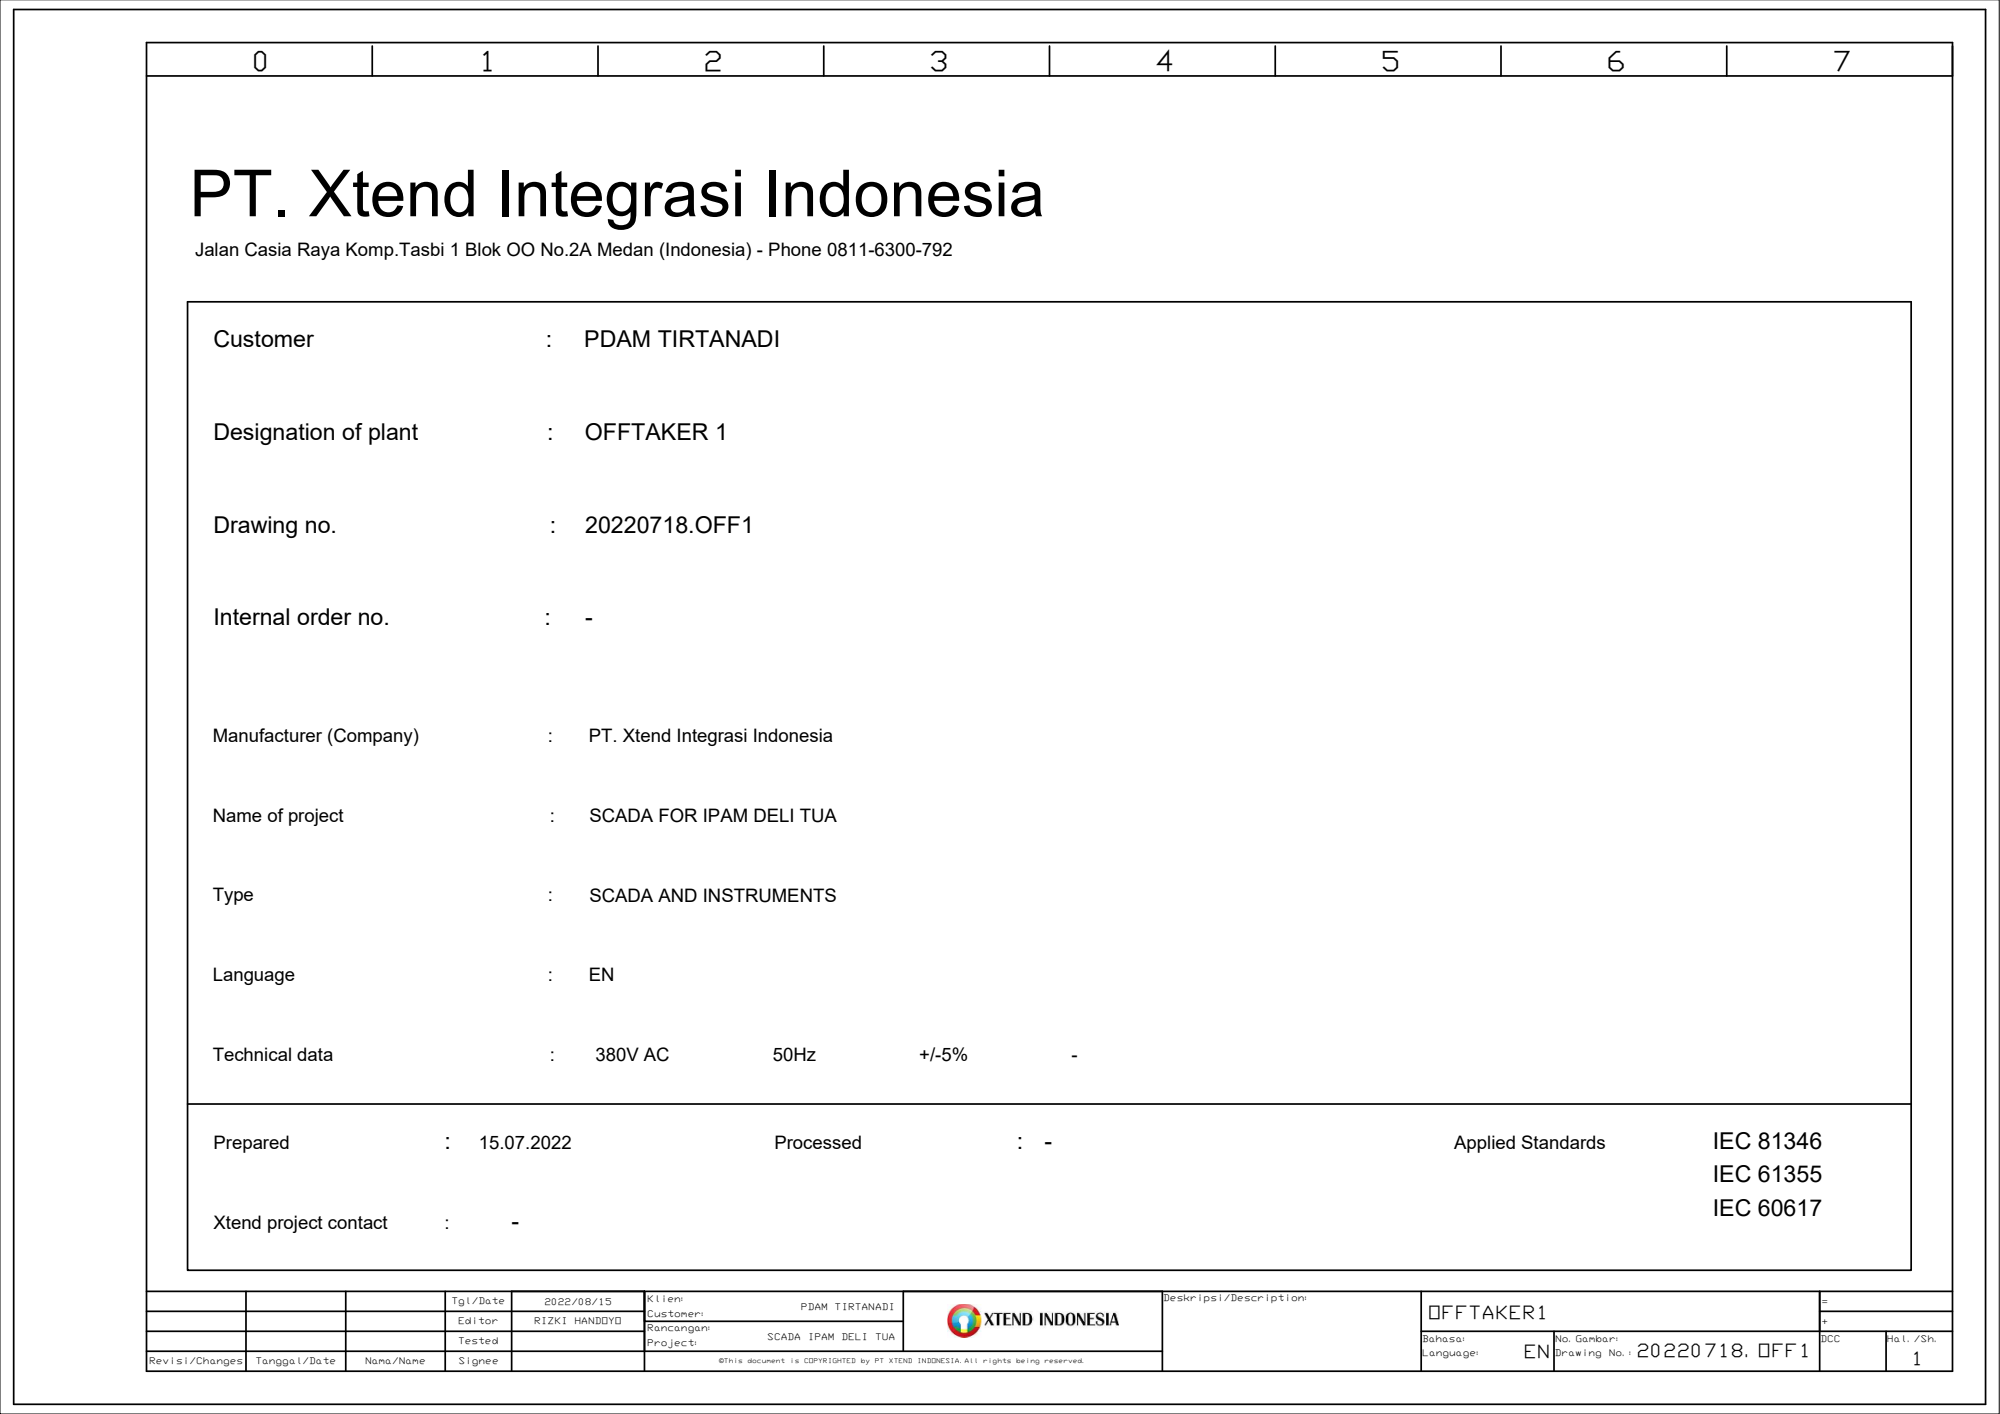
[picture p32: page 1]
Manufacturer (Company); Designation of plant; Drawing no.; Internal order no.; Name of project; Technical data; Xtend project contact; PDAM TIRTANADI; OFFTAKER 1; Processed; Applied Standards; IEC 81346; IEC 61355; IEC 60617

PT. Xtend Integrasi Indonesia

Jalan Casia Raya Komp.Tasbi 1 Blok OO No.2A Medan (Indonesia) - Phone 0811-6300-792

SCADA FOR IPAM DELI TUA

SCADA AND INSTRUMENTS

Tgl/Date | | Klien: PDAM TIRTANADI Customer: | Deskripsi/Description: | OFFTAKER1 | =

Editor | RIZKI HANDOYO | | | | +
Tested | | | | Bahasa: EN Language: | No.Gambar: 20220718.OFF1 Drawing No.: | DCC | Hal./Sh.

SCADA IPAM DELI TUA

Revisi/Changes | Tanggal/Date | Nama/Name | Signee | | ©This document is COPYRIGHTED by PT XTEND INDONESIA.All rights being reserved.

Costumer:

# &EBH 2

SCADA IPAM DELI TUA

# Revision overview

Revision name | Revision comment | Revision on the basis of change | Page name | Author | Date

# &EBH 3

SCADA IPAM DELI TUA

# Overview structure indicator

Complete name | Labelling | Structure description | Complete name | Labelling | Structure description
&EAA | Document type | Cover sheet | +MCC.Q3.8 | Plant | Motor 8 Control Panel Q3
&EAB | Document type | Table of contents | +MCC.Q3.9 | Plant | Motor 9 Control Panel Q3
&EBH | Document type | Revision overview | +MCC.Q3.10 Plant | | Motor 10 Control Panel Q3
&EDB | Document type | Structure indentification overview / intruction | +PT1 | Plant | Pressure Transmitter Q1
&EFS | Document type | Circuit diagram | +PT2 | Plant | Pressure Transmitter Q2
&ELU | Document type | Arrangement drawing | +PT3 | Plant | Pressure Transmitter Q3
&EMA | Document type | Terminal connection diagram / plan | +LT1A | Plant | Level Transmitter Reservoir 1A
&EMB | Document type | Cable layout | +LT1B | Plant | Level Transmitter Reservoir 1B
&EPB | Document type | Article parts list | +LT2A | Plant | Level Transmitter Reservoir 2A
=GENERAL | Plant | General Area | +LT2B | Plant | Level Transmitter Reservoir 2B
=TWP1 | Plant | Treated Water Pump 1 Area | +LTRV | Plant | Level Transmitter Reservoir RV
=TWR1 | Plant | Treated Water Reservoir 1 Area | +PLC | Plant | PLC Panel
+MCC.Q1.4 | Plant | Motor 4 Control Panel Q1 | +FTQ1 | Plant | Flow Transmitter Q1
+MCC.Q2.5 | Plant | Motor 5 Control Panel Q2 | +FTQ2 | Plant | Flow Transmitter Q2
+MCC.Q2.6 | Plant | Motor 6 Control Panel Q2 | +FTQ3 | Plant | Flow Transmitter Q3
+MCC.Q2.7 | Plant | Motor 7 Control Panel Q2 | --- | --- | ---

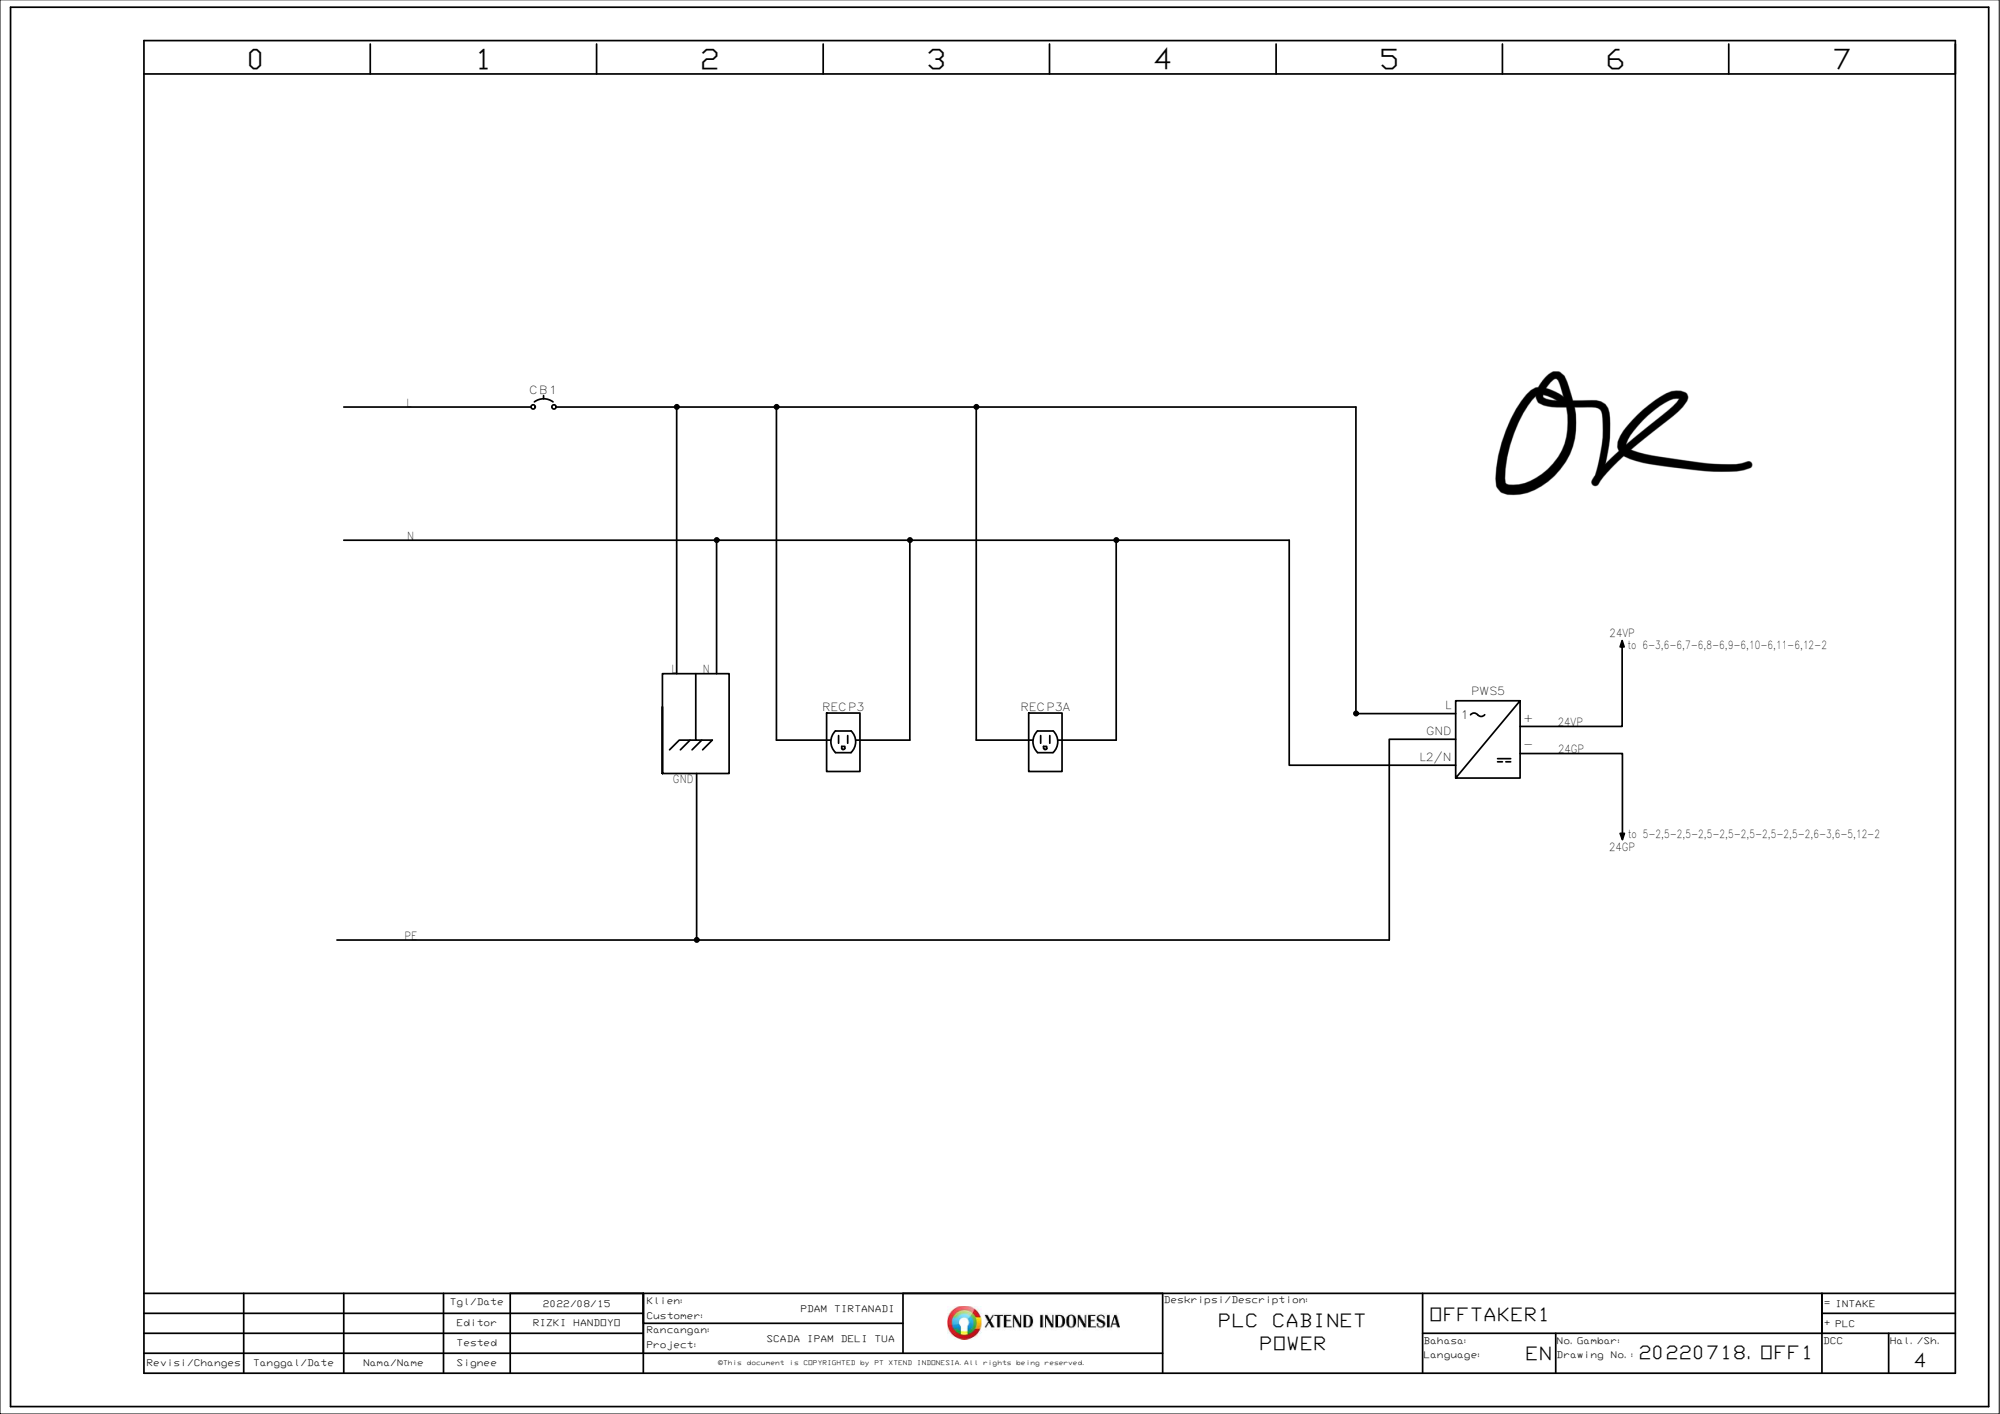
[picture p33: page 4]
SCADA IPAM DELI TUA; PLC CABINET; RECP3; RECP3A; 1 L GND

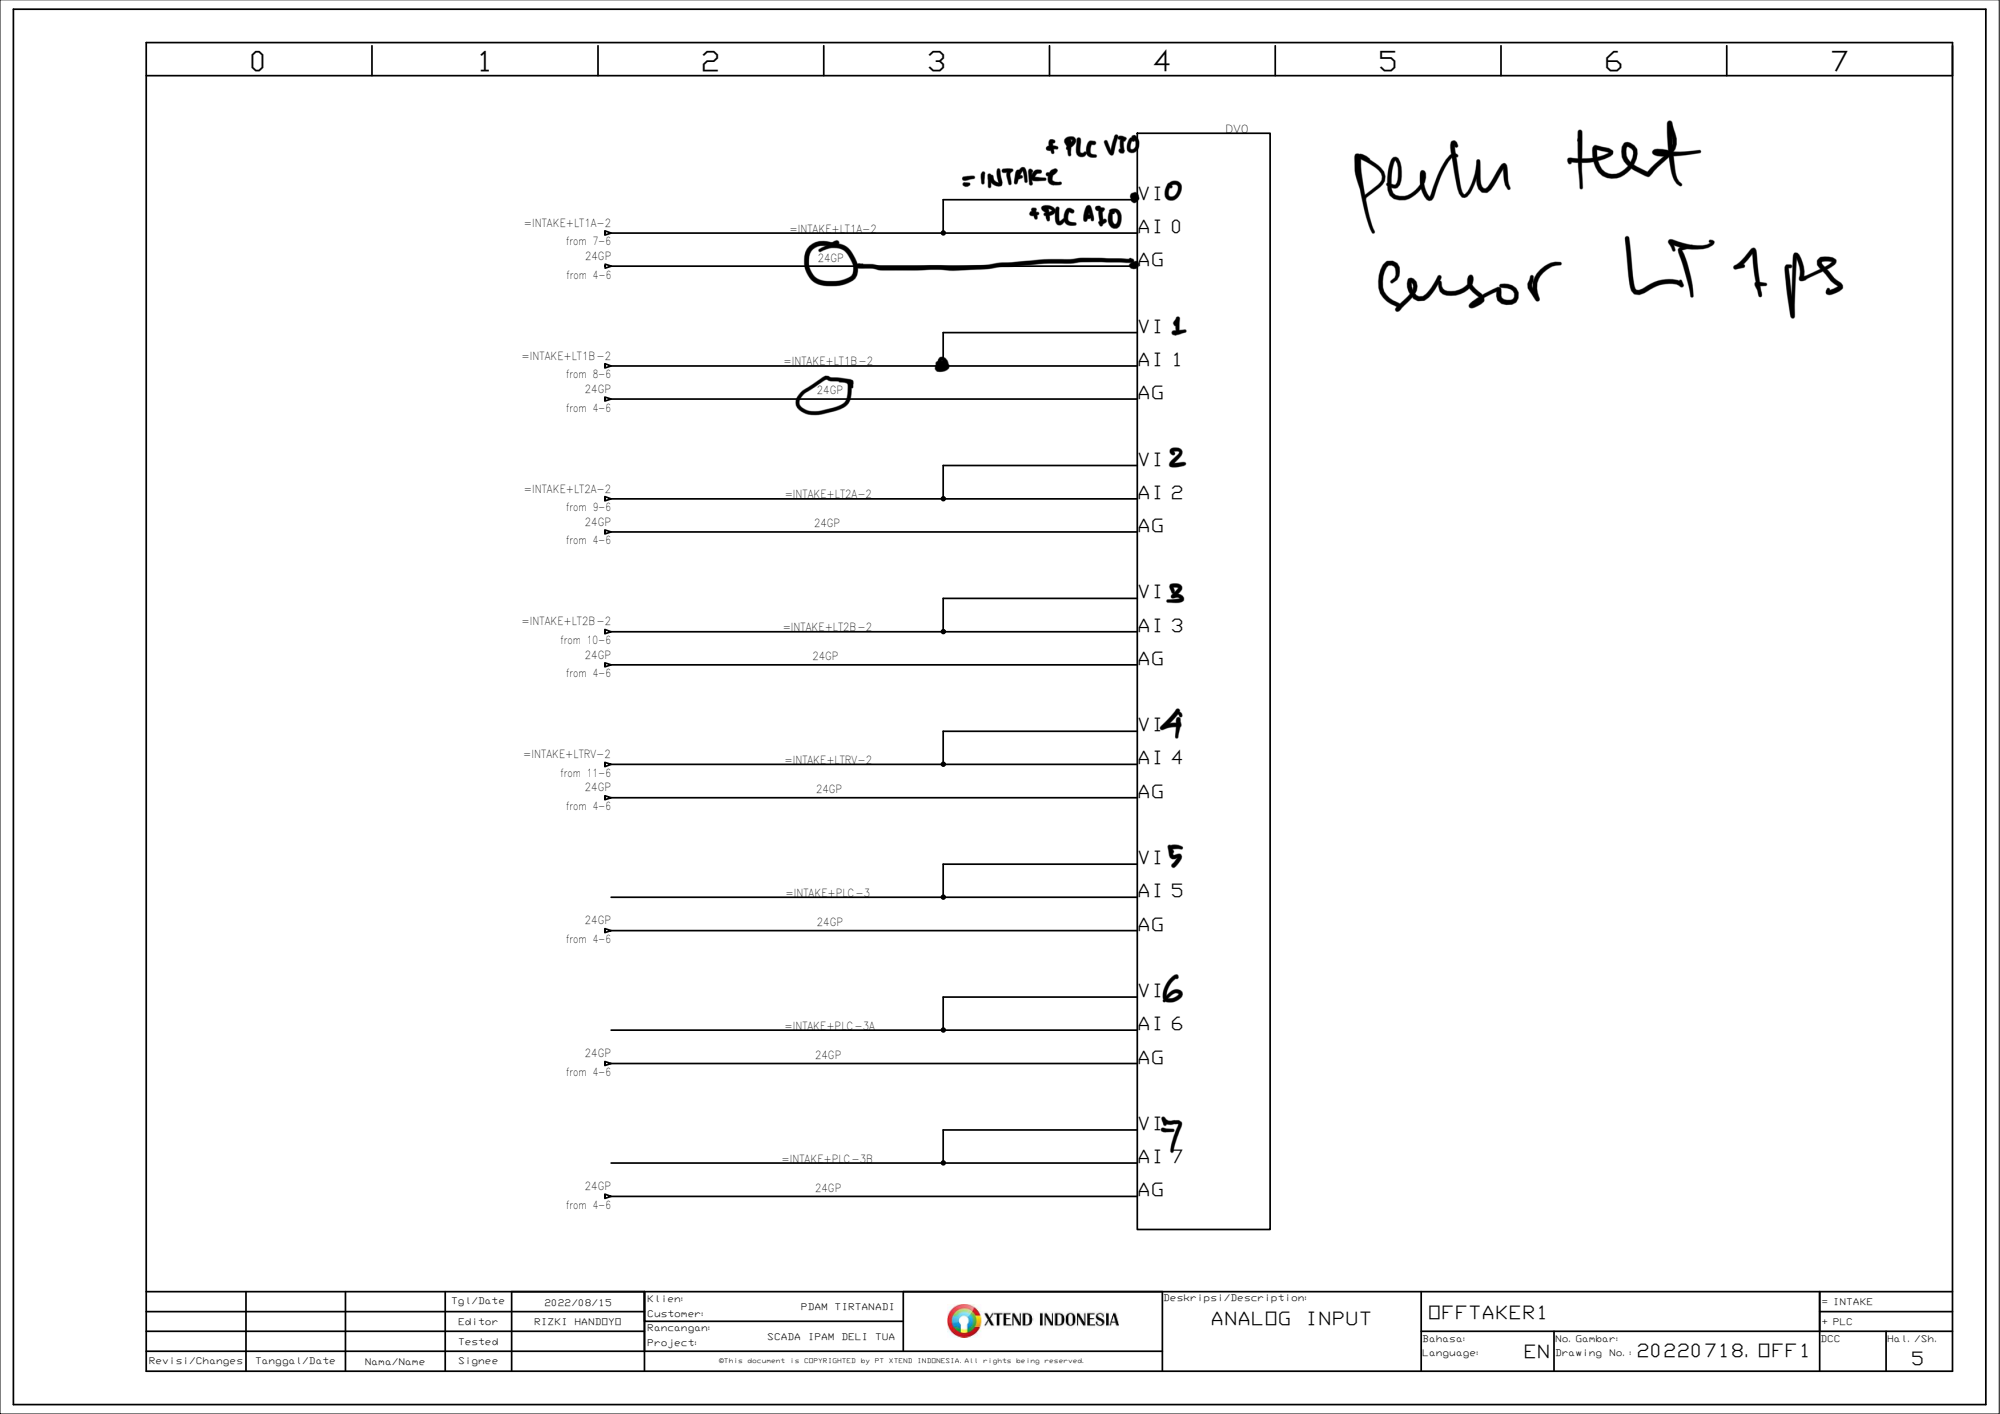
[picture p34: page 5]
SCADA IPAM DELI TUA; ANALOG INPUT; from 7-6; from 4-6; from 8-6; from 9-6; from 10-6; from 11-6

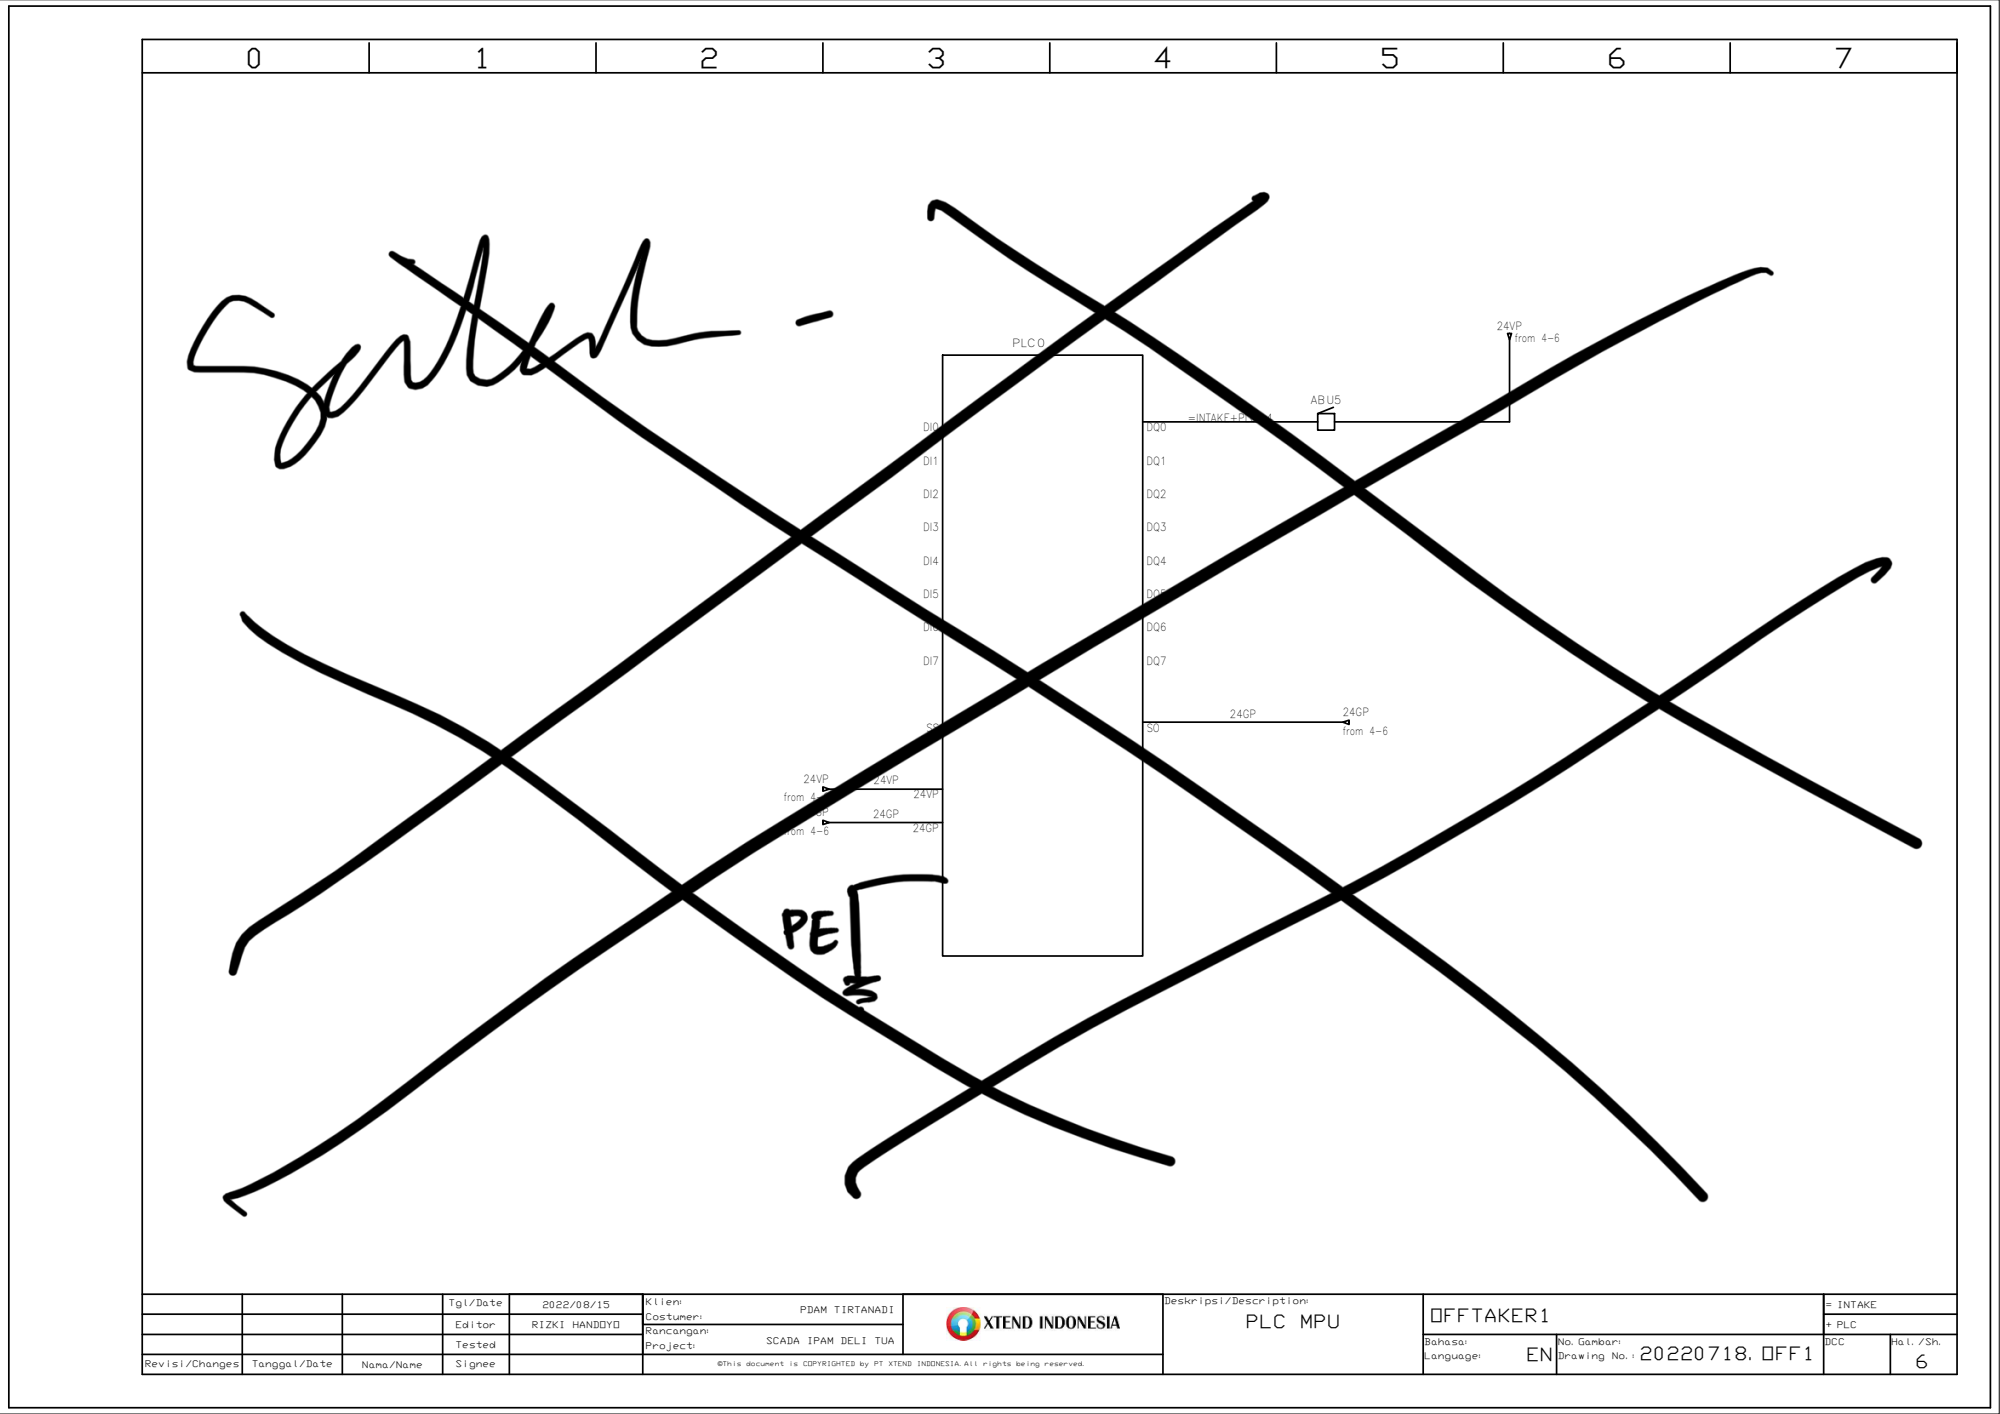
[picture p35: page 6]
SCADA IPAM DELI TUA; PLC MPU; from 4-6

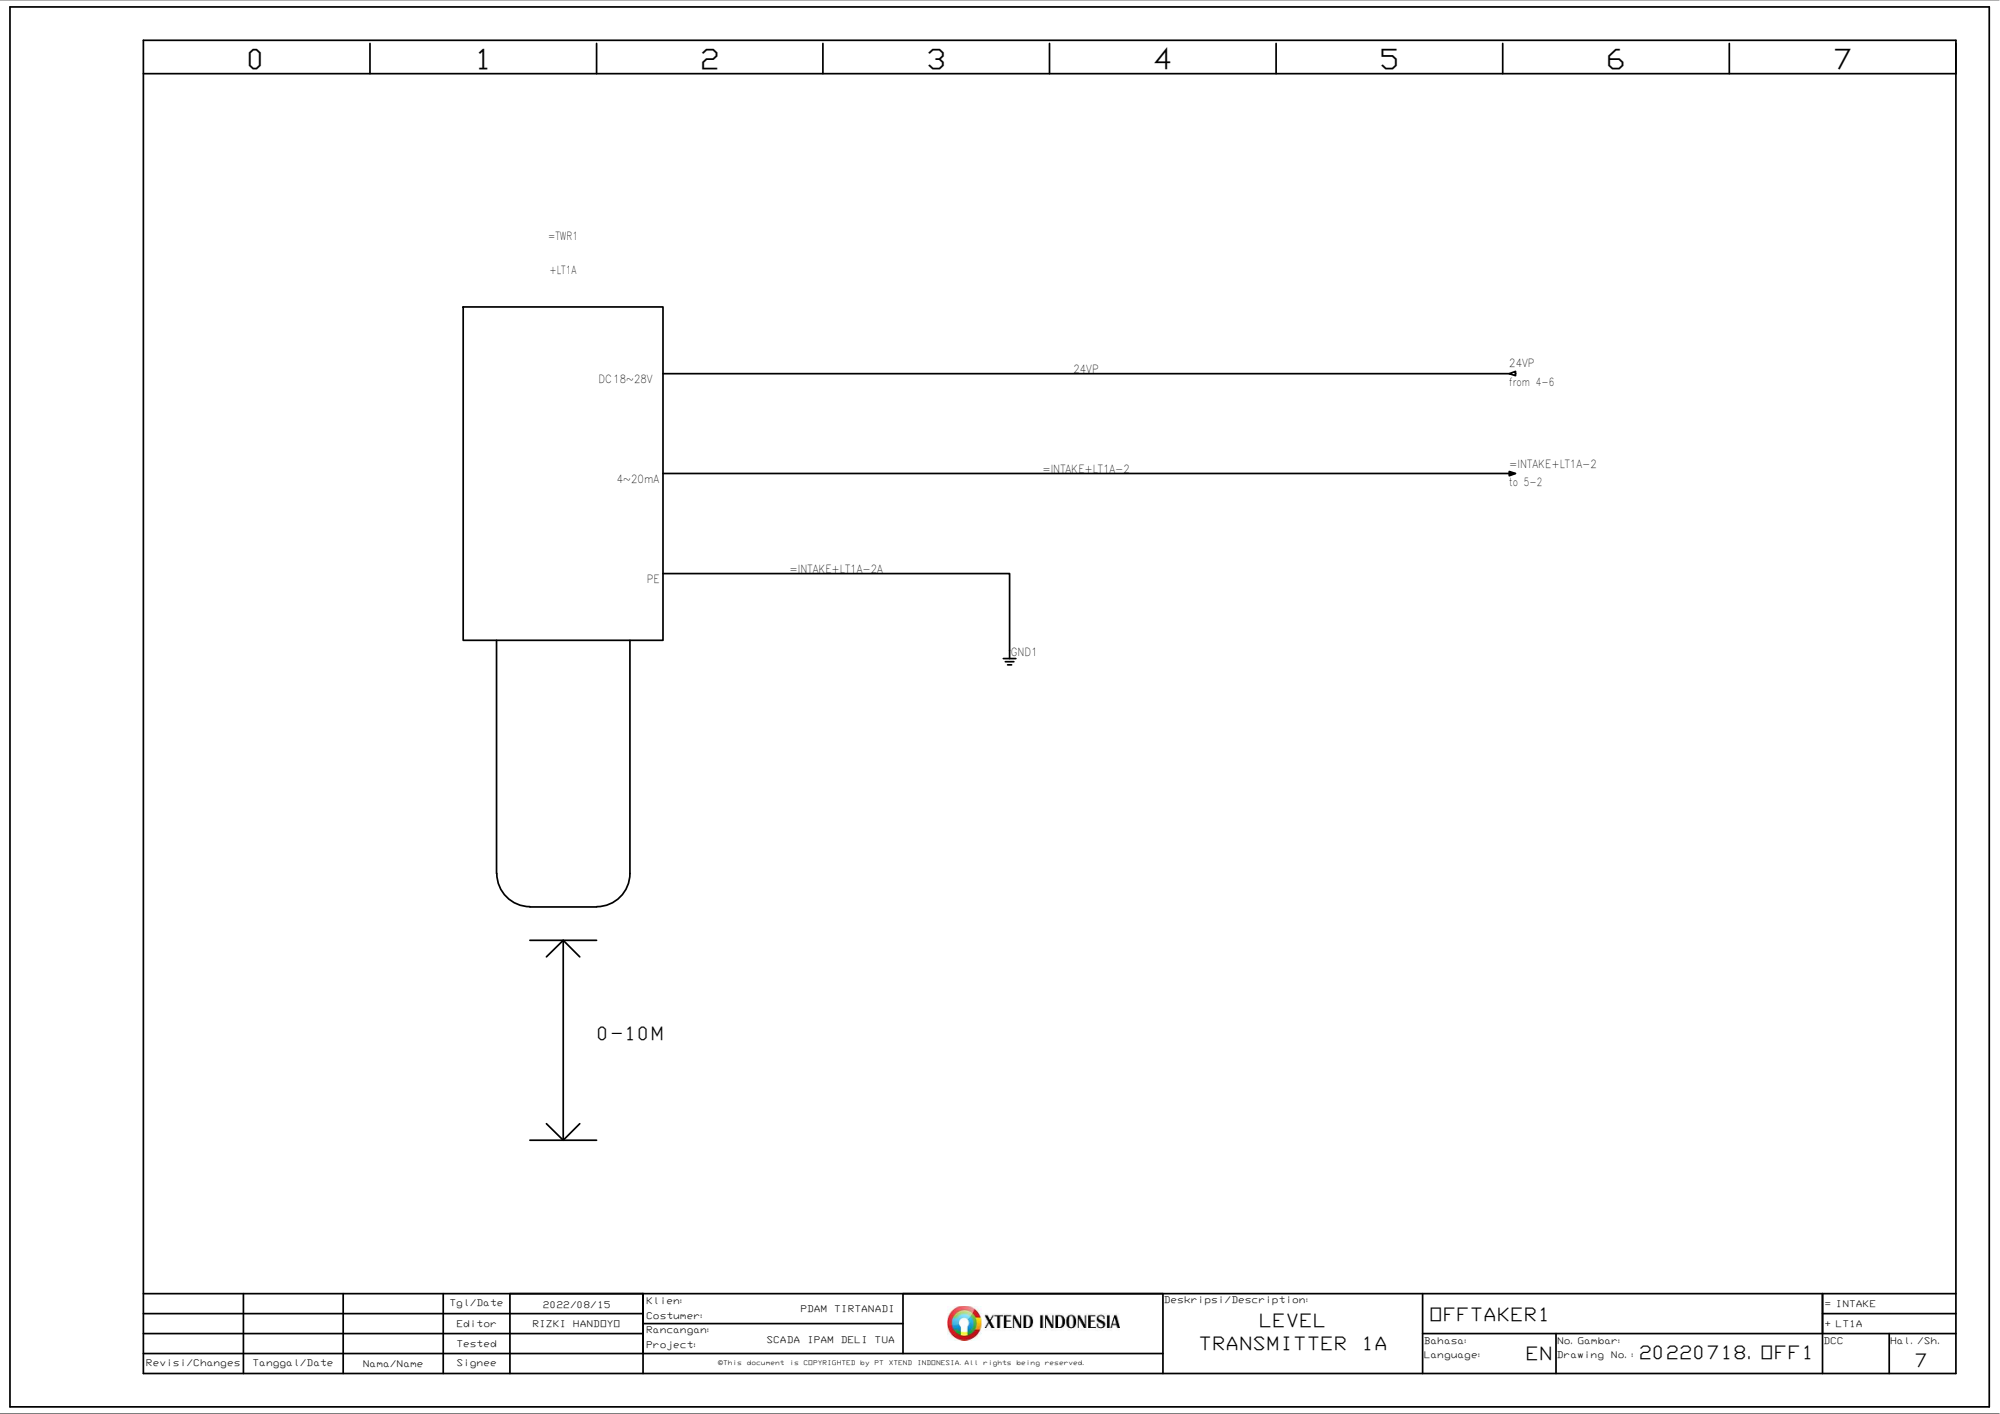
[picture p36: page 7]
SCADA IPAM DELI TUA; LEVEL; TRANSMITTER 1A; =TWR1 +LT1A; from 4-6

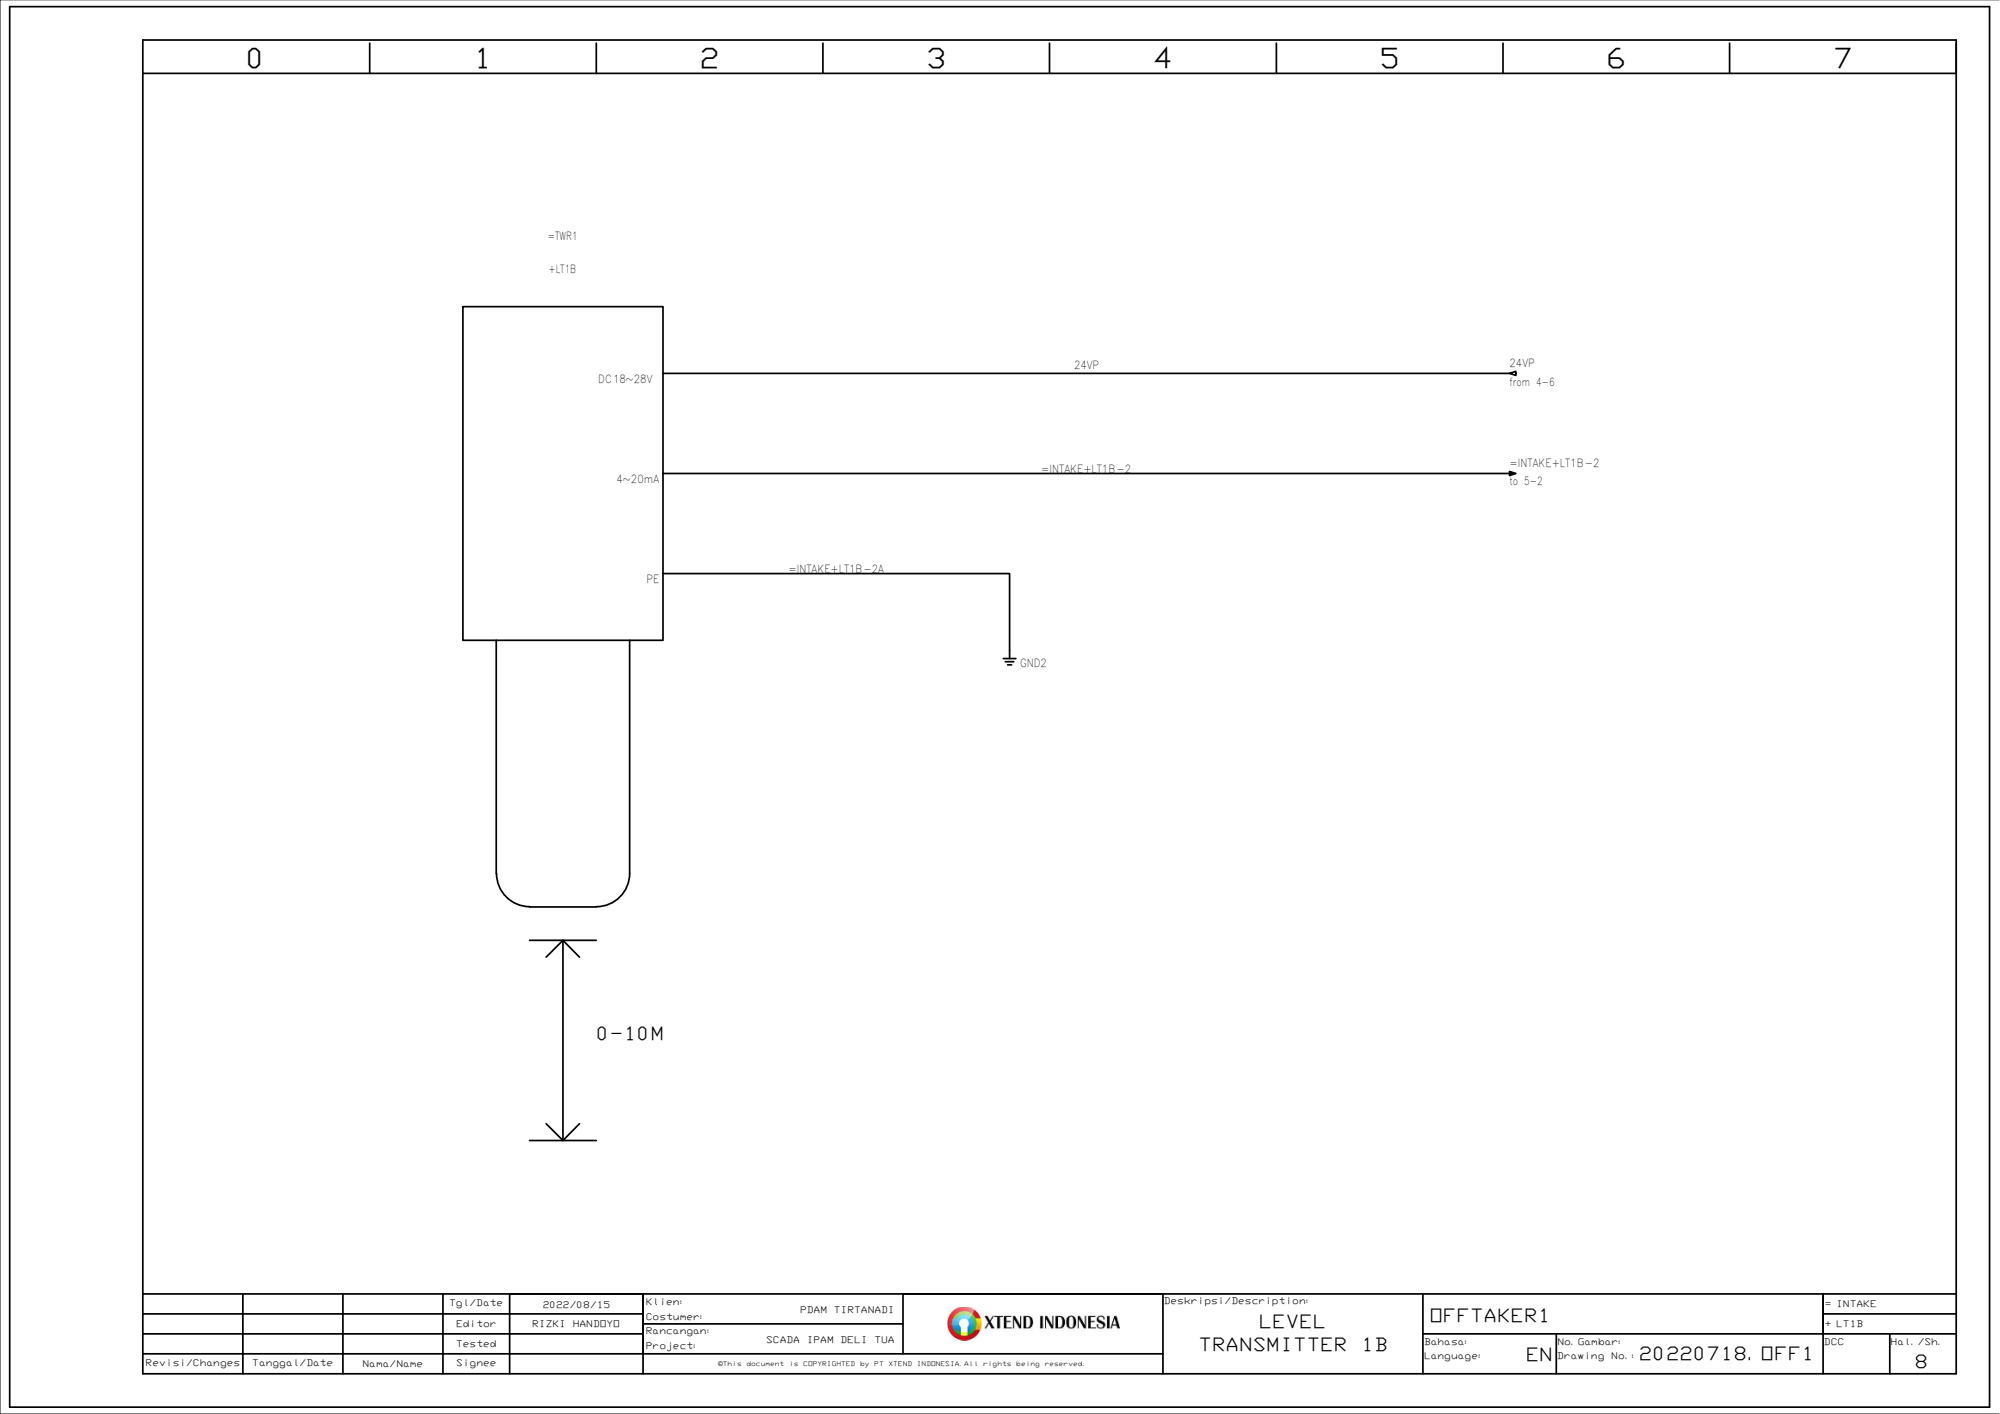
[picture p37: page 8]
SCADA IPAM DELI TUA; LEVEL; TRANSMITTER 1B; =TWR1 +LT1B; from 4-6

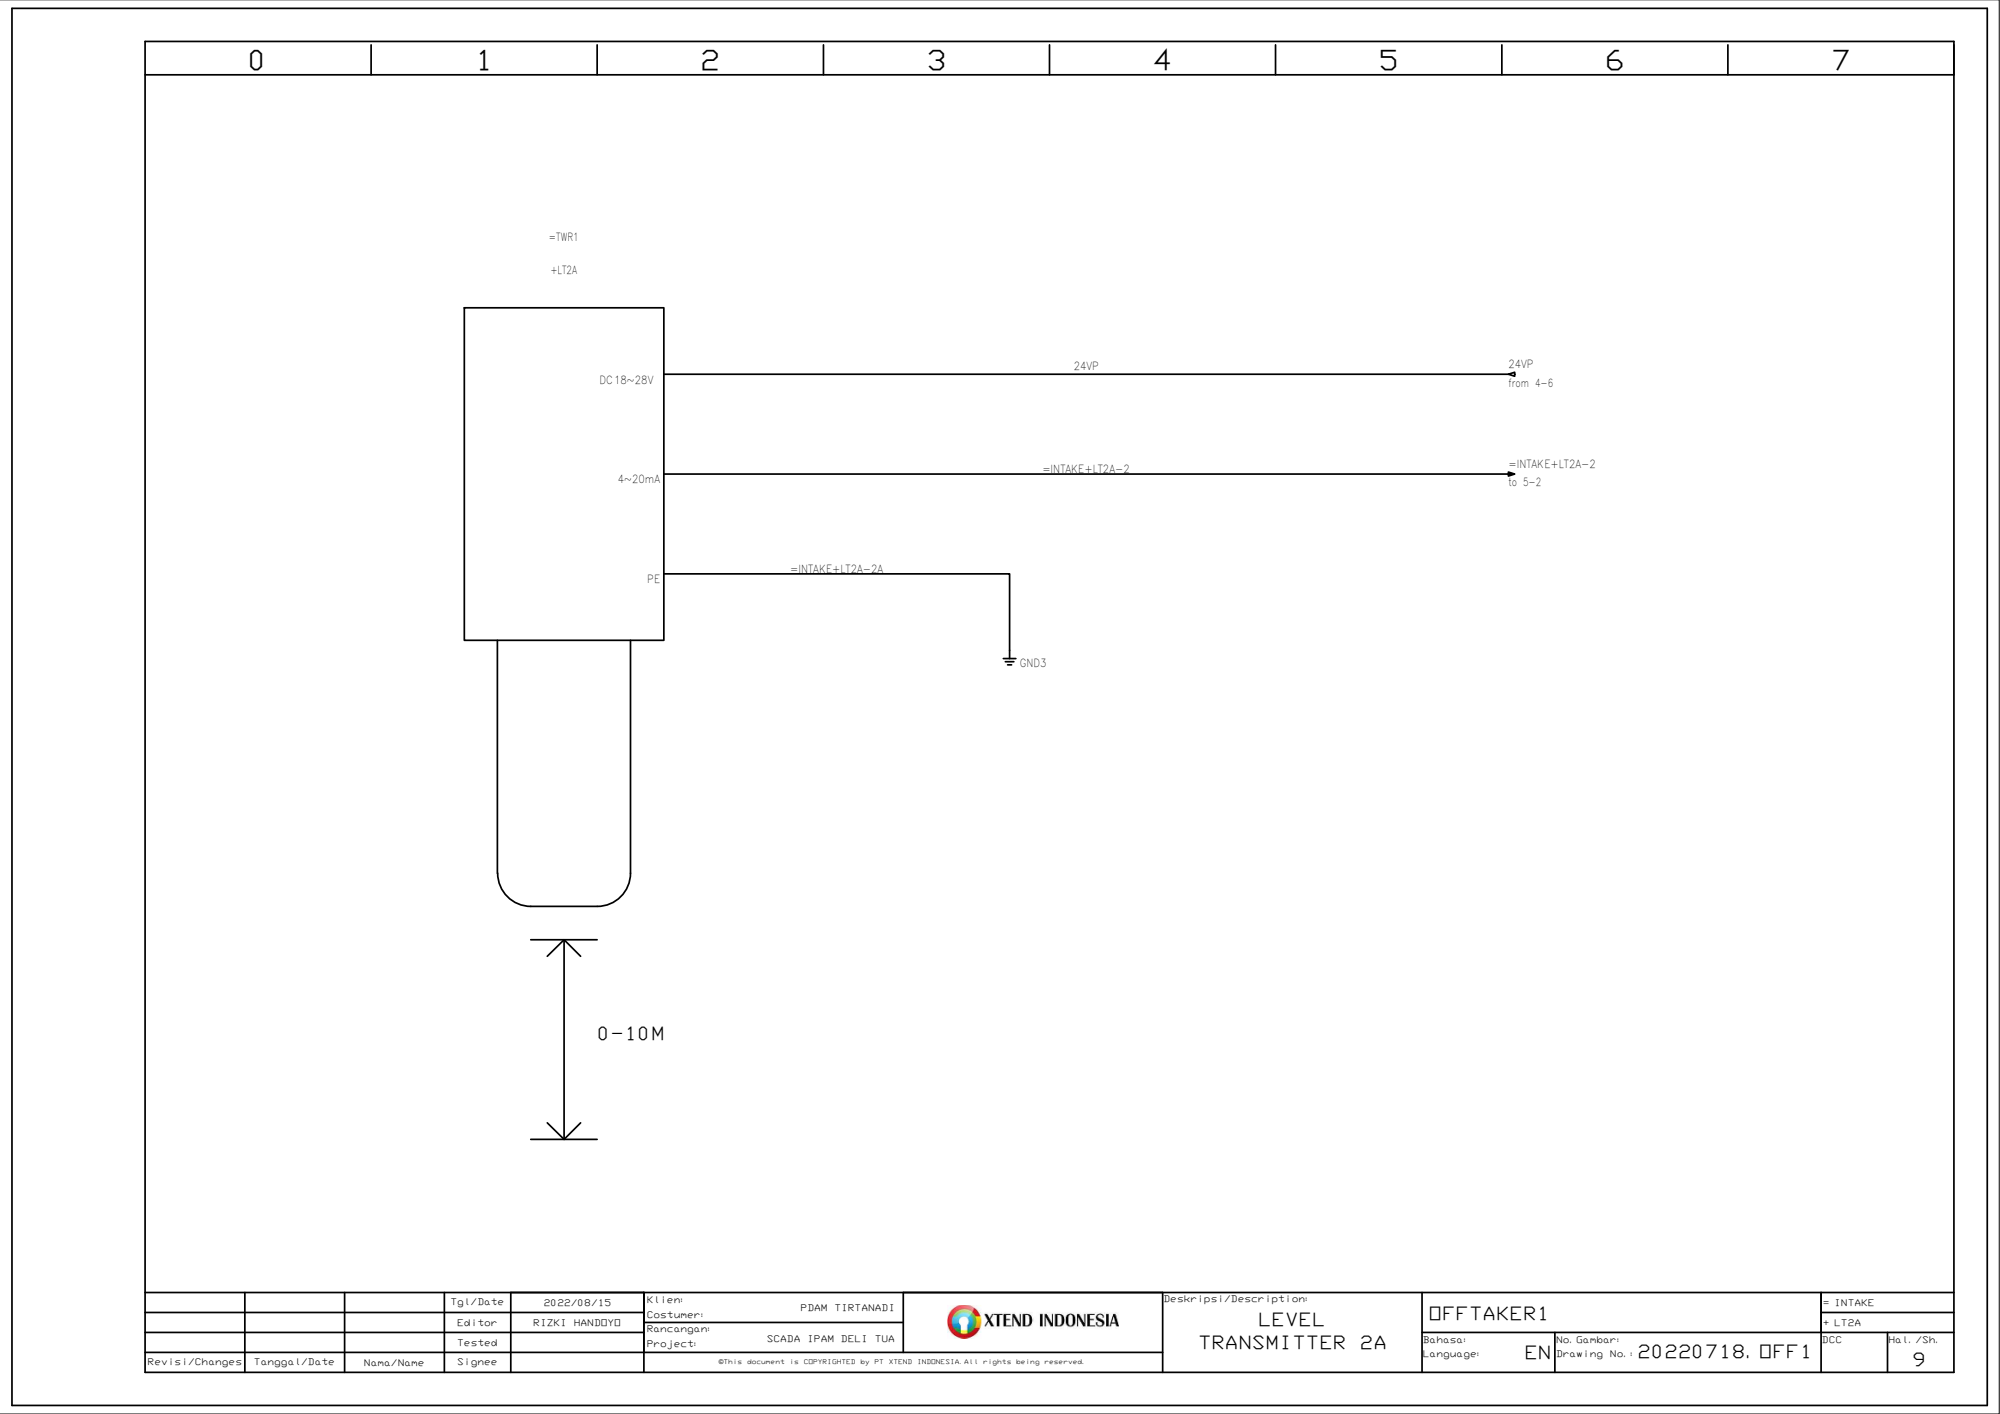
[picture p38: page 9]
SCADA IPAM DELI TUA; LEVEL; TRANSMITTER 2A; =TWR1 +LT2A; from 4-6

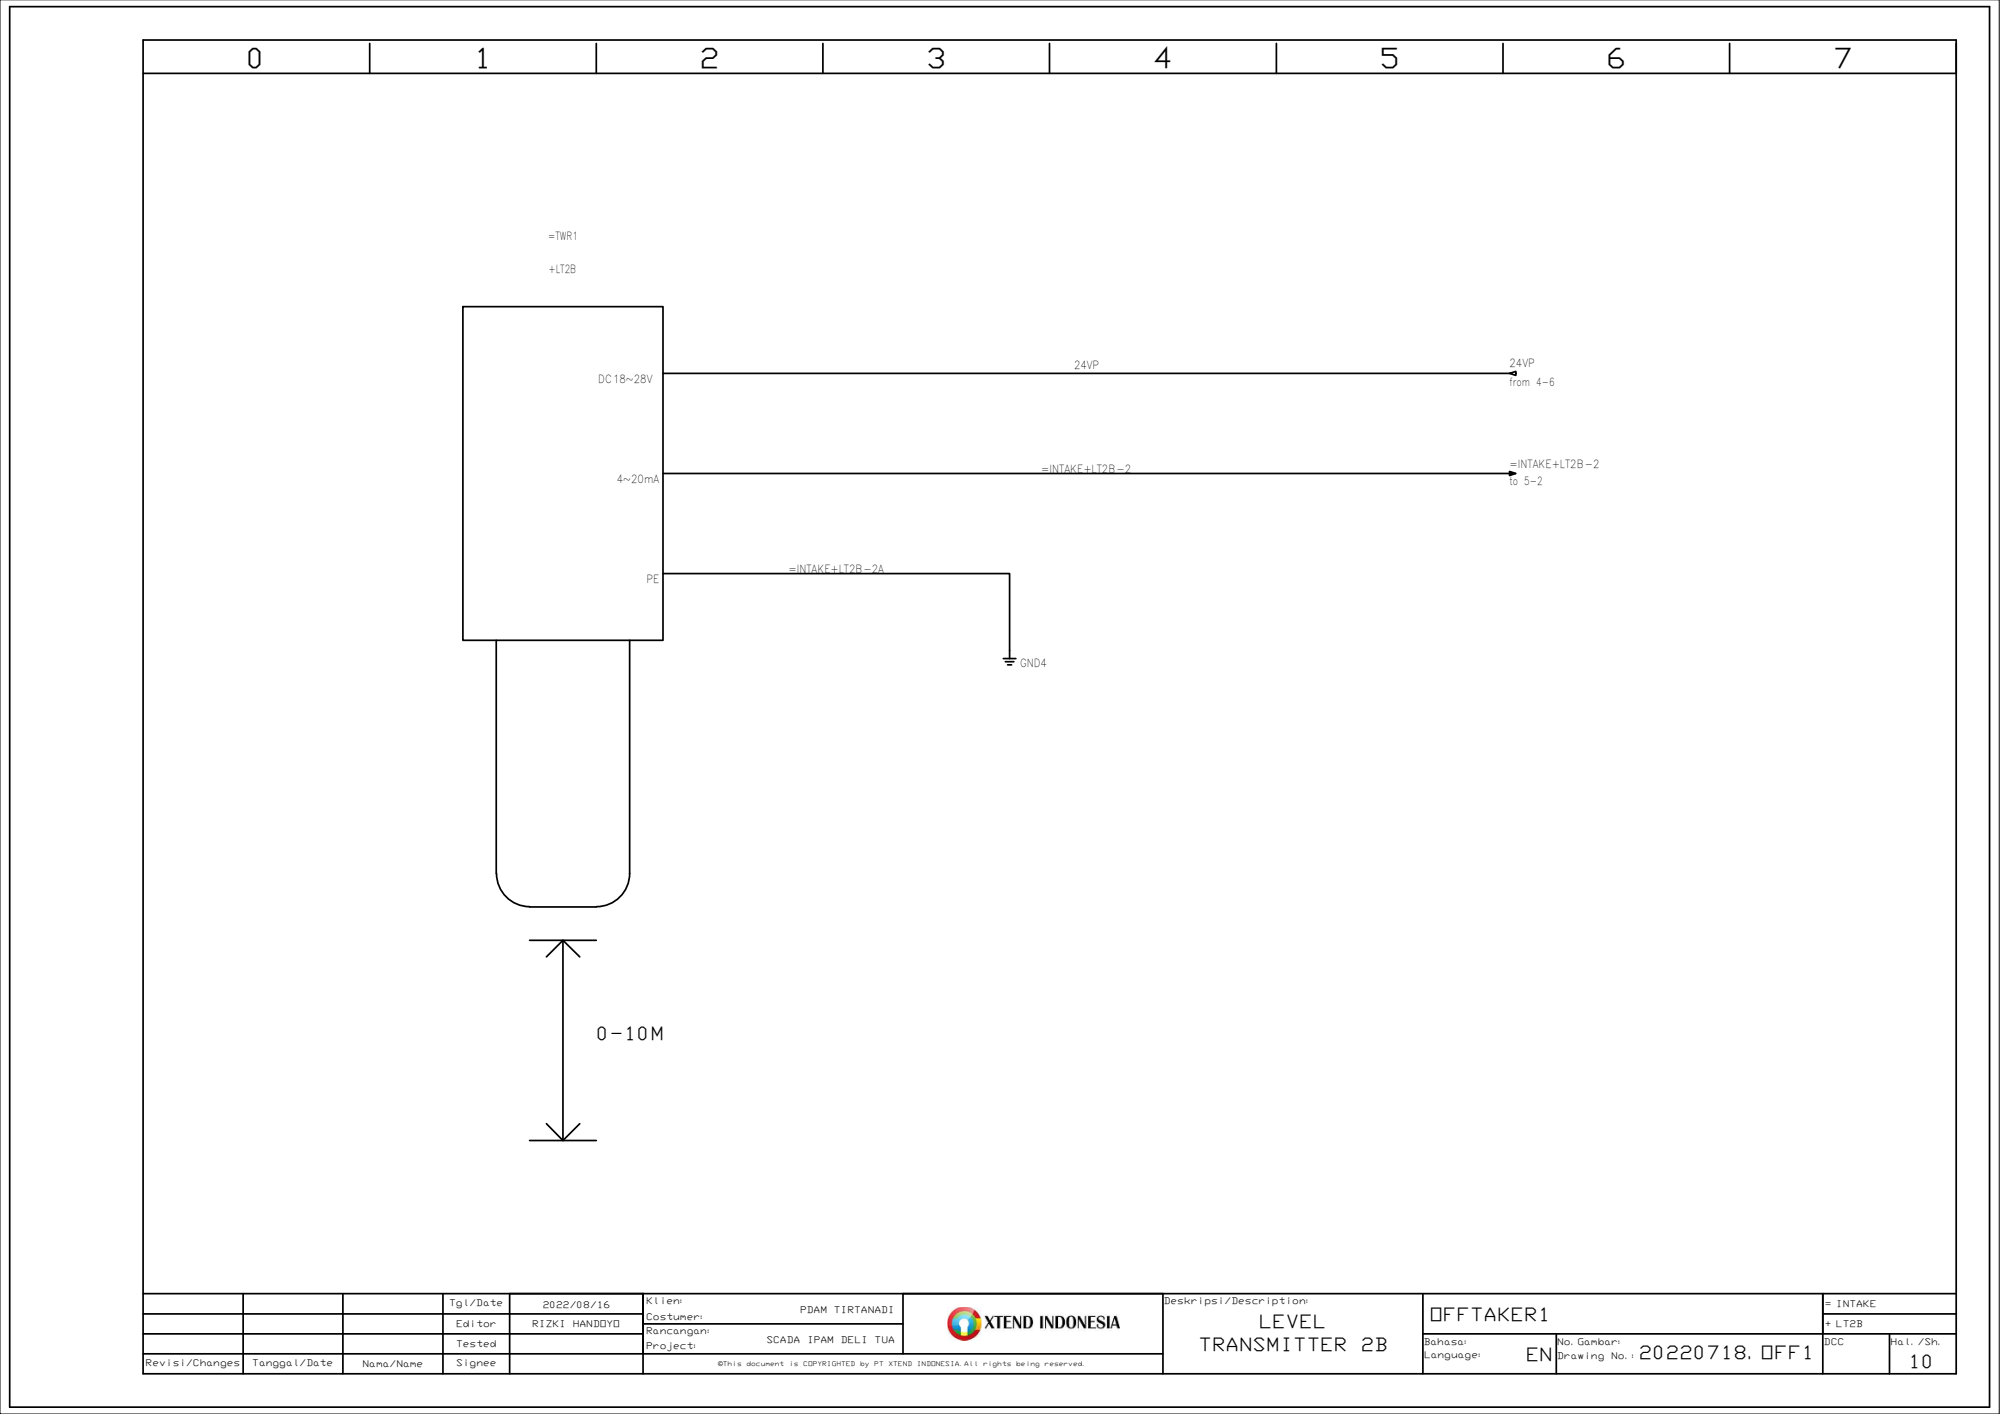
[picture p39: page 10]
SCADA IPAM DELI TUA; LEVEL; TRANSMITTER 2B; =TWR1 +LT2B; from 4-6

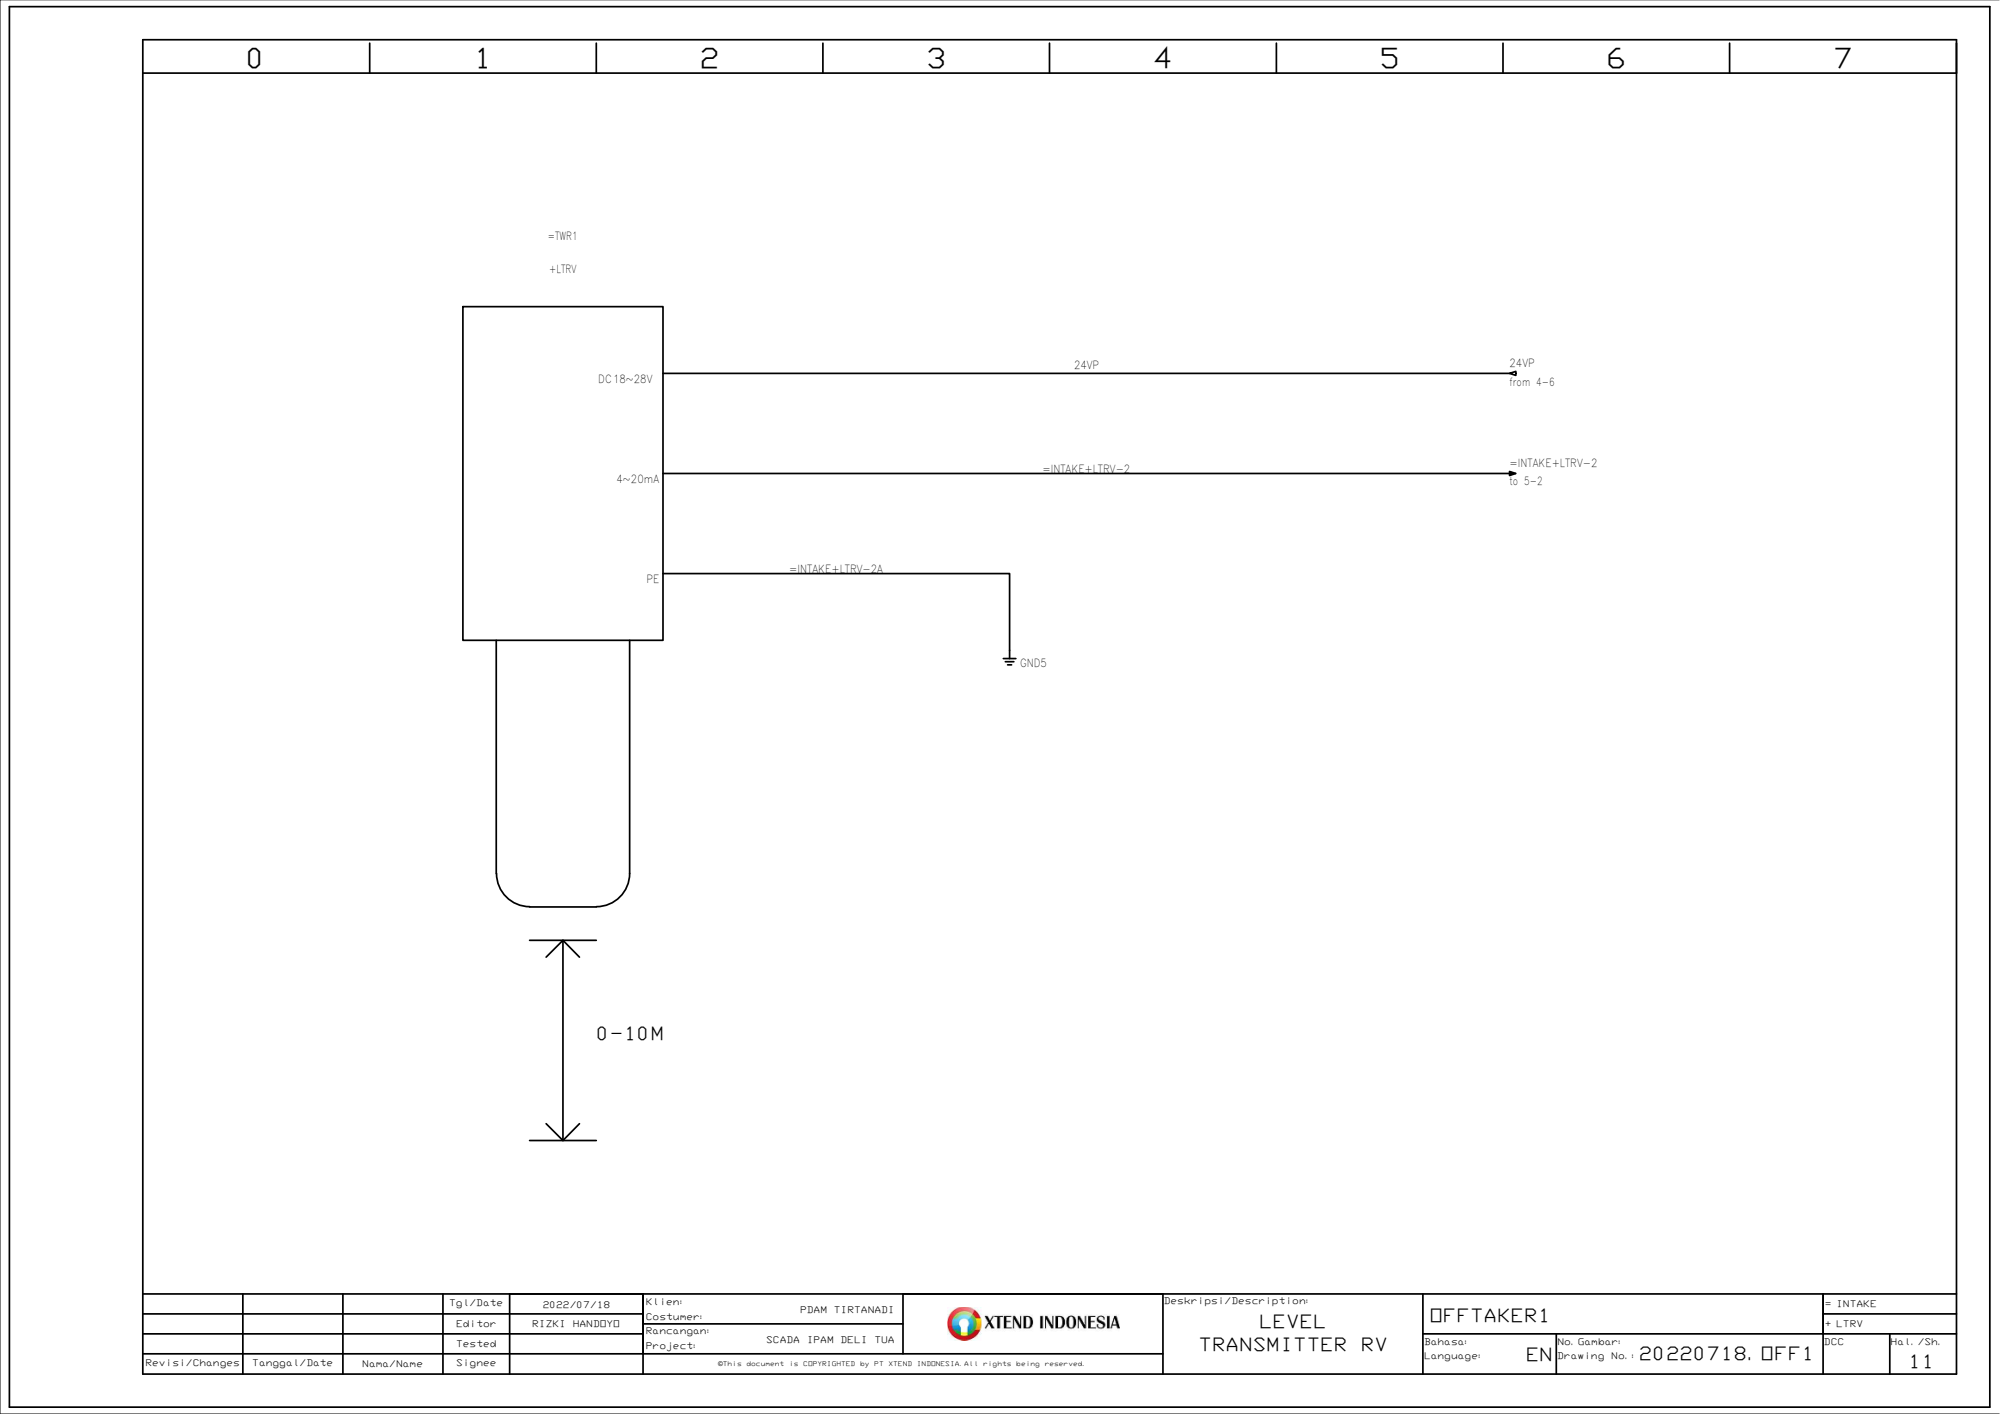
[picture p40: page 11]
SCADA IPAM DELI TUA; LEVEL; TRANSMITTER RV; =TWR1 +LTRV; from 4-6

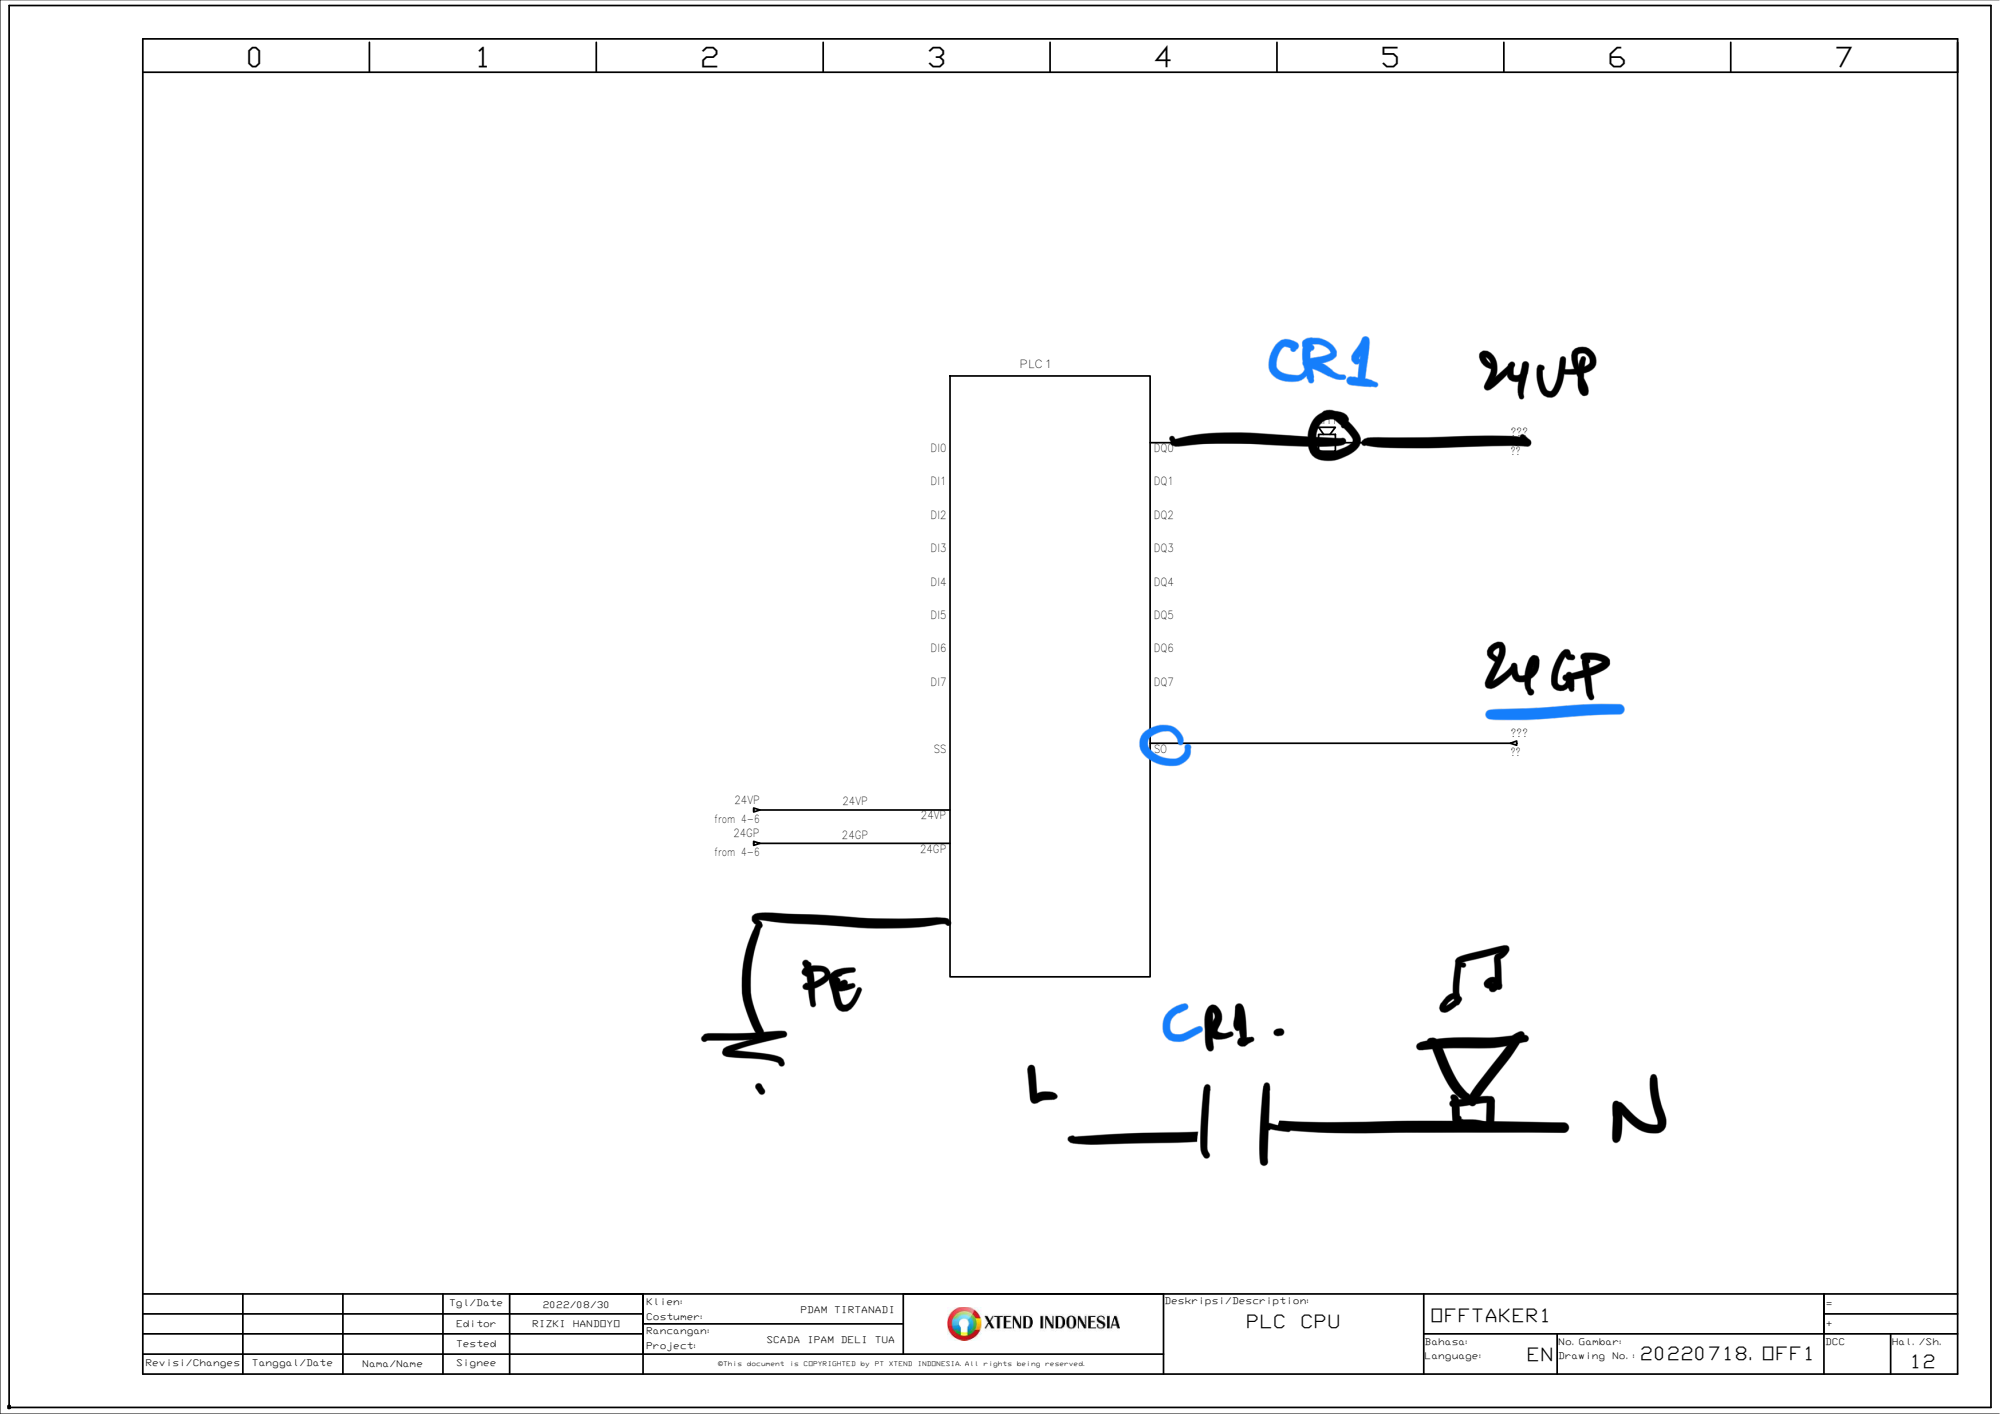
[picture p41: page 12]
SCADA IPAM DELI TUA; PLC CPU; from 4-6

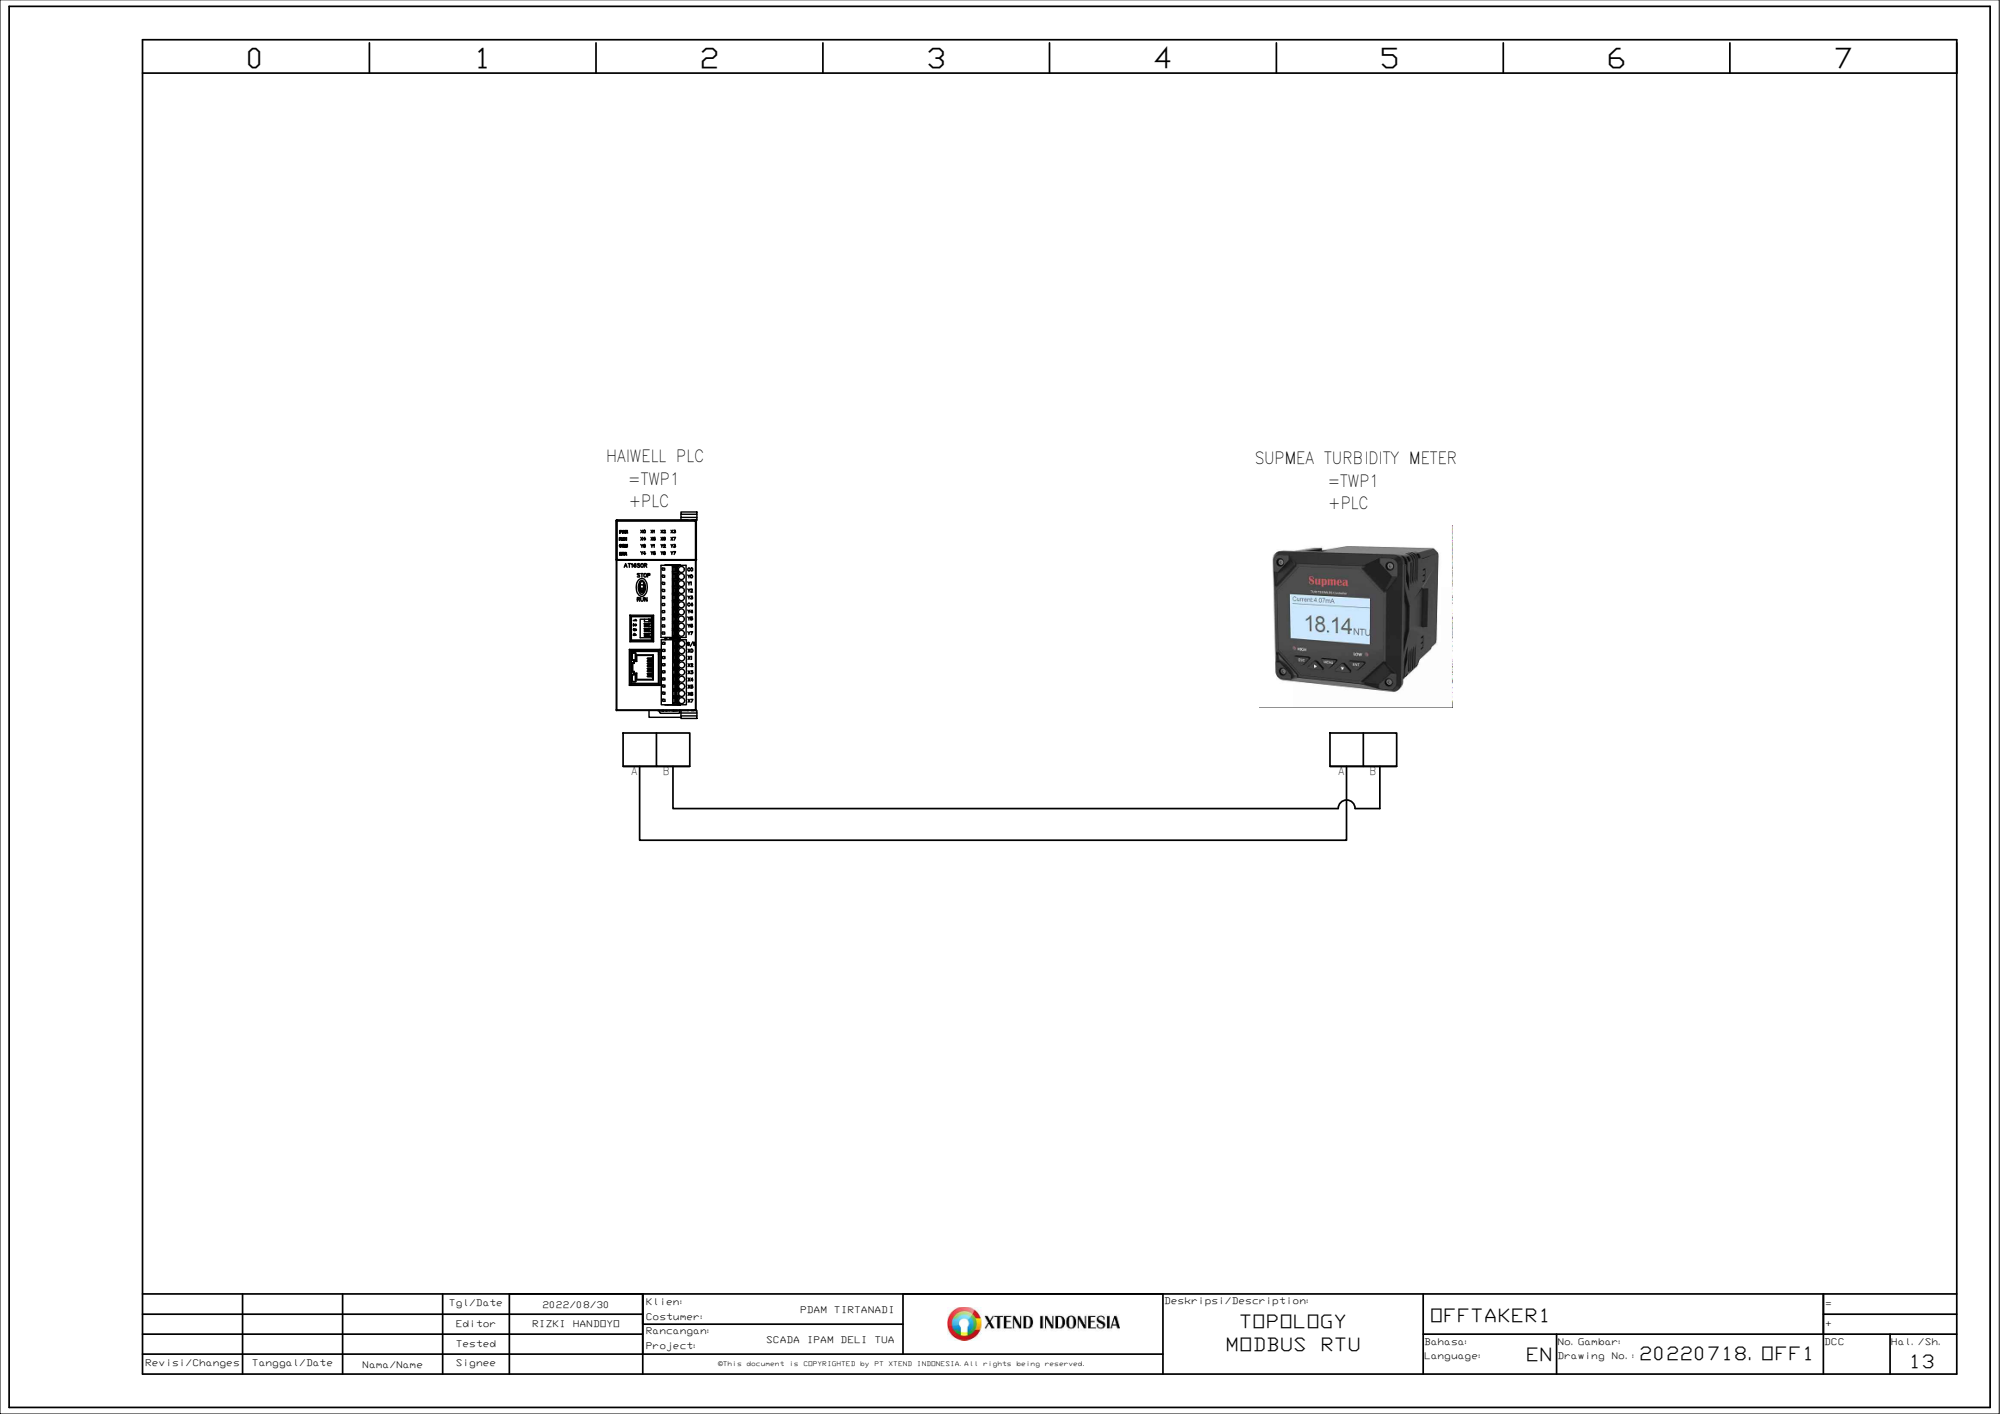
[picture p42: page 13]
SCADA IPAM DELI TUA; TOPOLOGY; MODBUS RTU; HAIWELL PLC

SUPMEA TURBIDITY METER

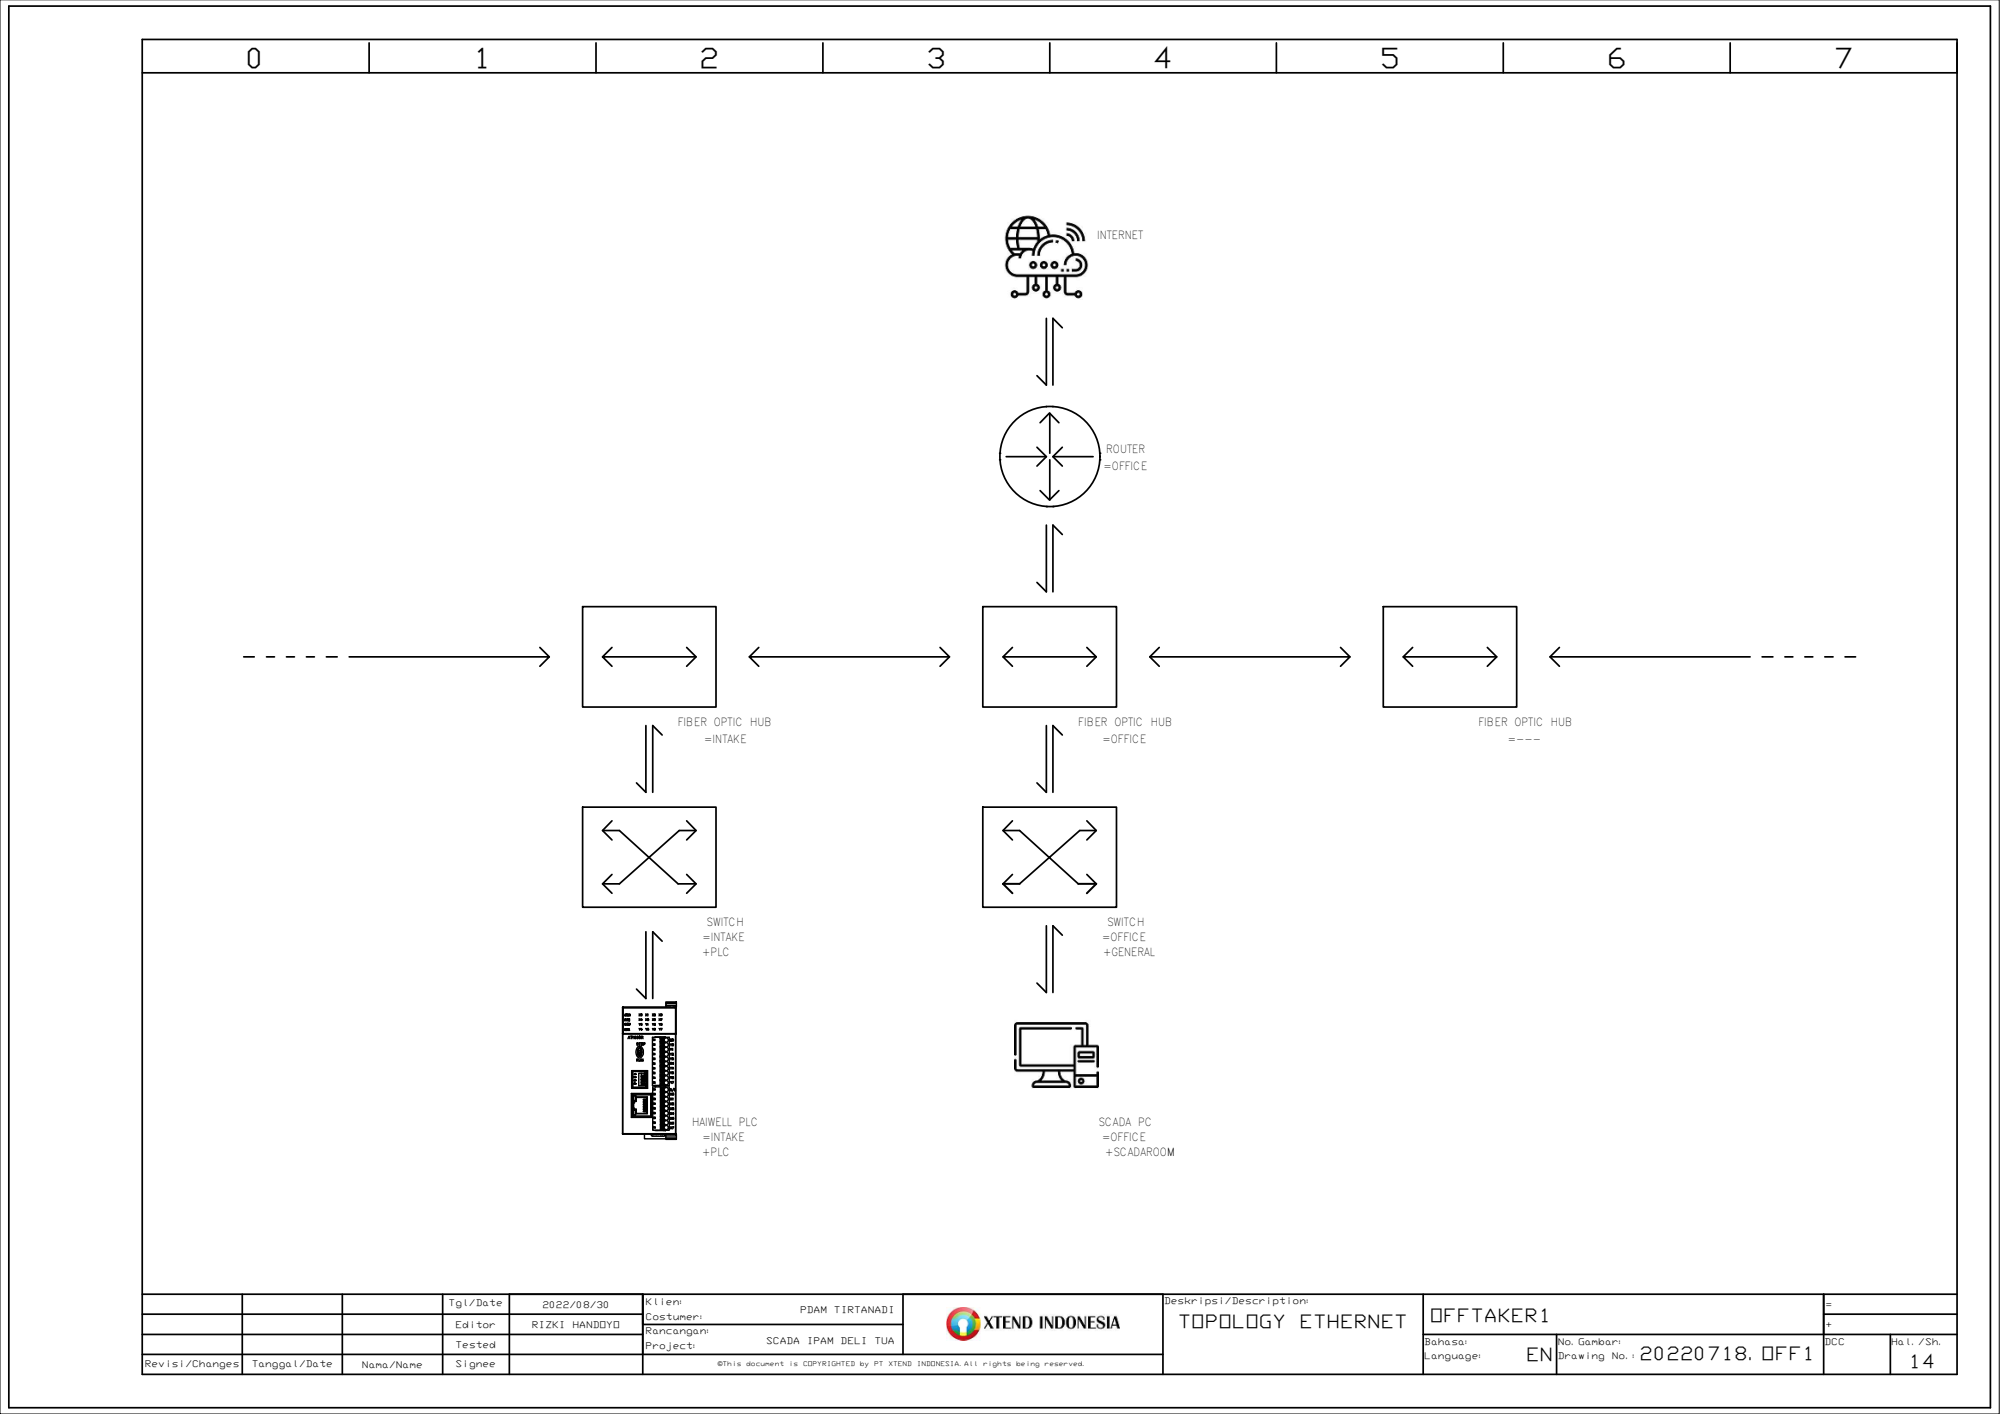
[picture p43: page 14]
SCADA IPAM DELI TUA; TOPOLOGY ETHERNET; ROUTER =OFFICE; HAIWELL PLC; =OFFICE +SCADAROOM

FIBER OPTIC HUB =INTAKE

FIBER OPTIC HUB =OFFICE

FIBER OPTIC HUB =---

SWITCH =OFFICE +GENERAL SWITCH =INTAKE +PLC

SCADA PC =INTAKE +PLC
